QuarkBaellchen5/active-balancing/Dokumentation/Anleitung/Übersicht.jpeg

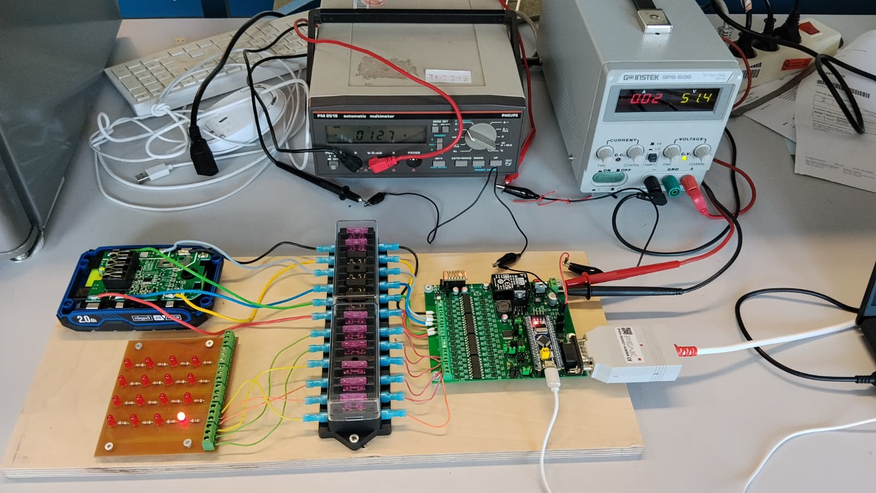
Dokumentation/Anleitung/Übersicht.jpeg
