QuarkBaellchen5/active-balancing/Dokumentation/Anleitung/Übersicht_Platine_2.png

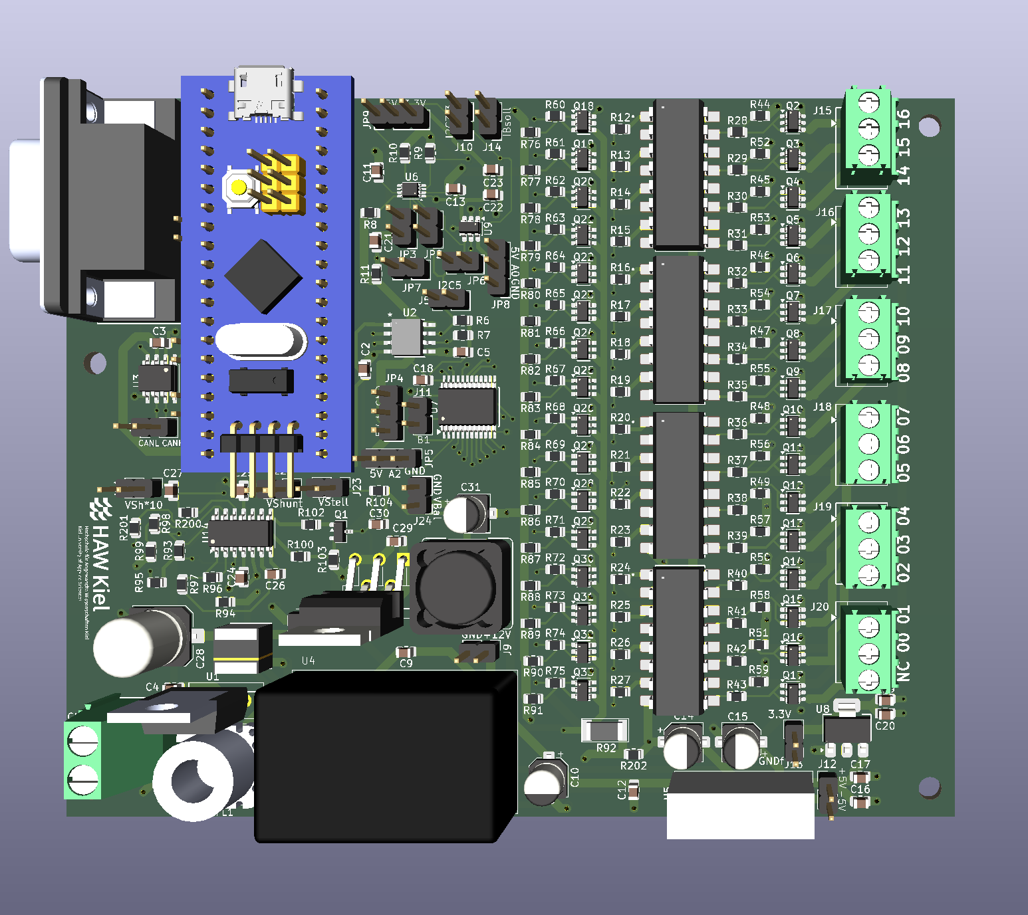
Dokumentation/Anleitung/Übersicht_Platine_2.png
