QuarkBaellchen5/active-balancing/Dokumentation/Ausgangspins.pptx

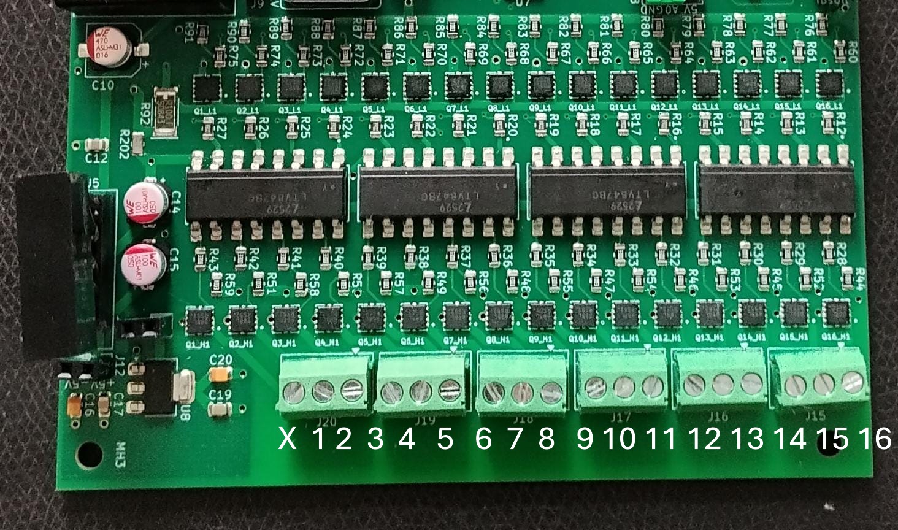
[picture p6: figure]

Lowside-MOSFET 1

Highside-MOSFET 1
