QuarkBaellchen5/active-balancing/Dokumentation/Thermische Analyse/Mosfet_thermische Simulation.pdf

TA4

30

RTH_JA1
52

PV4

PWL(0 0 10m 0.05 500 0.05 501 0.1125 1000 0.1125 1001 0.2 1500 0.2 1501 0.3125 2000 0.3125 2001 0.45 2500 0.45)

TA5

30

RTH_JA2
52

PV5

PWL(0 0 10m 0.067 500 0.067 501 0.151 1000 0.151 1001 0.268 1500 0.268 1501 0.41875 2000 0.41875 2001 0.603 2500 0.603)

Mosfet_high

Mosfet_low

Mosfet: (NTTFS6H888NL)

Junction-to-case: 6.4 W/°C

Junction-to-ambient: 52W/°C

Leistung:

Highside: Vgs = ca. 10V -> Rdson 41-50 mΩ Verlustleistung:

P1 = 0.050Ω * 1A^2 = 0.05W
P2 = 0.050Ω * 1.5A^2 = 0.1125W
P3 = 0.050Ω * 2A^2 = 0.2W
P4 = 0.050Ω * 2.5A^2 = 0.3125W
P5 = 0.050Ω * 3A^2 = 0.45W

Lowside: Vgs = 4.5-5V -> Rdson = 53-67 mΩ Verlustleistung:

P1 = 0.067Ω * 1A^2 = 0.067W
P2 = 0.067Ω * 1.5A^2 = 0.151W
P3 = 0.067Ω * 2A^2 = 0.268W P4 = 0.067Ω * 2.5A^2 = 0.41875W P5 = 0.067Ω * 3A^2 = 0.603W

Quelle: Datenblatt
