QuarkBaellchen5/active-balancing/Dokumentation/Thermische Analyse/Bilder Waerme/Wärmevergleich_Messung.pptx

Ohne Kühlkörper

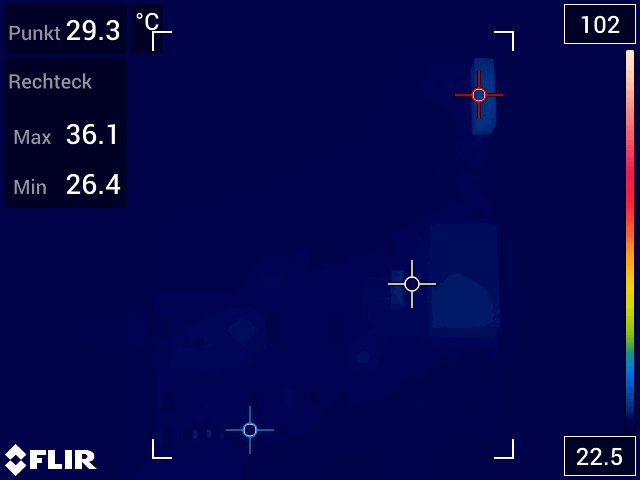
[picture p83: figure]

Regelstrom
0.0 A
0.1 A
0.5 A
1.0 A
1.5 A
2.0 A
2.5A

Mit Kühlkörper

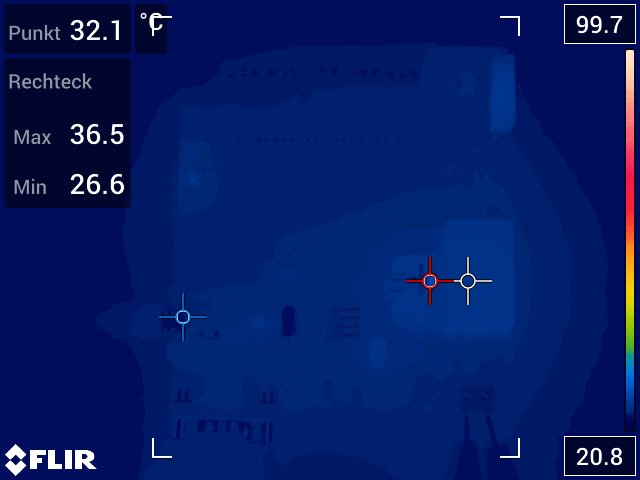
[picture p84: figure]
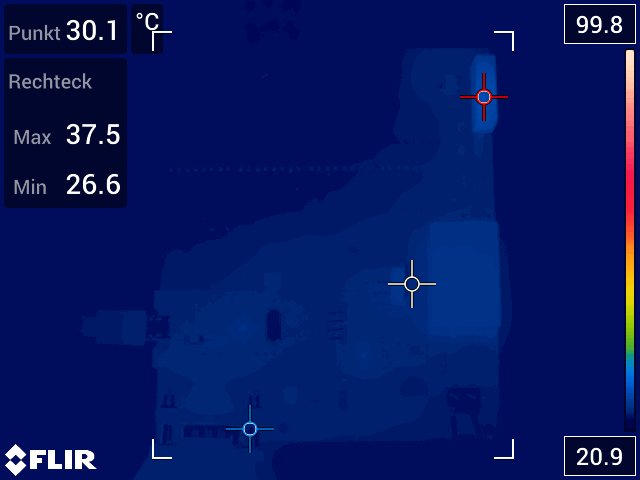
[picture p85: figure]
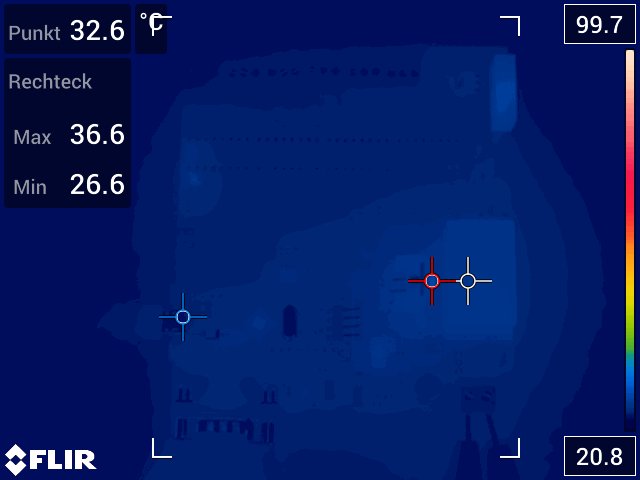
[picture p86: figure]
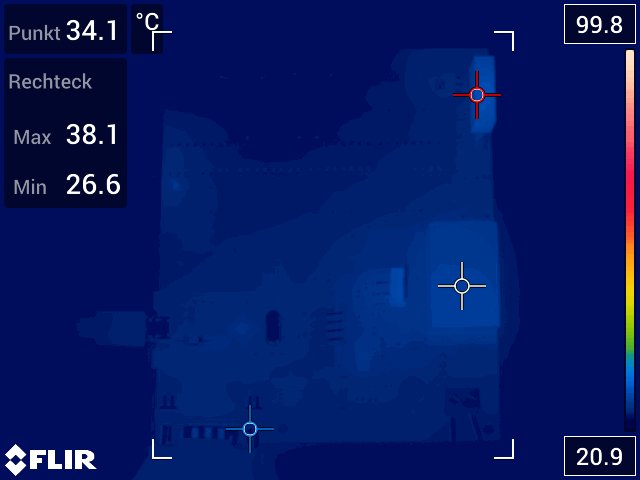
[picture p87: figure]
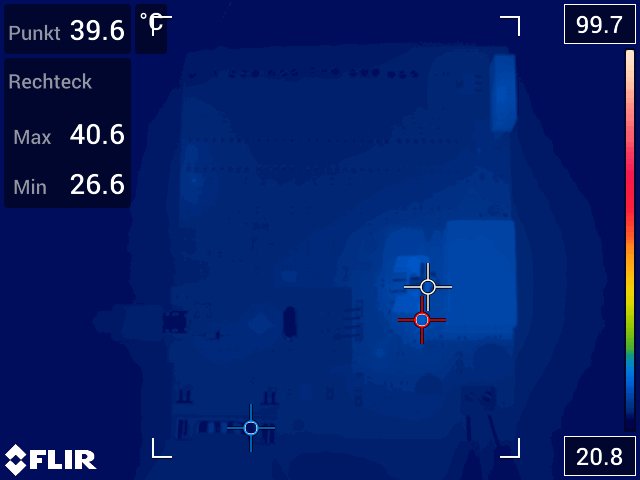
[picture p88: figure]
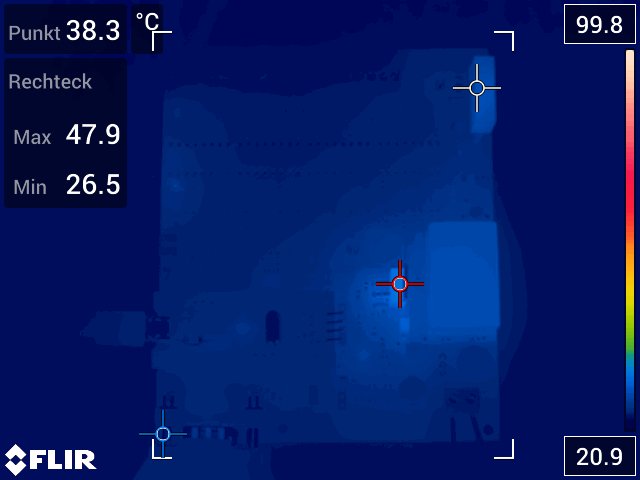
[picture p89: figure]
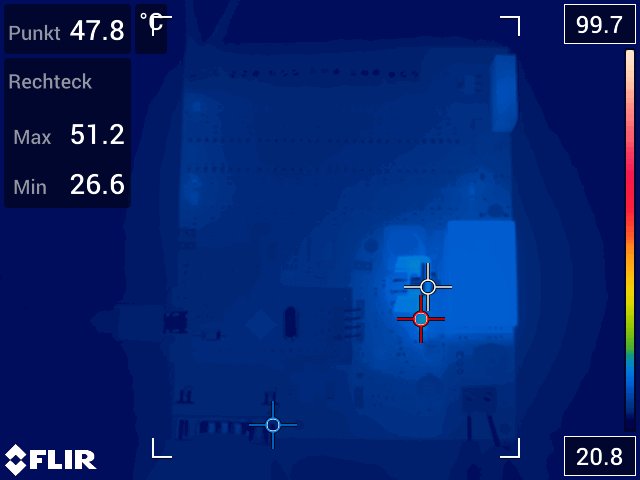
[picture p90: figure]
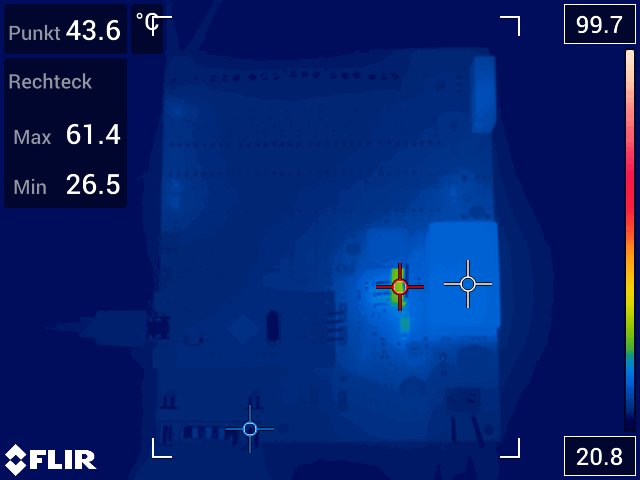
[picture p91: figure]
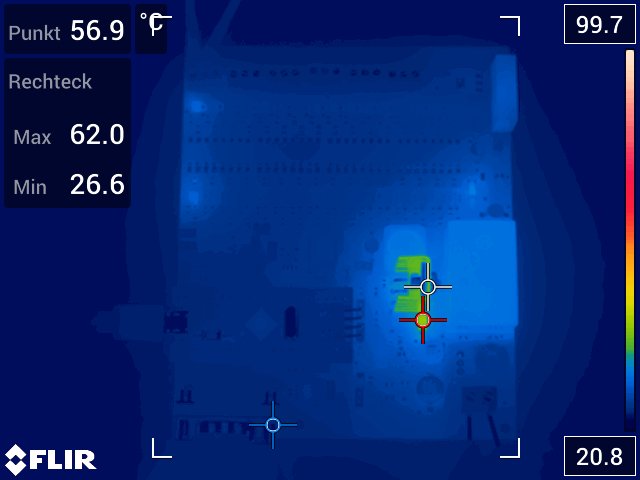
[picture p92: figure]
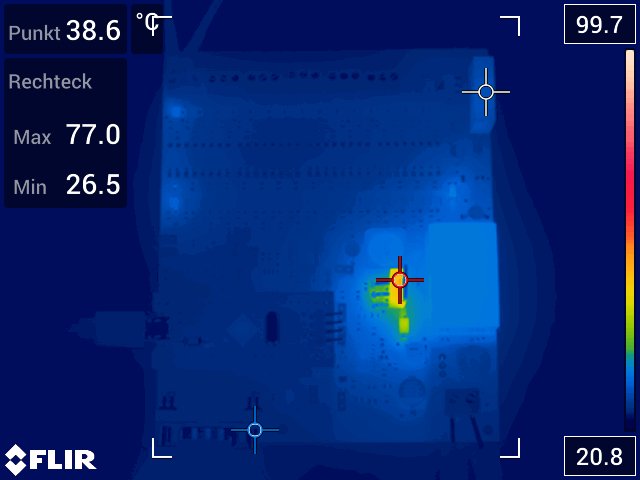
[picture p93: figure]
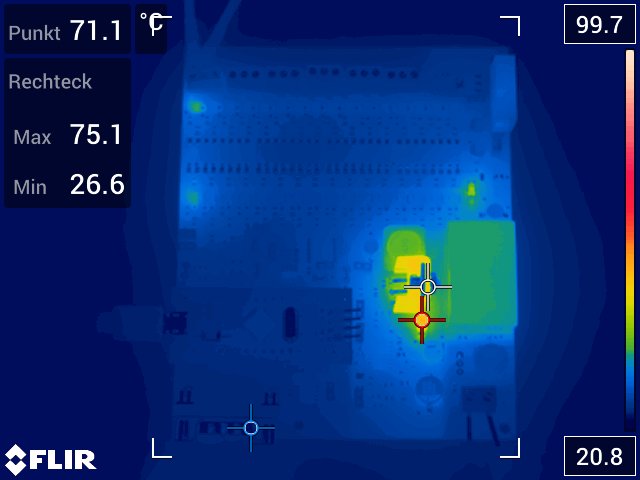
[picture p94: figure]
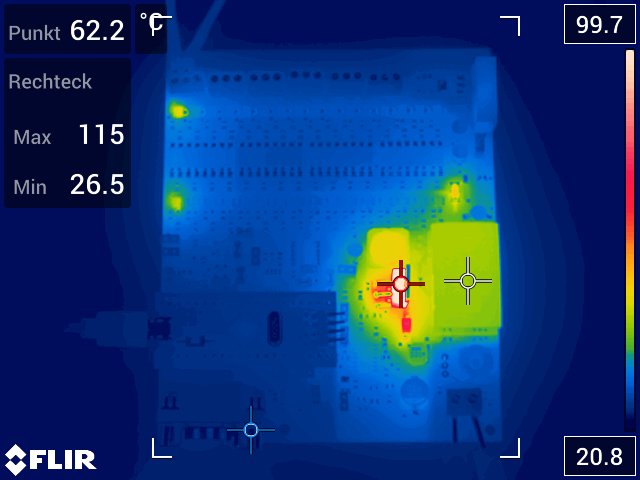
[picture p95: figure]
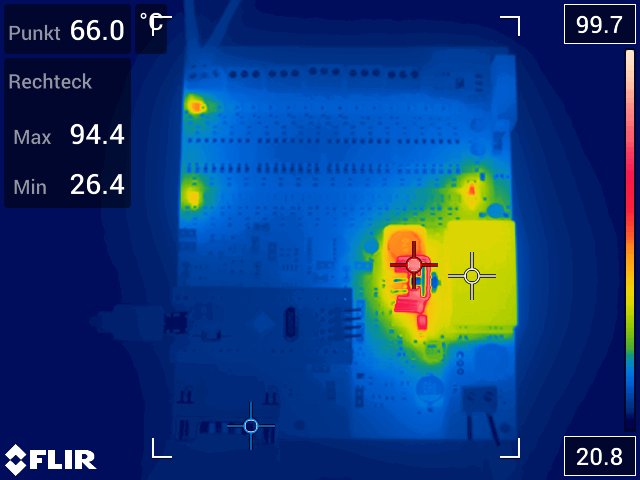
[picture p96: figure]
