QuarkBaellchen5/active-balancing/Aktive_Balancing/Photo_Voltaic_Isolators_prj/PVI5050N_schematic.jpg

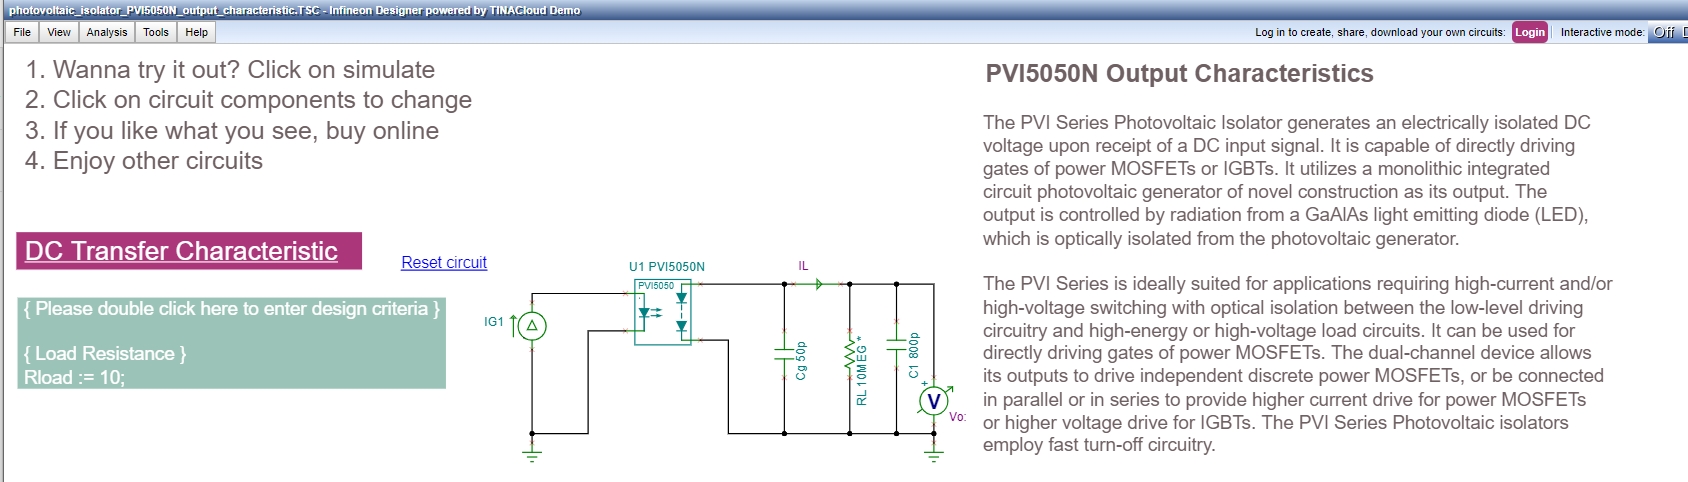
Aktive_Balancing/Photo_Voltaic_Isolators_prj/PVI5050N_schematic.jpg
