QuarkBaellchen5/active-balancing/Bilder Waerme/FLIR2031.jpg

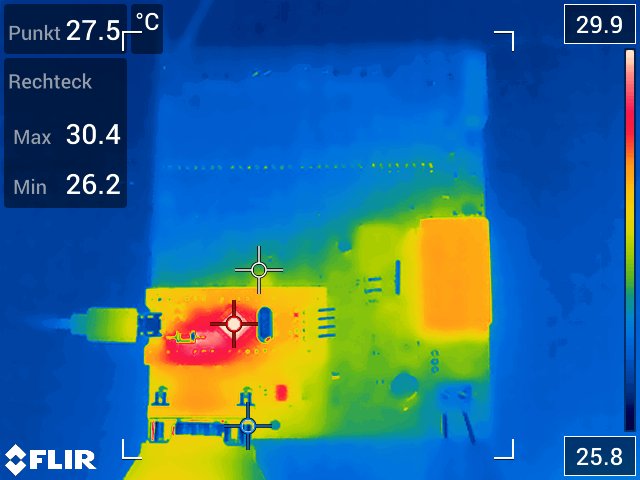
Bilder Waerme/FLIR2031.jpg
