QuarkBaellchen5/active-balancing/Bilder Waerme/FLIR2032.jpg

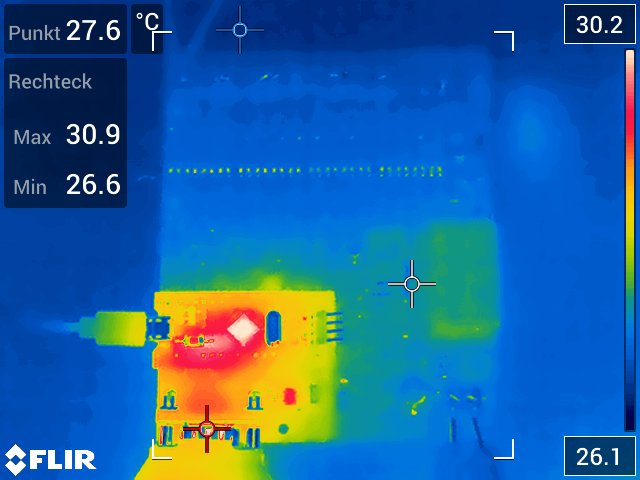
Bilder Waerme/FLIR2032.jpg
