QuarkBaellchen5/active-balancing/Dokumentation/Adapterplatine/adapter_oben.jpeg

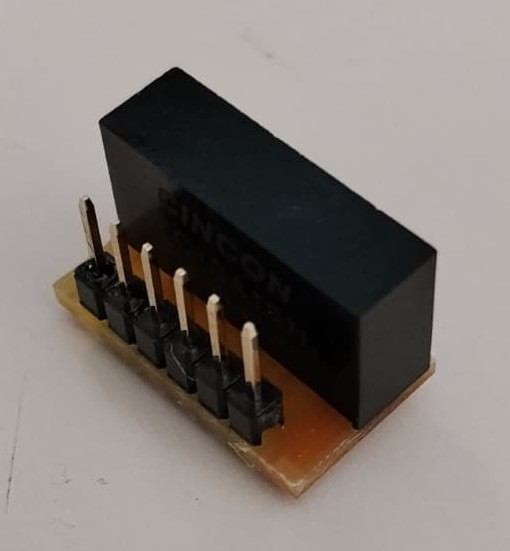
Dokumentation/Adapterplatine/adapter_oben.jpeg
