QuarkBaellchen5/active-balancing/Dokumentation/Adapterplatine/adapter_unten.jpeg

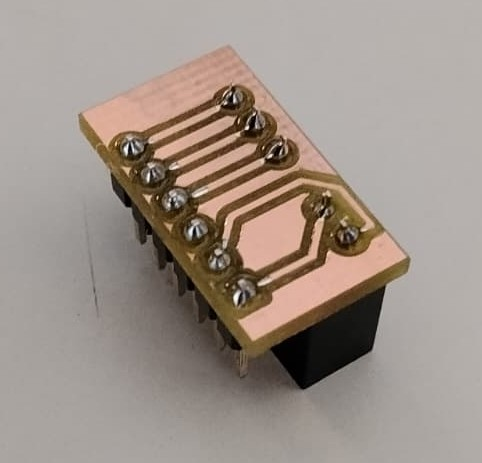
Dokumentation/Adapterplatine/adapter_unten.jpeg
