QuarkBaellchen5/active-balancing/Dokumentation/Adapterplatine/Adapterimplementierung2.jpeg

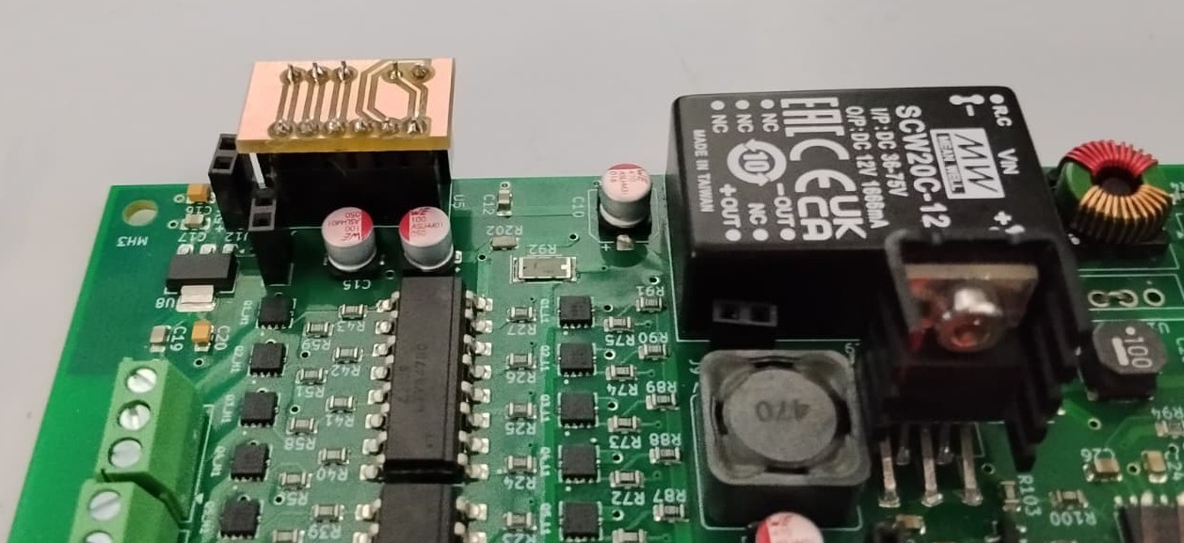
Dokumentation/Adapterplatine/Adapterimplementierung2.jpeg
