QuarkBaellchen5/active-balancing/Dokumentation/Adapterplatine/Adapterimplementierung.jpeg

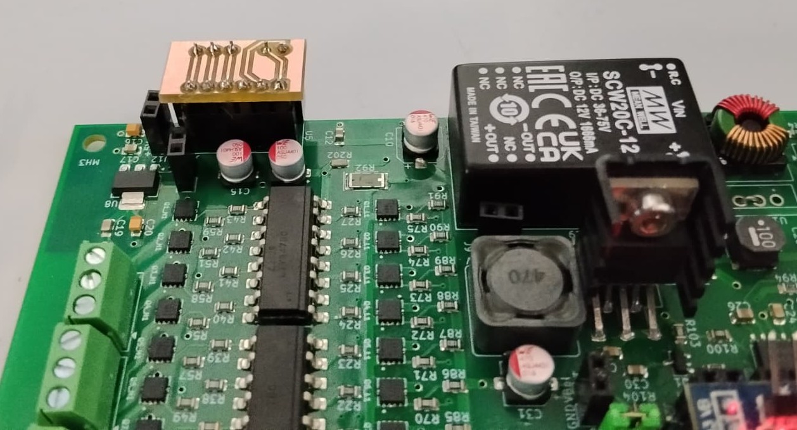
Dokumentation/Adapterplatine/Adapterimplementierung.jpeg
