QuarkBaellchen5/active-balancing/Dokumentation/Can_Kommunikation/Telegramm.png

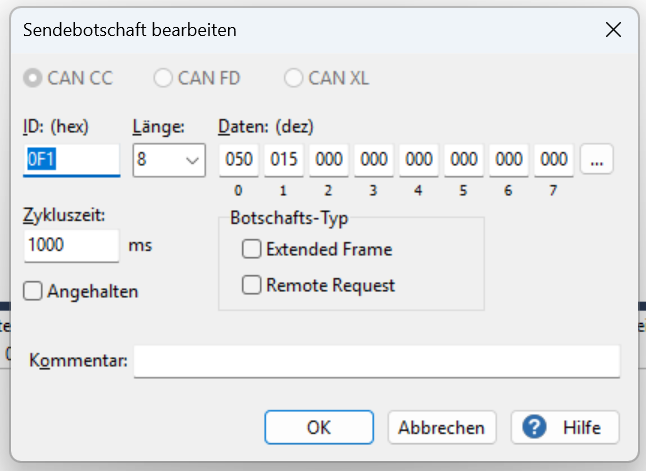
Dokumentation/Can_Kommunikation/Telegramm.png
