QuarkBaellchen5/active-balancing/Dokumentation/Can_Kommunikation/Telegramm_ausschalten.png

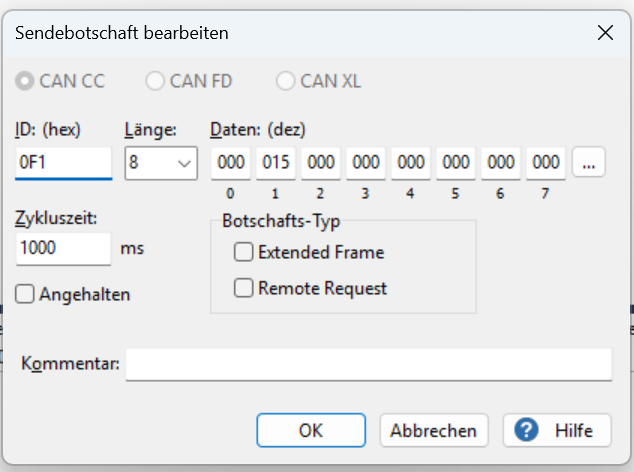
Dokumentation/Can_Kommunikation/Telegramm_ausschalten.png
