QuarkBaellchen5/active-balancing/Dokumentation/Can_Kommunikation/Übersicht.png

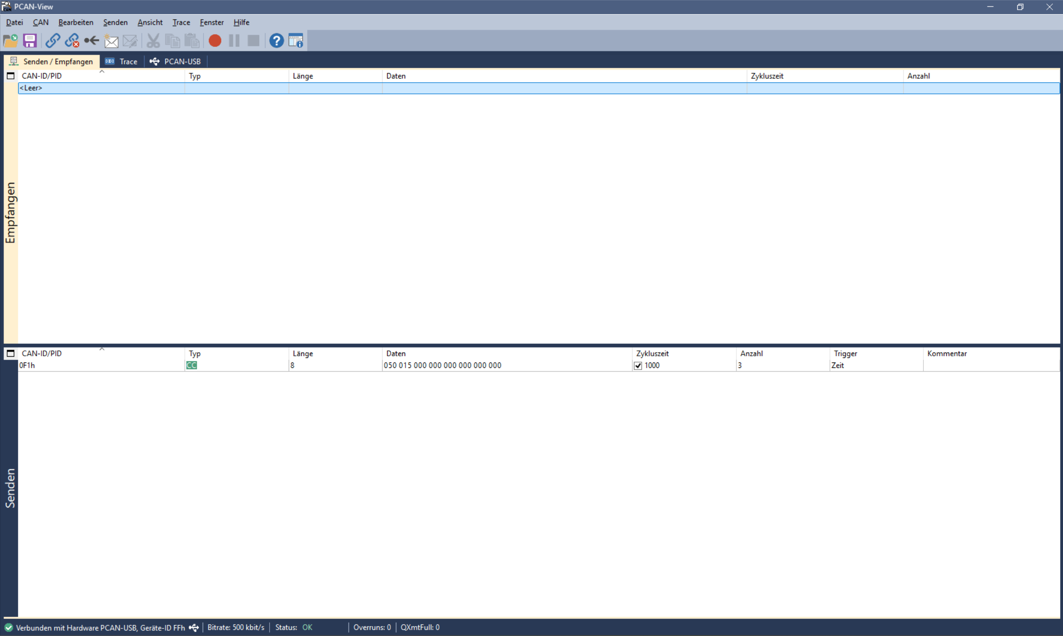
Dokumentation/Can_Kommunikation/Übersicht.png
