QuarkBaellchen5/active-balancing/Dokumentation/LED_oberseite.jpeg

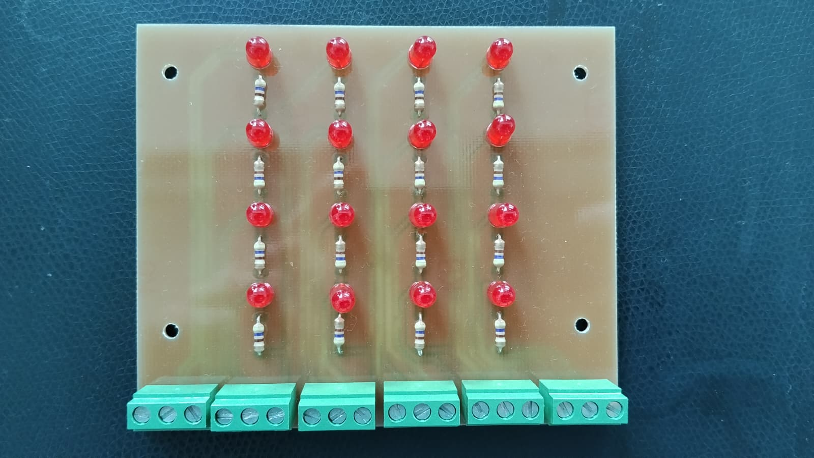
Dokumentation/LED_oberseite.jpeg
