QuarkBaellchen5/active-balancing/Dokumentation/LED_unterseite.jpeg

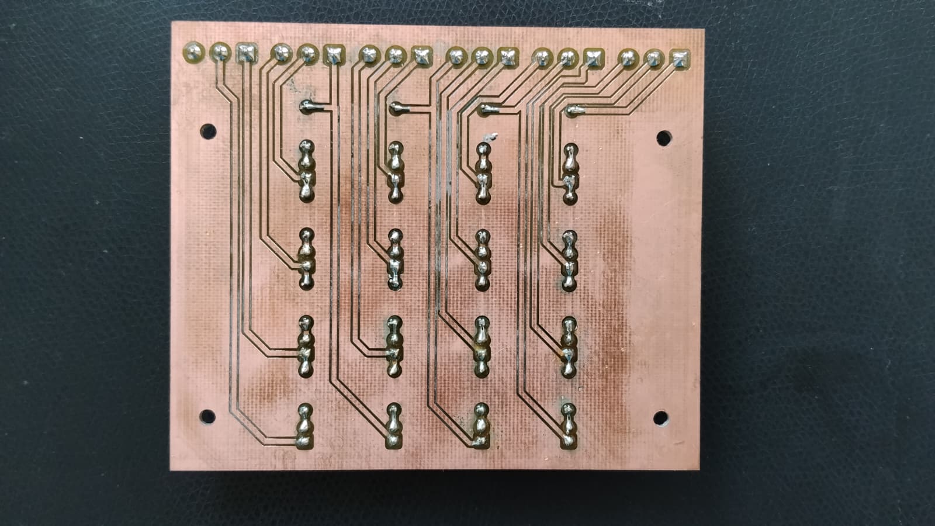
Dokumentation/LED_unterseite.jpeg
