QuarkBaellchen5/active-balancing/Dokumentation/Mosfet_Schaltbild.png

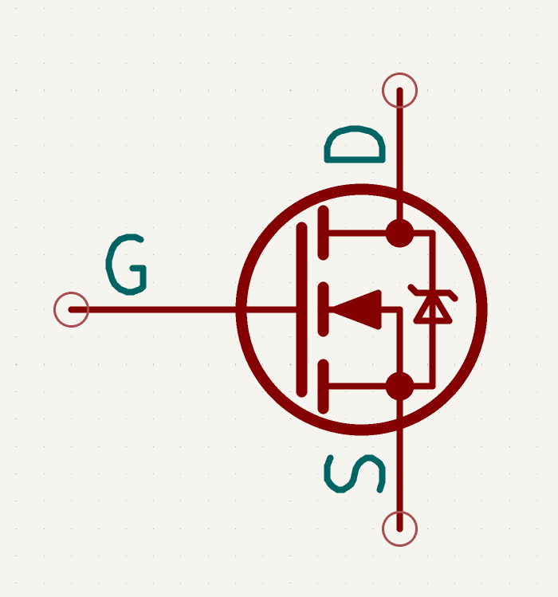
Dokumentation/Mosfet_Schaltbild.png
