QuarkBaellchen5/active-balancing/Dokumentation/Platine_fertig.jpeg

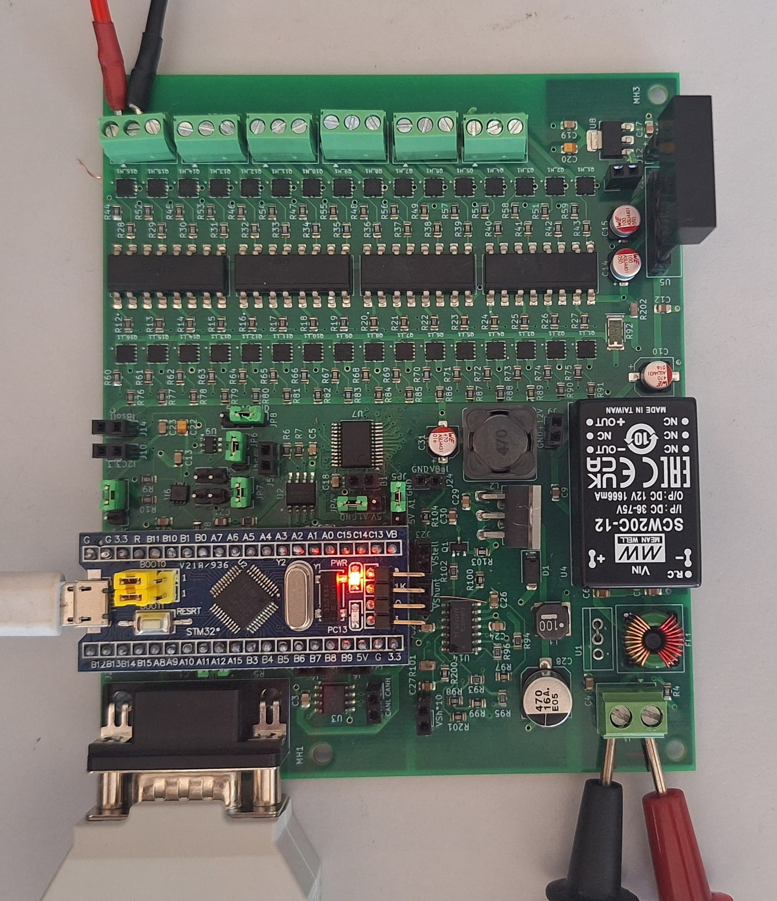
Dokumentation/Platine_fertig.jpeg
