QuarkBaellchen5/active-balancing/Dokumentation/Platine_nach_reflow.jpeg

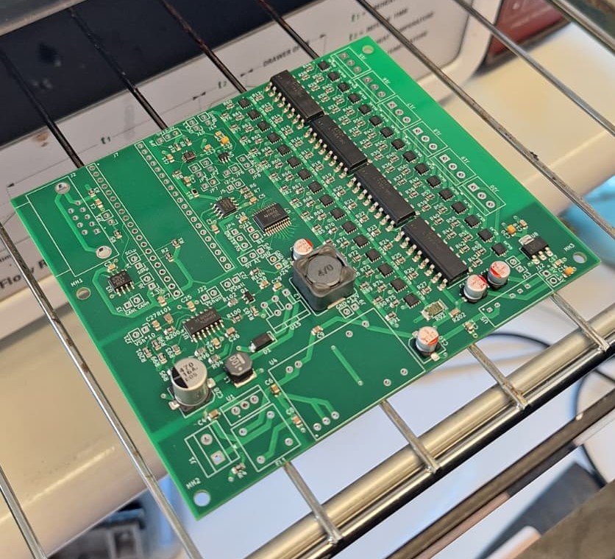
Dokumentation/Platine_nach_reflow.jpeg
