QuarkBaellchen5/active-balancing/Dokumentation/Platine_unbestückt.jpeg

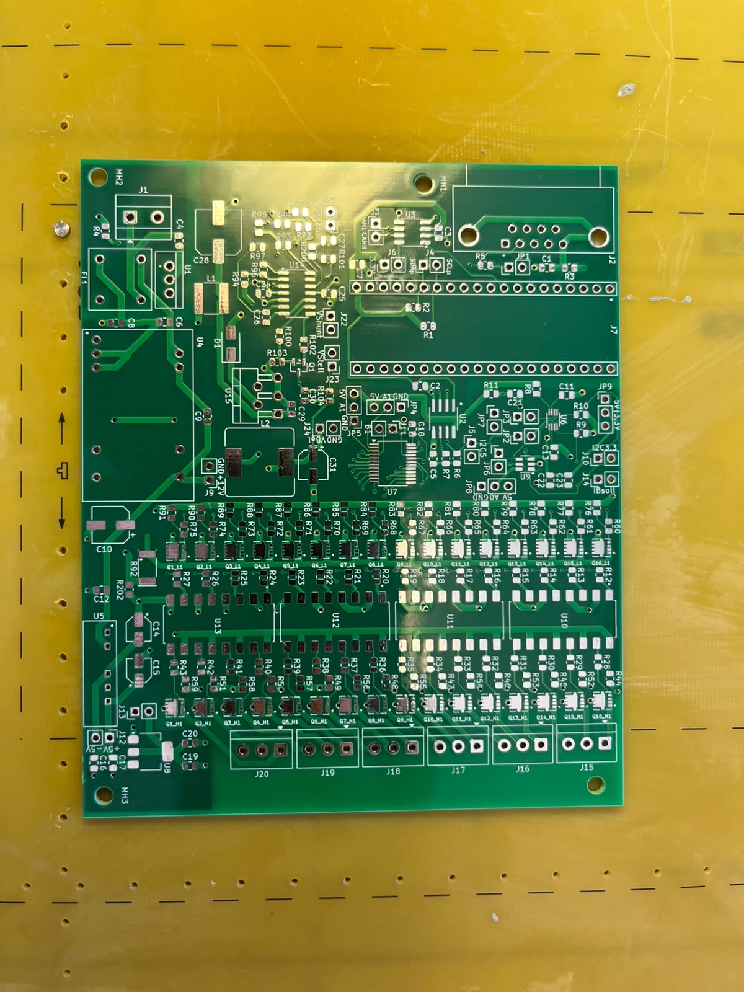
Dokumentation/Platine_unbestückt.jpeg
