QuarkBaellchen5/active-balancing/Dokumentation/Platine_unbestückt_Unterseite.jpeg

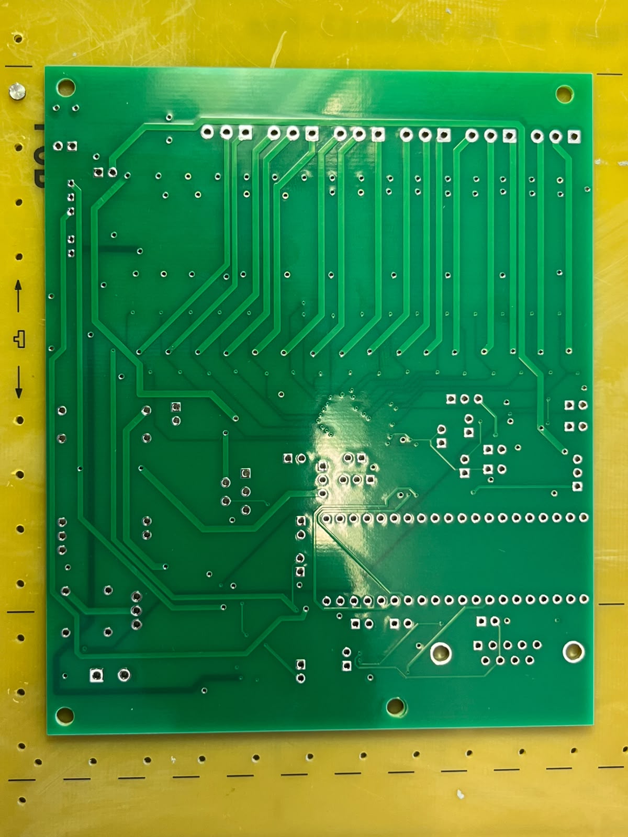
Dokumentation/Platine_unbestückt_Unterseite.jpeg
