QuarkBaellchen5/active-balancing/Dokumentation/Schaltplan und Layout/Layout_Doppelmosfet.png

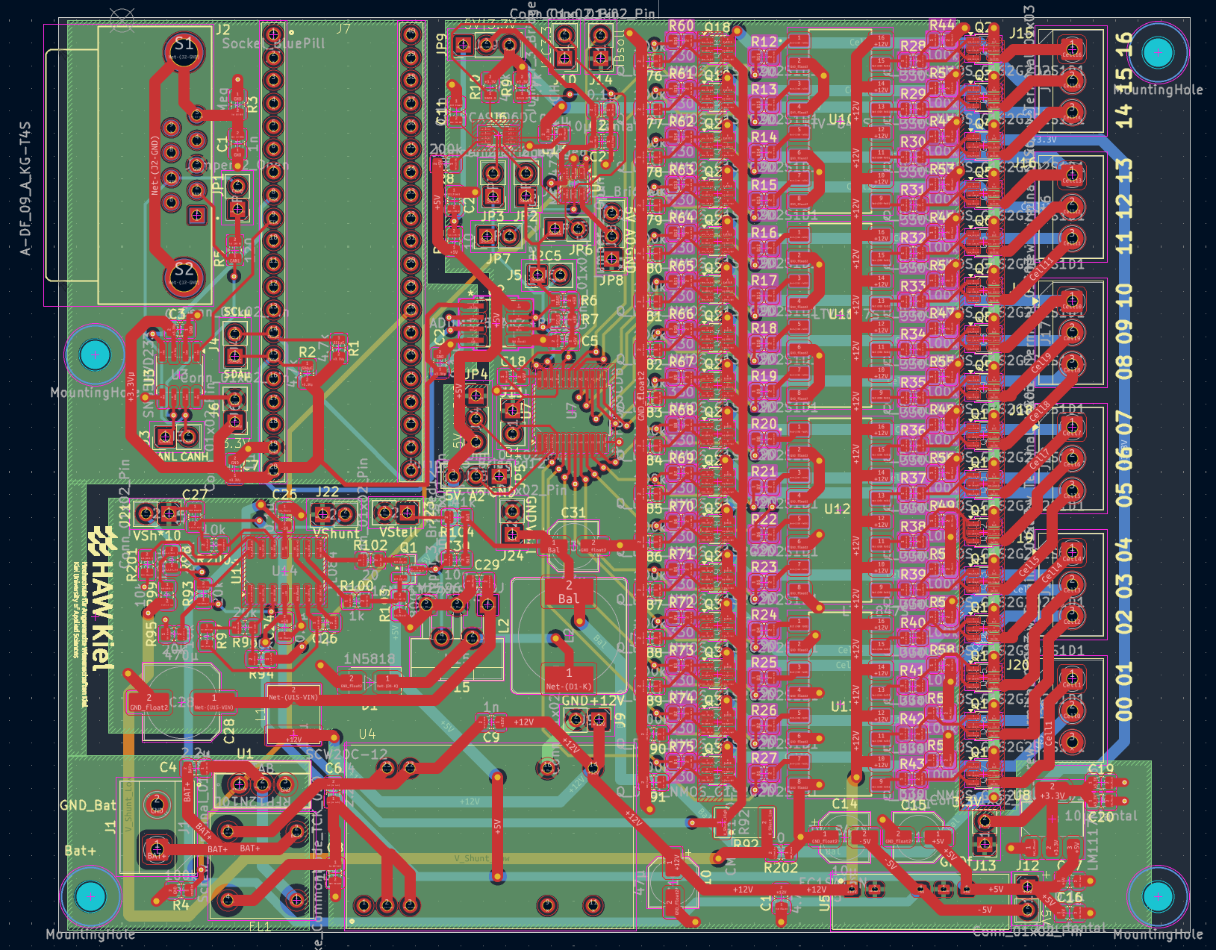
Dokumentation/Schaltplan und Layout/Layout_Doppelmosfet.png
