QuarkBaellchen5/active-balancing/Dokumentation/Thermische Analyse/Simulation_datenblatt.png

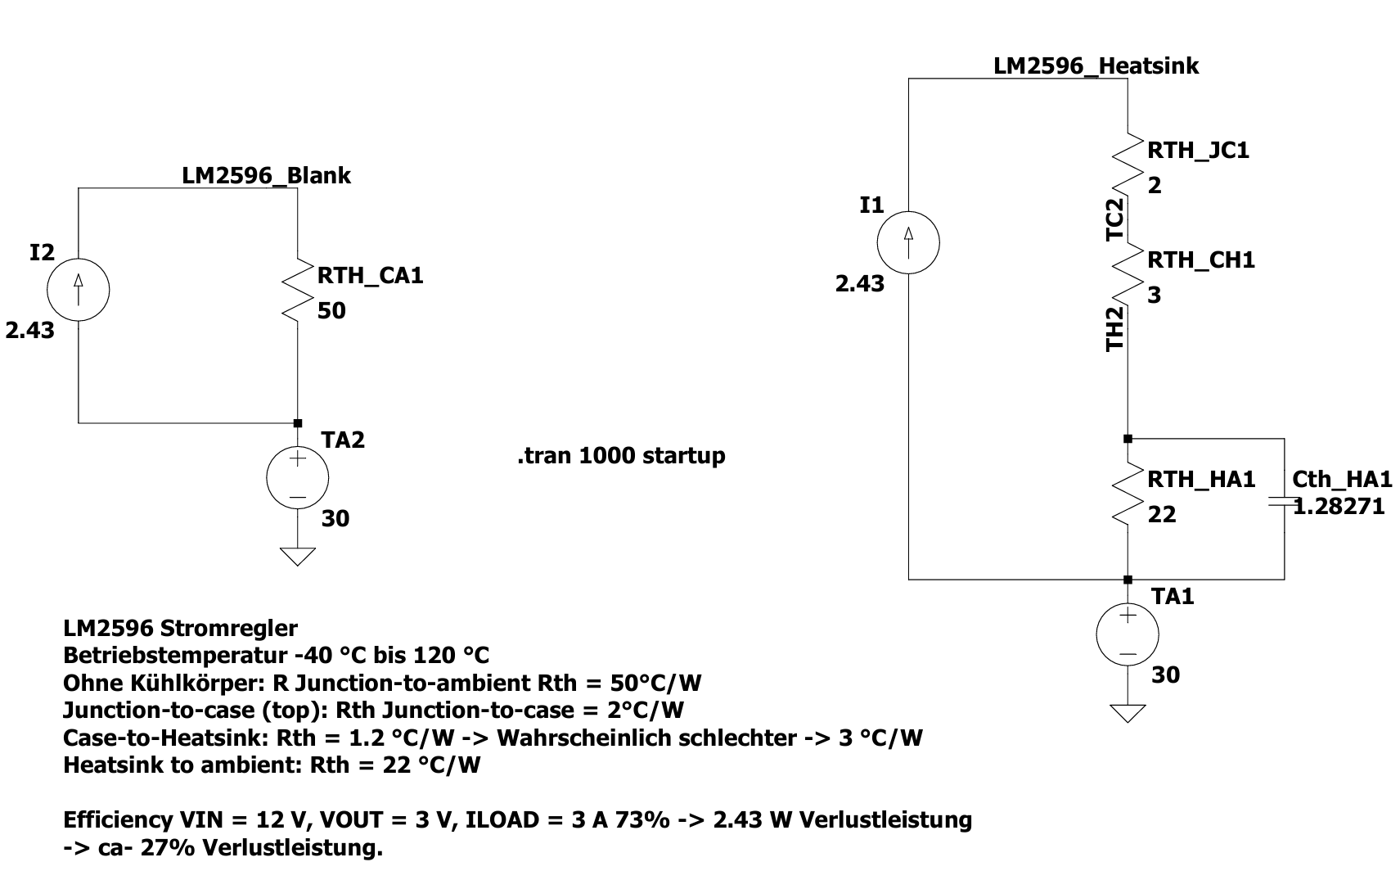
Dokumentation/Thermische Analyse/Simulation_datenblatt.png
