QuarkBaellchen5/active-balancing/Dokumentation/Vorwiderstand am Oktokoppler.png

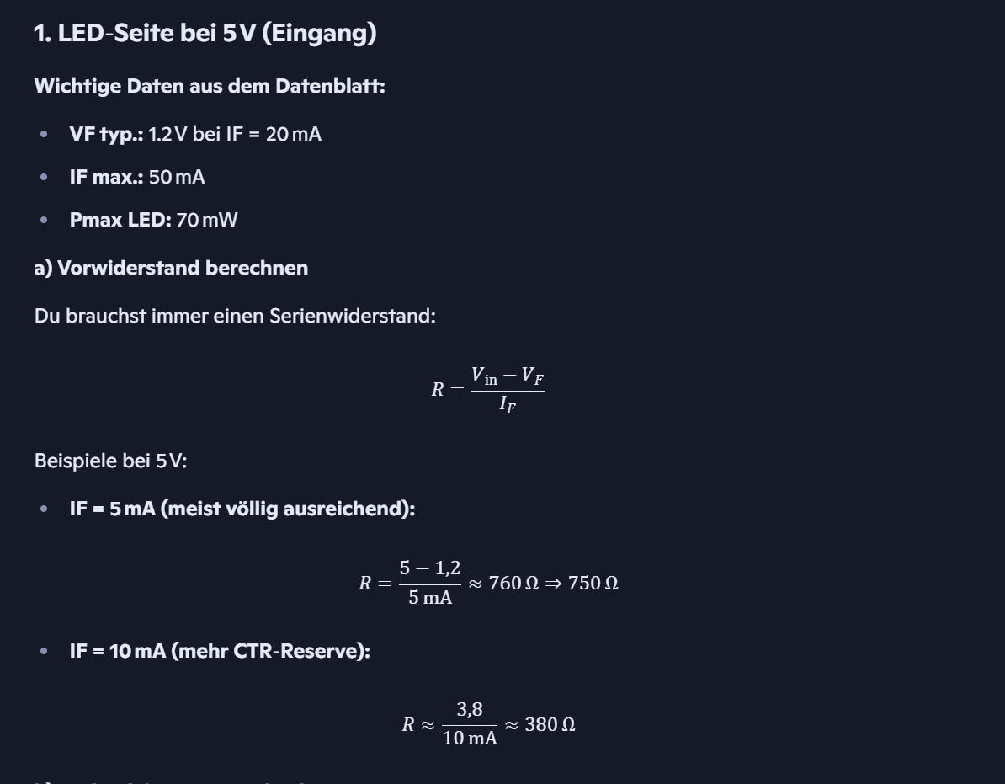
Dokumentation/Vorwiderstand am Oktokoppler.png
