QuarkBaellchen5/active-balancing/BM107/Labor_6_Schaltplan_Abgabe/BOM.xlsx

Reference | Qty | Value | DNP | Exclude from BOM | Exclude from Board | Footprint | Stückzahl für 10 Platinen | Kosten Stückzahl 10 (Preis pro 10 Stk*Stückzahl pro Platine) | Stückzahl für 100 Platinen | Kosten Stückzahl 100 (Preis pro 100 Stk*Stückzahl pro Platine) | Quelle
C1 | 1 | 22u Elko |  |  |  | Capacitor_SMD:CP_Elec_5x5.3 | 10 | 5.65 € | 100 | 38.62 € | https://www.digikey.de/de/products/detail/chemi-con/HHXD350ARA220ME61G/10486637
C2,C4,C6,C9,C10,C13,C16 | 7 | 0.1u |  |  |  | Capacitor_SMD:C_0805_2012Metric | 70 | 5.32 € | 700 | 32.55 € | https://www.digikey.de/de/products/detail/taiyo-yuden/GMK212BJ104KGHT/4157462
C3,C23,C24,C32,C33 | 5 | 10p |  |  |  | Capacitor_SMD:C_0805_2012Metric | 50 | 10.95 € | 500 | 72.50 € | https://www.digikey.de/de/products/detail/johanson-technology-inc/QSCT251Q100J1GV001E/1833671
C5,C7,C12,C15,C17,C18,C20,C21 | 8 | 10u Elko |  |  |  | Capacitor_SMD:CP_Elec_5x5.3 | 80 | 71.84 € | 800 | 5.03 € | https://www.digikey.de/de/products/detail/panasonic-industry/EEH-ZA1H100R/3088124
C8,C11 | 2 | 1u Elko |  |  |  | Capacitor_SMD:CP_Elec_5x5.3 | 20 | 36.00 € | 200 | 360.00 € | https://www.reichelt.de/de/de/shop/produkt/smd-elko_1_f_50v_85_c_2000h_20_-228472?PROVID=2788
C14,C19 | 2 | 1u tantal |  |  |  | Capacitor_SMD:C_0805_2012Metric | 20 | 27.70 € | 200 | 209.92 € | https://www.digikey.de/de/products/detail/kyocera-avx/TLCR105M035RTA/1950876
C22,C31 | 2 | 47u |  |  |  | Capacitor_SMD:C_0805_2012Metric | 20 | 9.32 € | 200 | 62.94 € | https://www.digikey.de/de/products/detail/panasonic-industry/EEH-ZC1V470P/3088062
C25,C34 | 2 | 4.7u |  |  |  | Capacitor_SMD:C_0805_2012Metric | 20 | 1.70 € | 200 | 10.48 € | https://www.digikey.de/de/products/detail/samsung-electro-mechanics/CL21A475KLCLQNC/5961206
C26,C27,C29,C30 | 4 | 5n |  |  |  | Capacitor_SMD:C_0805_2012Metric | 40 | 3.48 € | 400 | 21.40 € | https://www.digikey.de/de/products/detail/taiyo-yuden/GMK212B7224KGHT/4157461
C28,C35 | 2 | 220n |  |  |  | Capacitor_SMD:C_0805_2012Metric | 20 | 1.74 € | 200 | 10.70 € | https://www.digikey.de/de/products/detail/taiyo-yuden/GMK212B7224KGHT/4157461
D1,D2 | 2 | 1N4001 |  |  |  | Diode_THT:D_DO-41_SOD81_P10.16mm_Horizontal | 20 | 1.50 € | 200 | 9.20 € | https://www.digikey.de/de/products/detail/diotec-semiconductor/1N4001/13164614
D3,D6 | 2 | CD1408 |  |  |  | Aktive_Bal_Footprints:CD1408_Footprint | 20 | 3.88 € | 200 | 24.22 € | https://www.digikey.de/de/products/detail/bourns-inc/CD1408-R1200/3741985
D4,D5,D7,D8 | 4 | SS24 |  |  |  | Diode_SMD:D_SMA | 40 | 2.72 € | 400 | 59.56 € | https://www.digikey.de/de/products/detail/shenzhen-slkormicro-semicon-co-ltd/SS24/21853057
J1,J2,J5,J6 | 4 | PC5930T |  |  |  | Aktive_Bal_Footprints:PC5930T_Footprint | 40 | 220.92 € | 400 | 1877.76 € | https://www.digikey.de/de/products/detail/anderson-power-products-inc/PC5930T-BK/10650579
J3 | 1 | WAGO_1_5 |  |  |  | Connector_Wago:Wago_734-135_1x05_P3.50mm_Vertical | 10 | 22.12 € | 100 | 161.22 € | https://www.digikey.de/de/products/detail/wago-corporation/2086-3105/15517180
J4 | 1 | DE9_Pins_MountingHoles |  |  |  | Aktive_Bal_Footprints:D_SUB9_Stecker | 10 | 5.50 € | 100 | 80.68 € | https://www.digikey.de/de/products/detail/assmann-wsw-components/A-DF-09-A-KG-T4S/1241802
J7 | 1 | Sockel_BluePill |  |  |  | Aktive_Bal_Footprints:SockelBluepill Dupont leisten | 10 | 47.98 € | 100 | 479.80 € | https://www.az-delivery.de/en/products/stm32f103c8t6?variant=8196210917472
J8 | 1 | Conn_01x02_Pin |  |  |  | Connector_PinHeader_2.54mm:PinHeader_1x02_P2.54mm_Vertical | 10 | 0.68 € | 100 | 5.73 € | https://www.digikey.de/de/products/detail/harwin-inc/M20-9990246/3728226
JP1 | 1 | Jumper_2_Open |  |  |  | Jumper:SolderJumper-2_P1.3mm_Open_TrianglePad1.0x1.5mm | 10 | 0 € | 100 | 0 € | Lötverbinder direkt Kupfer auf Platine
Q1,Q2,Q3,Q4 | 4 | BSC016N06NS |  |  |  | Package_TO_SOT_SMD:TDSON-8-1 | 40 | 83.12 € | 400 | 574.32 € | https://www.digikey.de/de/products/detail/infineon-technologies/BSC016N06NSATMA1/3719792
R1 | 1 | 120 |  |  |  | Resistor_SMD:R_0805_2012Metric | 10 | 0.38 € | 100 | 1.93 € | https://www.digikey.de/de/products/detail/vishay-dale/CRCW08052K10FKEA/1175671
R2 | 1 | 2.1k |  |  |  | Resistor_SMD:R_0805_2012Metric | 10 | 0.38 € | 100 | 1.93 € | selber Preis
R3 | 1 | 240 |  |  |  | Resistor_SMD:R_0805_2012Metric | 10 | 0.38 € | 100 | 1.93 € | selber Preis
R4,R5 | 2 | R |  |  |  | Resistor_SMD:R_0805_2012Metric | 20 | 0.76 € | 200 | 3.86 € | selber Preis
R6,R7,R13,R14 | 4 | 100k |  |  |  | Resistor_SMD:R_0805_2012Metric | 40 | 1.52 € | 400 | 7.72 € | selber Preis
R8,R9,R20,R21 | 4 | 49 |  |  |  | Resistor_SMD:R_0805_2012Metric | 40 | 1.52 € | 400 | 7.72 € | selber Preis
R10,R22 | 2 | 2.2 |  |  |  | Resistor_SMD:R_0805_2012Metric | 20 | 0.76 € | 200 | 3.86 € | selber Preis
R11,R12,R15,R16 | 4 | 1.5 |  |  |  | Resistor_SMD:R_0805_2012Metric | 40 | 1.52 € | 400 | 7.72 € | selber Preis
R17,R18,R23,R24 | 4 | 100 |  |  |  | Resistor_SMD:R_0805_2012Metric | 40 | 1.52 € | 400 | 7.72 € | selber Preis
R26 | 1 | Shunt_BVT-M-R0005 |  |  |  | Aktive_Bal_Footprints:Shunt_BVT-M-R0005 | 10 | 14.16 € | 100 | 99.94 € | https://www.digikey.de/de/products/detail/isabellenhuette-usa/bvt-m-r0005-1-0/16733158
U1 | 1 | SN65HVD233 |  |  |  | Package_SO:SOIC-8_3.9x4.9mm_P1.27mm | 10 | 20.60 € | 100 | 169.83 € | https://www.digikey.de/de/products/detail/texas-instruments/SN65HVD233DR/1574509
U2 | 1 | LT1999-50 |  |  |  | Package_SO:MSOP-8_3x3mm_P0.65mm | 10 | 43.20 € | 100 | 359.00 € | https://www.mouser.de/ProductDetail/Analog-Devices/LT1999IS8-50PBF?qs=ytflclh7QUWcSqdZKCLSlg%3D%3D
U3 | 1 | R-78K15-0.5 |  |  |  | Converter_DCDC:Converter_DCDC_RECOM_R-78E-0.5_THT | 10 | 23 € | 100 | 200 € | https://www.mouser.de/ProductDetail/RECOM-Power/R-78K15-0.5?qs=Jm2GQyTW%2FbiCCXcaixC3IA%3D%3D
U4 | 1 | ADR3036 |  |  |  | Package_SO:MSOP-8_3x3mm_P0.65mm | 10 | 74.60 € | 100 | 636.00 € | https://www.mouser.de/ProductDetail/Analog-Devices/ADR3630BRMZ?qs=ulEaXIWI0c%2FOpFhuolg9VQ%3D%3D
U5 | 1 | LM317_SOT-223 |  |  |  | Package_TO_SOT_SMD:SOT-223-3_TabPin2 | 10 | 5.56 € | 100 | 43.60 € | https://www.mouser.de/ProductDetail/Texas-Instruments/LM317DCYRG3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
U6 | 1 | R-78K5.0-0.5 |  |  |  | Converter_DCDC:Converter_DCDC_RECOM_R-78E-0.5_THT | 10 | 23.12 € | 100 | 219 € | https://www.digikey.de/de/products/detail/recom-power/R-78K5-0-0-5/18093025
U7 | 1 | AD8031 |  |  |  | Package_TO_SOT_SMD:SOT-23-5 | 10 | 27.20 € | 100 | 226.00 € | https://www.mouser.de/ProductDetail/Analog-Devices/AD8031ARTZ-REEL7?qs=%2FtpEQrCGXCyXzqmvWf2VdQ%3D%3D
U8 | 1 | LD1117S33TR_SOT223 |  |  |  | Package_TO_SOT_SMD:SOT-223-3_TabPin2 | 10 | 2.40 € | 100 | 18.50 € | https://www.mouser.de/ProductDetail/STMicroelectronics/LD1117S33TR?qs=edoyzKMbmhntQZx4BFmoqw%3D%3D
U9,U10 | 2 | UCC27734 |  |  |  | Aktive_Bal_Footprints:SOIC-8_3.9x4.9mm_P1.27mm_UCC27734 | 20 | 20.60 € | 200 | 166 € | https://www.mouser.de/ProductDetail/Texas-Instruments/UCC27734QDRQ1?qs=PBDs2xEllI%2FilXPydpyARg%3D%3D
 |  |  |  |  |  |  |  | Stückpreis für eine Platine: |  | Stückpreis für eine Platine:
 |  |  |  |  |  |  |  | 80.34 € |  | 61.35 €
