QuarkBaellchen5/active-balancing/Bauteillisten/Bestellliste_DigiKey_V7.xlsx

DigiKey - Warenkorb
Index | Menge | Teilenummer | Hersteller-Teilenummer | Beschreibung | Kundenreferenz | Verfügbar | Lieferrückstände | Stückpreis | Gesamtpreis EUR
1 | 2 | 2034-1011-ND | EC1SA16N | DC DC CONVERTER +/-5V 1W |  | 2 | 0 | 3.25 | 6.50
2 | 2 | MCP4725A0T-E/CHCT-ND | MCP4725A0T-E/CH | IC DAC 12BIT SOT-23-6 |  | 2 | 0 | 1.08 | 2.16
3 | 2 | 296-SN65HVD233QDRQ1CT-ND | SN65HVD233QDRQ1 | IC TRANSCEIVER HALF 1/1 8SOIC |  | 2 | 0 | 3.16 | 6.32
4 | 2 | PCE3892CT-ND | EEE-1CA471UP | CAP ALUM 470UF 20% 16V SMD |  | 2 | 0 | 0.62 | 1.24
5 | 10 | 732-8416-1-ND | 865080342006 | CAP ALUM 47UF 20% 16V SMD |  | 10 | 0 | 0.17 | 1.70
6 | 2 | SRR1280-470MCT-ND | SRR1280-470M | FIXED IND 47UH 2.9A 80 MOHM SMD |  | 2 | 0 | 0.99 | 1.98
7 | 2 | B340A-FDICT-ND | B340A-13-F | DIODE SCHOTTKY 40V 3A SMA |  | 2 | 0 | 0.41 | 0.82
8 | 2 | 296-TL084HIDRCT-ND | TL084HIDR | IC OPAMP JFET 4 CIRCUIT 14SOIC |  | 2 | 0 | 0.3 | 0.60
9 | 100 | 488-NTTFS6H888NLTAGCT-ND | NTTFS6H888NLTAG | T8 80V LL U8FL |  | 100 | 0 | 0.3379 | 33.79
10 | 2 | BSS316NH6327XTSA1CT-ND | BSS316NH6327XTSA1 | MOSFET N-CH 30V 1.4A SOT23-3 |  | 2 | 0 | 0.26 | 0.52
11 | 2 | 1866-SCW20C-12-ND | SCW20C-12 | DC/DC CONVERTER |  | 2 | 0 | 16.36 | 32.72
12 | 10 | 13-RC0805FR-132K4LCT-ND | RC0805FR-132K4L | RES 2.4K OHM 1% 1/8W 0805 |  | 10 | 0 | 0.027 | 0.27
13 | 10 | 399-C0805C103K5RACTUCT-ND | C0805C103K5RACTU | CAP CER 10000PF 50V X7R 0805 |  | 10 | 0 | 0.051 | 0.51
14 | 2 | 4423-CMP-R100-1.0CT-ND | CMP-R100-1.0 | RESISTOR - ISA-PLAN SHUNT, 0.1, |  | 2 | 0 | 1.14 | 2.28
15 | 2 | 311-806CRCT-ND | RC0805FR-07806RL | RES 806 OHM 1% 1/8W 0805 |  | 2 | 0 | 0.08 | 0.16
16 | 10 | P20KDACT-ND | ERA-6AEB203V | RES SMD 20K OHM 0.1% 1/8W 0805 |  | 10 | 0 | 0.059 | 0.59
17 | 50 | 311-10.0KCRCT-ND | RC0805FR-0710KL | RES 10K OHM 1% 1/8W 0805 |  | 50 | 0 | 0.0162 | 0.81
18 | 10 | 311-1.00KCRCT-ND | RC0805FR-071KL | RES 1K OHM 1% 1/8W 0805 |  | 10 | 0 | 0.027 | 0.27
19 | 10 | 311-20.0CRCT-ND | RC0805FR-0720RL | RES 20 OHM 1% 1/8W 0805 |  | 10 | 0 | 0.027 | 0.27
20 | 10 | 1276-1029-1-ND | CL21B105KBFNNNE | CAP CER 1UF 50V X7R 0805 |  | 10 | 0 | 0.054 | 0.54
21 | 10 | 13-RC0805FR-104K7LCT-ND | RC0805FR-104K7L | RES 4.7K OHM 1% 1/8W 0805 |  | 10 | 0 | 0.027 | 0.27
22 | 2 | 505-ADUM1250ARZ-RL7CT-ND | ADUM1250ARZ-RL7 | DGTL ISOLTR 2.5KV 2CH I2C 8-SOIC |  | 2 | 0 | 6.4 | 12.80
23 | 2 | 296-18509-1-ND | PCA9306DCTR | IC XLTR VL BIDIR SM8 |  | 2 | 0 | 0.59 | 1.18
24 | 2 | LM1117IMPX-3.3/NOPBCT-ND | LM1117IMPX-3.3/NOPB | IC REG LIN 3.3V 800MA SOT-223-4 |  | 2 | 0 | 0.91 | 1.82
25 | 2 | 296-17856-1-ND | PCF8575DBR | IC XPNDR 400KHZ I2C SMBUS 24SSOP |  | 2 | 0 | 3.14 | 6.28
26 | 50 | 1276-1003-1-ND | CL21B104KBCNNNC | CAP CER 0.1UF 50V X7R 0805 |  | 50 | 0 | 0.0216 | 1.08
27 | 10 | 1276-2872-1-ND | CL21B106KOQNNNE | CAP CER 10UF 16V X7R 0805 |  | 10 | 0 | 0.11 | 1.10
28 | 10 | 478-3281-1-ND | TAJP106M010RNJ | CAP TANT 10UF 20% 10V 0805 |  | 10 | 0 | 0.304 | 3.04
29 | 10 | 1276-1014-1-ND | CL21C101JBANNNC | CAP CER 100PF 50V C0G/NP0 0805 |  | 10 | 0 | 0.034 | 0.34
30 | 20 | 399-C0805C102K5RACTUCT-ND | C0805C102K5RACTU | CAP CER 1000PF 50V X7R 0805 |  | 20 | 0 | 0.054 | 1.08
31 | 2 | 1276-1244-1-ND | CL21A475KAQNNNE | CAP CER 4.7UF 25V X5R 0805 |  | 2 | 0 | 0.09 | 0.18
32 | 2 | 1951-1073-ND | TCK-050 | CMC 325UH 3.3A 2LN TH |  | 2 | 0 | 5.27 | 10.54
33 | 2 | RFP12N10L-ND | RFP12N10L | MOSFET N-CH 100V 12A TO220-3 |  | 2 | 0 | 1.52 | 3.04
34 | 10 | A106060CT-ND | CRG0805F2K2 | RES SMD 2.2K OHM 1% 1/8W 0805 |  | 10 | 0 | 0.032 | 0.32
35 | 2 | 541-10.0CCT-ND | CRCW080510R0FKEA | RES SMD 10 OHM 1% 1/4W 0805 |  | 2 | 0 | 0.08 | 0.16
36 | 2 | YAG3706CT-ND | AC0805FR-07200KL | RES SMD 200K OHM 1% 1/8W 0805 |  | 2 | 0 | 0.08 | 0.16
37 | 2 | 311-47.0KCRCT-ND | RC0805FR-0747KL | RES 47K OHM 1% 1/8W 0805 |  | 2 | 0 | 0.08 | 0.16
38 | 2 | 311-120KCRCT-ND | RC0805FR-07120KL | RES 120K OHM 1% 1/8W 0805 |  | 2 | 0 | 0.08 | 0.16
39 | 2 | YAG3695CT-ND | AC0805FR-0715KL | RES SMD 15K OHM 1% 1/8W 0805 |  | 2 | 0 | 0.08 | 0.16
40 | 50 | A126365CT-ND | CRG0805F390R | RES SMD 390 OHM 1% 1/8W 0805 |  | 50 | 0 | 0.0198 | 0.99
41 | 2 | 13-RC0805FR-13120RLCT-ND | RC0805FR-13120RL | RES 120 OHM 1% 1/8W 0805 |  | 2 | 0 | 0.08 | 0.16
42 | 2 | LM2596T-ADJ-ND | LM2596T-ADJ | IC REG BUCK ADJ 3A TO220-5 |  | 2 | 0 | 6.26 | 12.52
43 | 2 | AE10924-ND | A-DF 09 A/KG-T4S | CONN D-SUB RCPT 9POS R/A SOLDER |  | 2 | 0 | 0.65 | 1.30
44 | 10 | 160-LTV-847S-BC-ND | LTV-847S-BC | OPTOISOLTR 5KV 4CH TRANS 16-SMD |  | 10 | 0 | 0.847 | 8.47
45 | 10 | 399-C0805C225K3RACTUCT-ND | C0805C225K3RACTU | CAP CER 2.2UF 25V X7R 0805 |  | 10 | 0 | 0.11 | 1.10
46 | 100 | 311-100KCRCT-ND | RC0805FR-07100KL | RES 100K OHM 1% 1/8W 0805 |  | 100 | 0 | 0.0145 | 1.45
47 | 100 | 311-330CRCT-ND | RC0805FR-07330RL | RES 330 OHM 1% 1/8W 0805 |  | 100 | 0 | 0.0145 | 1.45
48 | 10 | 311-1.0MARCT-ND | RC0805JR-071ML | RES 1M OHM 5% 1/8W 0805 |  | 10 | 0 | 0.027 | 0.27
49 | 2 | 732-10955-ND | 691137710002 | TERM BLK 2POS SIDE ENTRY 5MM PCB |  | 2 | 0 | 0.35 | 0.70
50 | 12 | 732-10956-ND | 691137710003 | TERM BLK 3POS SIDE ENTRY 5MM PCB |  | 12 | 0 | 0.498 | 5.98
51 | 20 | S7000-ND | PPTC021LFBN-RC | CONN HDR 2POS 0.1 TIN PCB |  | 20 | 0 | 0.195 | 3.90
52 | 2 | 587-2946-1-ND | NRS6045T100MMGK | FIXED IND 10UH 2.4A 59.8 MOHM |  | 2 | 0 | 0.24 | 0.48
