QuarkBaellchen5/active-balancing/Bauteillisten/Bauteile.xlsx

LM2596 Buck converter |  |  |  |  | Reichelt
Bezeichnung | Wert | Teilenummer | Preis 1Stk |  | Wert | Teilenummer | Preis
Eingangselko | 470uF | UWT1C471MNL1GS | 0.50 € |  | 470uF | ECC HXC160ARA471 | 0.68 €
Ausgangselko | 47uF | 865080342006 | 0.17 € |  | 47uF | PXA 47/20 | 0.71 €
Induktivität | 47uH | DR125-470-R | 0.71 € |  | 47uH | L-PISA4728 47µ | 1.70 €
Schottky-Diode | 3A | B340A-FDICT-ND | 0.33 € |  | 3A | SS 34 | 0.27 €
FB-Widerstand | 100mW | RMCF0603FT2K40 | 0.09 € |  | 100mW | SPR-0603 2,40K | 0.35 €
C3 | 10nF | C0603C103K5RACTU | 0.09 € |  | 10nF | KEM X7R0603 10N | 0.06 €
Widerstand am Mosfet | 806 Ohm | RMCF0402FT806R | 0.09 €
M1 an der OPV Regelung mit Variablem Rd - alternative zu BSB012N03MX3 besonders gute lineare eigenschaften und kleine Kapazitäten
M1 angesteuert von OPV |  | AO3400A | 0.45 €
alternativ |  | BSS316NH6327XTSA1 | 0.25 €
Shunt Widerstand | 200mOhm | CMP-R200-1.0 | 1.15 €
Mosfet | Rdson = 50mOhm | NTTFS6H888NLTAG | 0.49 € | 10Stk
OPV Schaltung
4-Fach OPV | 4 Schaltkreise | TL084HIDR | 0.29 €
Widerstände OPV 1 | 20kOhm | RC0402FR-0720KL | 0.09 € | 4x benötigt
Widerstand zw. OPS | 10kOhm | RC0402FR-0710KL | 0.09 €
Rückkopplung OPV3 | 1kOhm | RC0402FR-071KL | 0.09 €
Rgs | 20Ohm | RC0402FR-1320RL | 0.09 €
C4 an OPV2 | 1uF | CL05A105KO5NNNC | 0.09 €
Isolated DC.DC 36…72V -> 12V |  | SCW20C-12 | 16.57 €
I2C Expander | 16Bit | MCP23017-E/SO | 1.39 €
Isolated I2C Digital analog wandler DAC |  | MCP4725A0T-E/CH | 1.09 €
2x Pull-Up Widerstände nach VDD | 4.7kOhm | RC0402FR-074K7L | 0.09 € | 2x benötigt
Capacitor zwischen VDD und GND | 100nF | CL05B104KP5NNNC | 0.09 €
Isolated I2C Modul zum Koppeln
ADuM1250 |  | ADUM1250ARZ-RL7
2x Pull-Up Widerstände nach VDD | 4.7kOhm | RC0402FR-074K7L | 0.09 € | 4x -> auf jeder Seite 2
Capacitor zwischen VDD und GND | 100nF | CL05B104KP5NNNC | 0.09 € | 2x jeweils auf jeder seite 1
