QuarkBaellchen5/active-balancing/Aktive_Balancing/KiCAD/ten5_dual_3d_drawing.stp

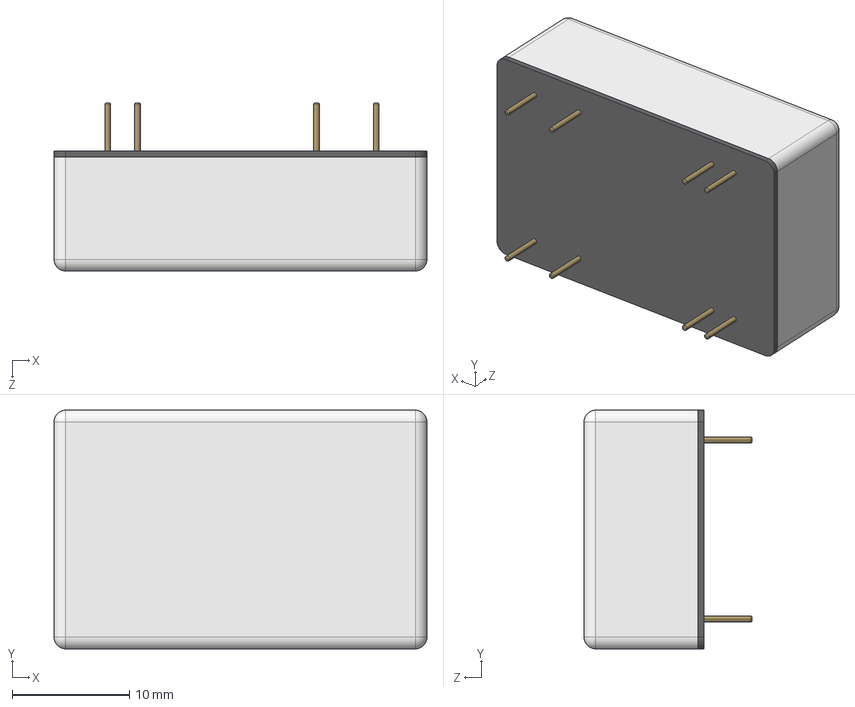
[picture p133: CAD file, 2026-04-06]
Aktive_Balancing/KiCAD/ten5_dual_3d_drawing.stp
31.8 x 20.3 x 14.3 mm
Case
Base
Pin2
Pin3
Pin16
Pin9
Pin11
Pin14
Pin22
Pin23
