QuarkBaellchen5/active-balancing/BM107/Anderson_Printmontage_KiCAD/PC5930T/PC5930T.step

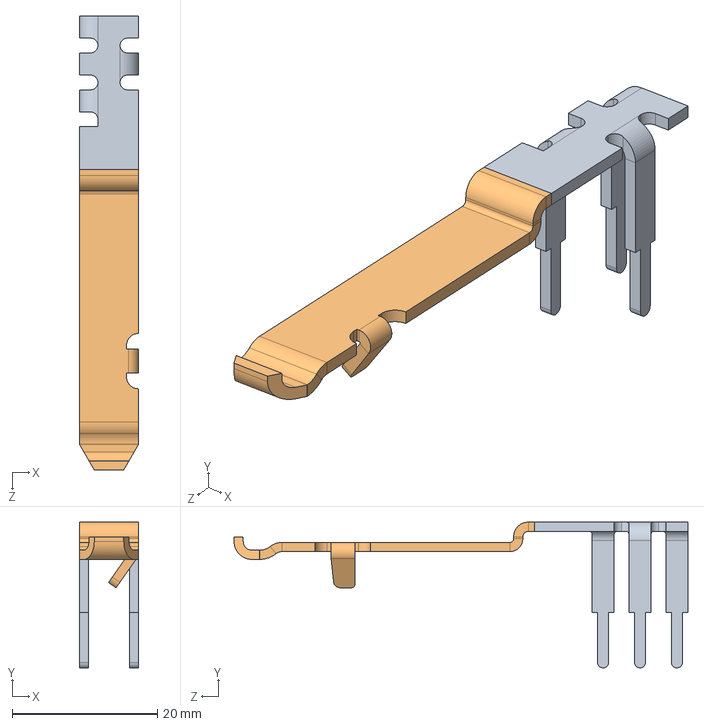
[picture p134: CAD file, 2026-06-11]
BM107/Anderson_Printmontage_KiCAD/PC5930T/PC5930T.step
8.13 x 20.1 x 62.5 mm
