QuarkBaellchen5/active-balancing/KiCad/Aktive_Bal_Bericht - V8 - Doppelmosfet/3d models/EC1SAN DIP.STEP

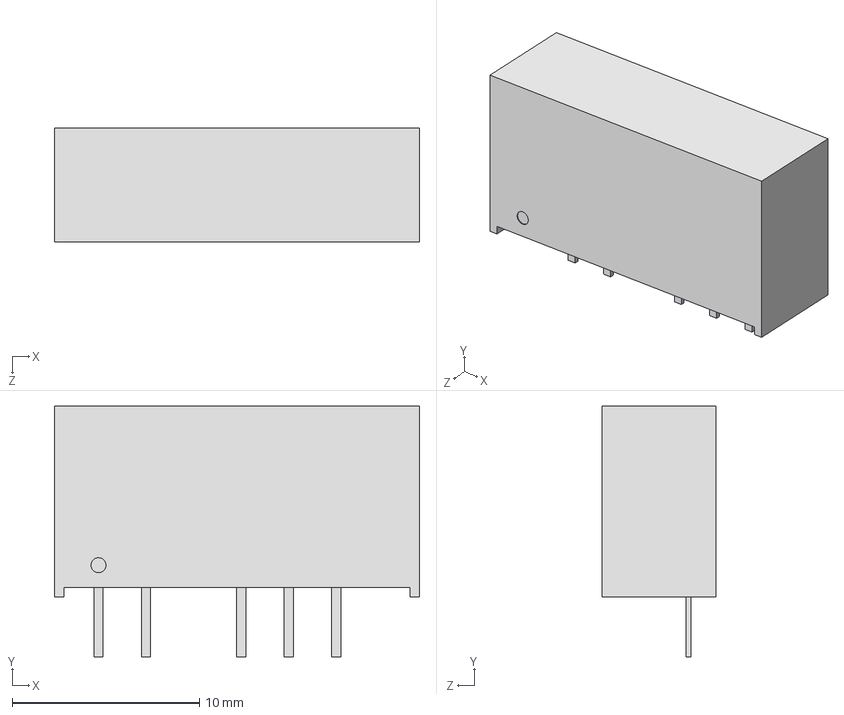
[picture p135: CAD file, 2026-07-29]
KiCad/Aktive_Bal_Bericht - V8 - Doppelmosfet/3d models/EC1SAN DIP.STEP
19.5 x 13.4 x 6.10 mm
