QuarkBaellchen5/active-balancing/KiCad/Aktive_Bal_Bericht - V8 - Doppelmosfet/Rohdaten_Bauteile/A_DF_09_A_KG_T4S/A-DF_09_A_KG-T4S.step

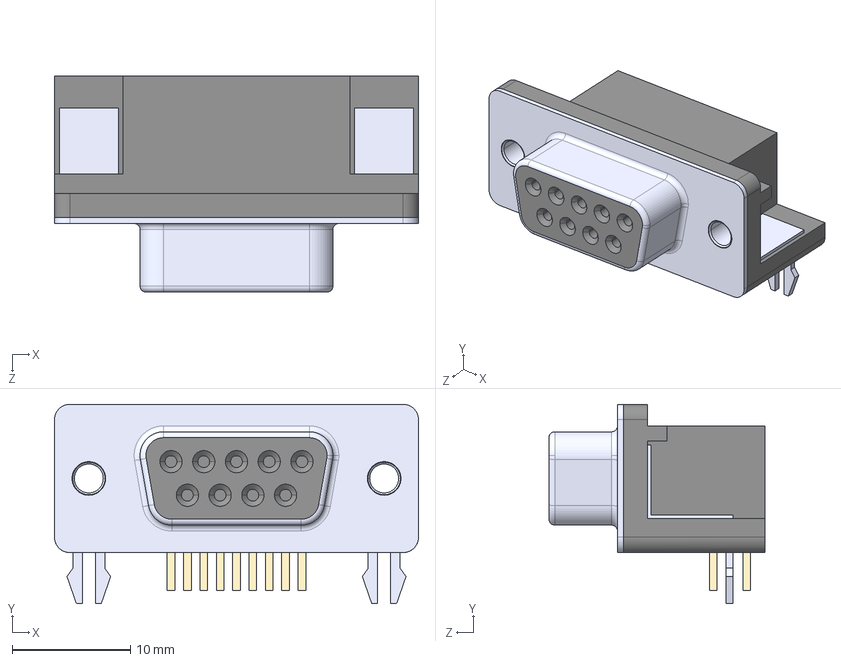
[picture p136: CAD file, 2026-05-13]
KiCad/Aktive_Bal_Bericht - V8 - Doppelmosfet/Rohdaten_Bauteile/A_DF_09_A_KG_T4S/A-DF_09_A_KG-T4S.step
30.8 x 16.9 x 18.3 mm
