QuarkBaellchen5/active-balancing/KiCad/Aktive_Bal_Bericht - V8 - Doppelmosfet/Rohdaten_Bauteile/PCF8575CDB/DB0024A.stp

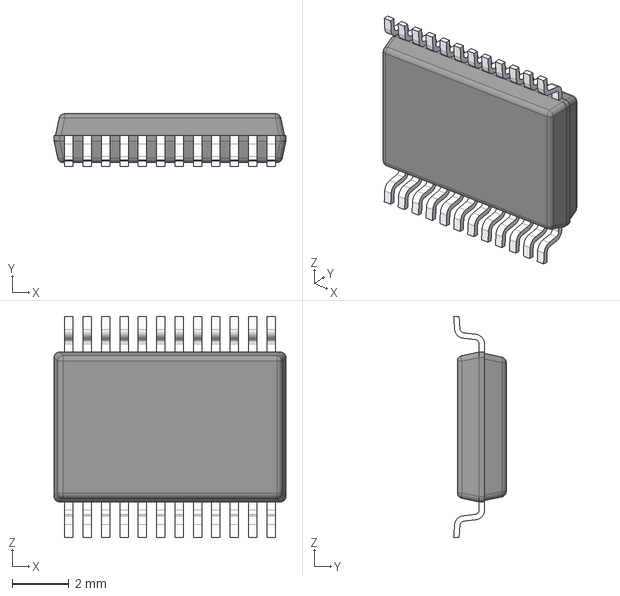
[picture p137: CAD file, 2026-05-13]
KiCad/Aktive_Bal_Bericht - V8 - Doppelmosfet/Rohdaten_Bauteile/PCF8575CDB/DB0024A.stp
8.20 x 1.86 x 7.83 mm
BODY_MSA24
LEAD_MSA24 x 24
