QuarkBaellchen5/active-balancing/KiCad/Aktive_Bal_Bericht - V8 - Doppelmosfet/Rohdaten_Bauteile/RFP12N10L/TO-220AB_ONS.step

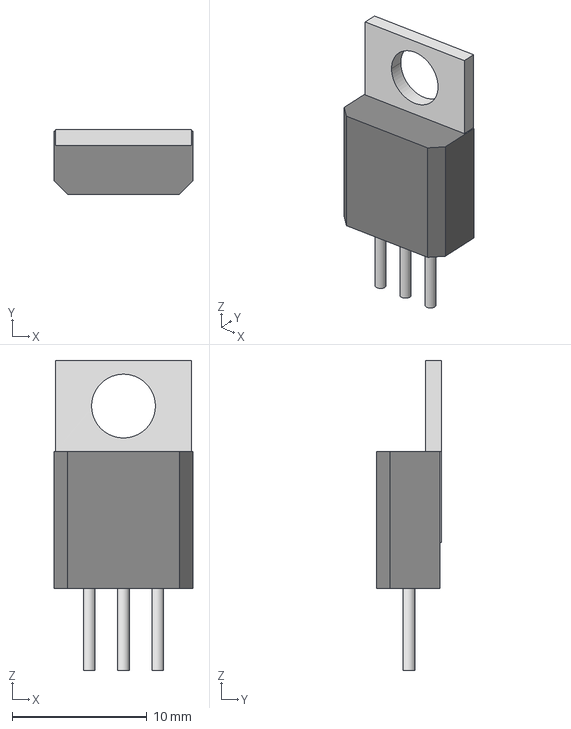
[picture p138: CAD file, 2026-05-13]
KiCad/Aktive_Bal_Bericht - V8 - Doppelmosfet/Rohdaten_Bauteile/RFP12N10L/TO-220AB_ONS.step
10.3 x 4.83 x 23.0 mm
