QuarkBaellchen5/active-balancing/KiCad/Aktive_Bal_Bericht - V8 - Doppelmosfet/3d models/SCW20.step

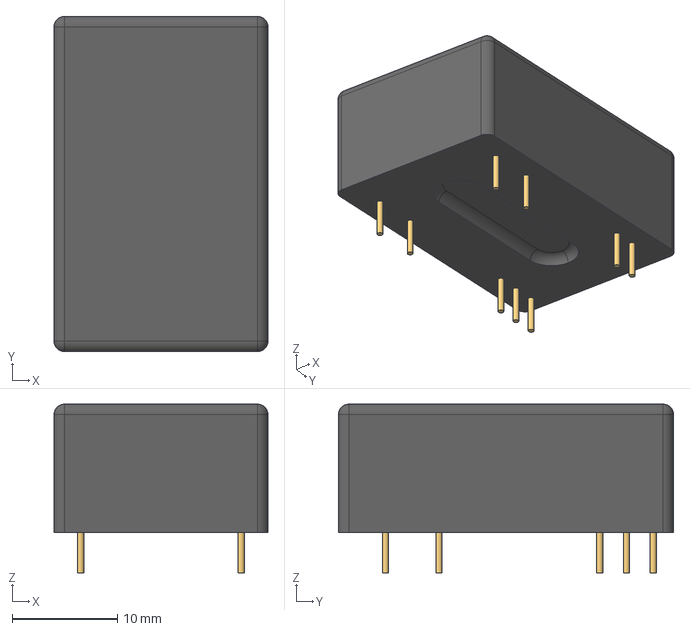
[picture p140: CAD file, 2026-07-29]
KiCad/Aktive_Bal_Bericht - V8 - Doppelmosfet/3d models/SCW20.step
20.3 x 31.8 x 16.0 mm
