QuarkBaellchen5/active-balancing/KiCad/Aktive_Bal_Bericht - V8 - Doppelmosfet/3d models/IND_TAIYO_NRS6045_TAY.step

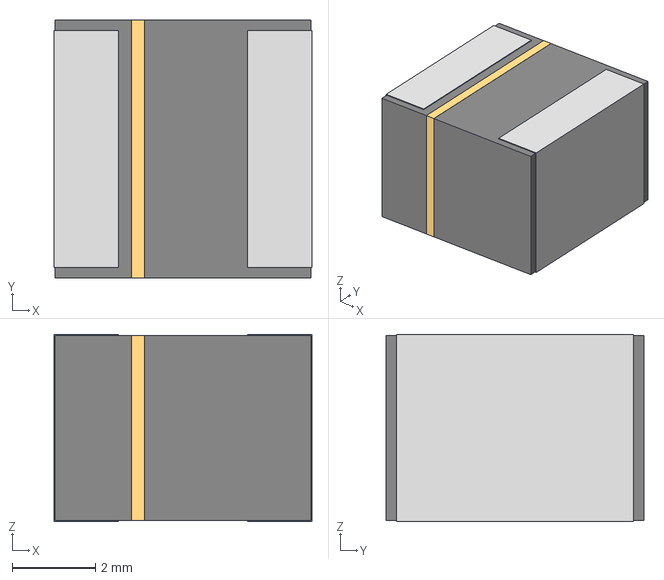
[picture p141: CAD file, 2026-07-29]
KiCad/Aktive_Bal_Bericht - V8 - Doppelmosfet/3d models/IND_TAIYO_NRS6045_TAY.step
6.20 x 6.20 x 4.50 mm
