QuarkBaellchen5/active-balancing/KiCad/Aktive_Bal_Bericht - V8 - Doppelmosfet/3d models/IRF9640.STEP

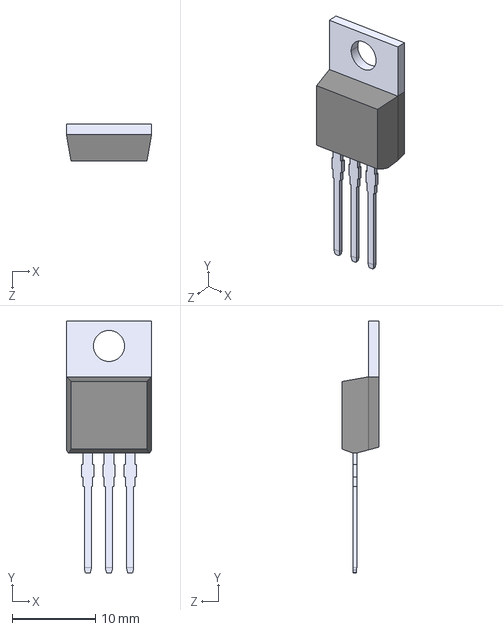
[picture p142: CAD file, 2026-07-29]
KiCad/Aktive_Bal_Bericht - V8 - Doppelmosfet/3d models/IRF9640.STEP
10.2 x 30.3 x 4.44 mm
