QuarkBaellchen5/active-balancing/KiCad/Aktive_Bal_Bericht - V8 - Doppelmosfet/3d models/CR2010-JW-101ELF-CMP-R100-1.0.STEP

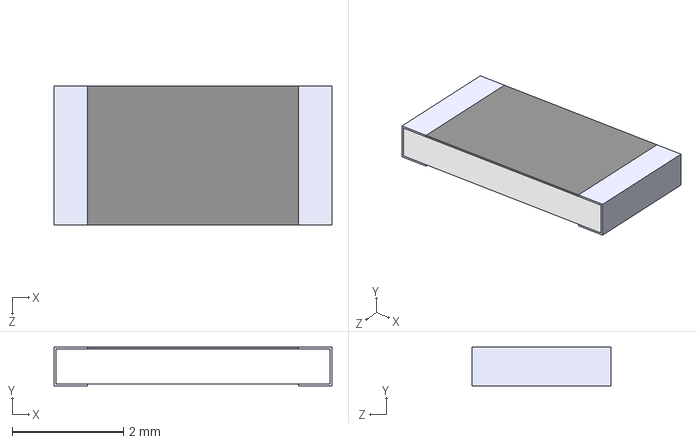
[picture p143: CAD file, 2026-07-29]
KiCad/Aktive_Bal_Bericht - V8 - Doppelmosfet/3d models/CR2010-JW-101ELF-CMP-R100-1.0.STEP
5.00 x 0.7 x 2.50 mm
