QuarkBaellchen5/active-balancing/KiCad/Aktive_Bal_Bericht - V8 - Doppelmosfet/3d models/NTTFS5C673NLTAG.step

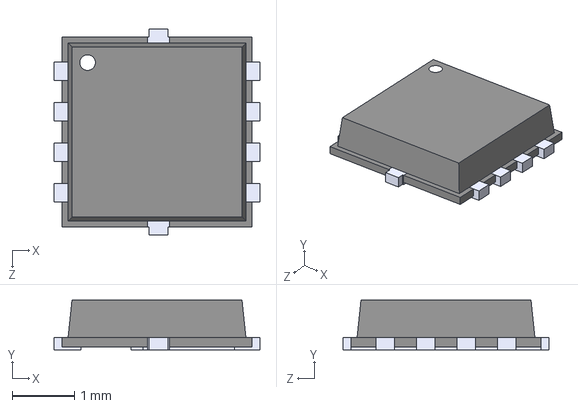
[picture p144: CAD file, 2026-06-11]
KiCad/Aktive_Bal_Bericht - V8 - Doppelmosfet/3d models/NTTFS5C673NLTAG.step
3.30 x 0.8 x 3.30 mm
