QuarkBaellchen5/active-balancing/KiCad/Aktive_Bal_Bericht - V8 - Doppelmosfet/3d models/LTV-847S_DIP_V-847S_LTO.step

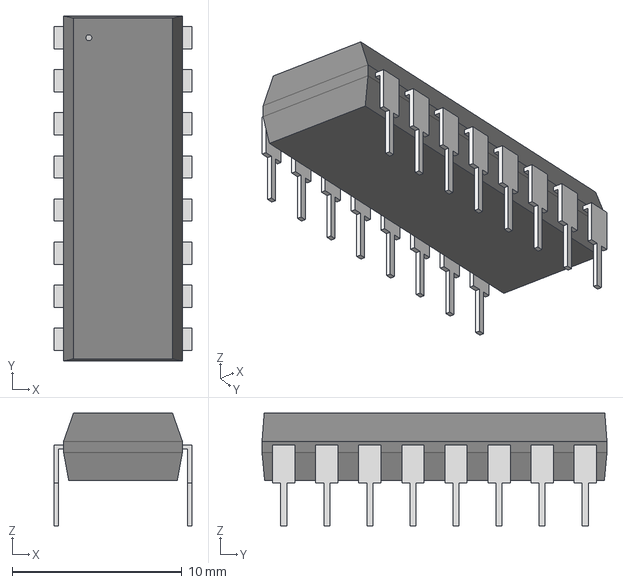
[picture p145: CAD file, 2026-05-19]
KiCad/Aktive_Bal_Bericht - V8 - Doppelmosfet/3d models/LTV-847S_DIP_V-847S_LTO.step
8.13 x 20.3 x 6.66 mm
