QuarkBaellchen5/active-balancing/KiCad/Aktive_Bal_Bericht - V8 - Doppelmosfet/3d models/common mode choke.STEP

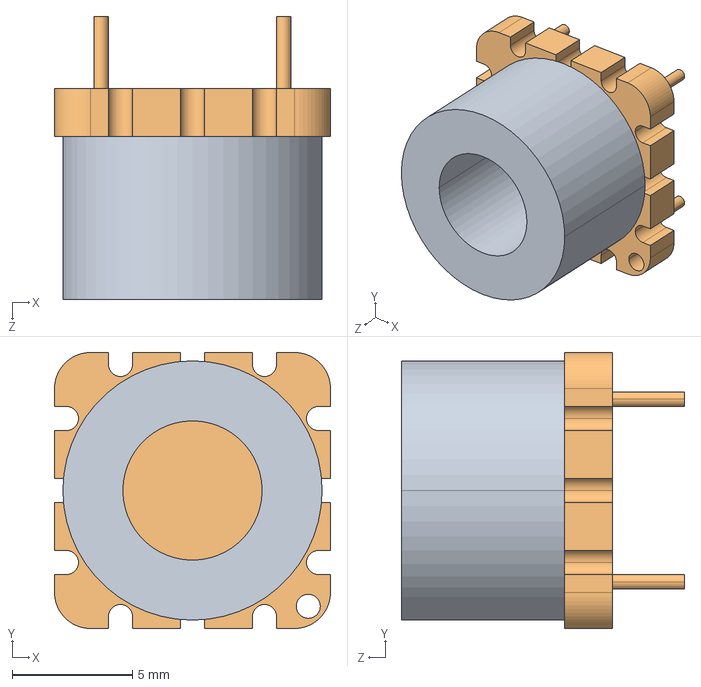
[picture p146: CAD file, 2026-05-16]
KiCad/Aktive_Bal_Bericht - V8 - Doppelmosfet/3d models/common mode choke.STEP
11.5 x 11.5 x 11.8 mm
