QuarkBaellchen5/active-balancing/KiCad/Aktive_Bal_Bericht - V8 - Doppelmosfet/3d models/ADUM1250ARZ-RL7_R_8_ADI.step

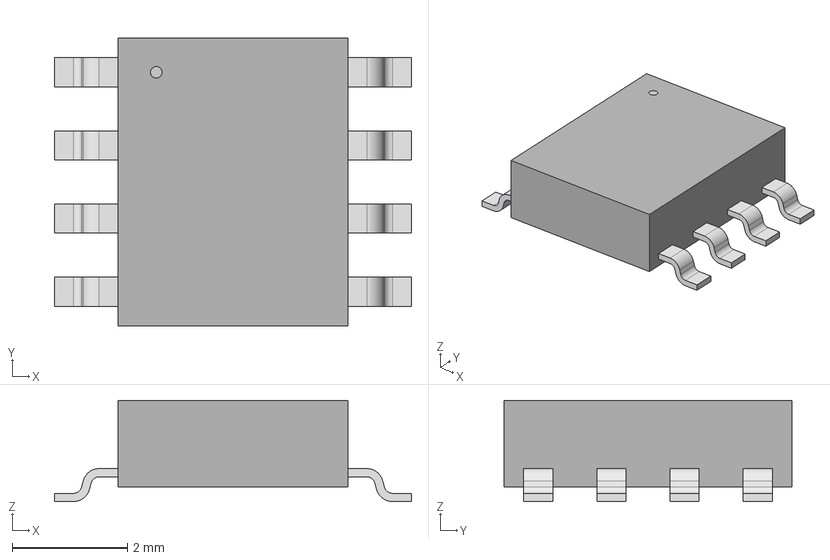
[picture p147: CAD file, 2026-04-25]
KiCad/Aktive_Bal_Bericht - V8 - Doppelmosfet/3d models/ADUM1250ARZ-RL7_R_8_ADI.step
6.20 x 5.00 x 1.75 mm
