QuarkBaellchen5/active-balancing/KiCad/Aktive_Bal_Bericht - V8 - Doppelmosfet/3d models/LM1117IMPX-3.3NOPB_DCY0004A.stp

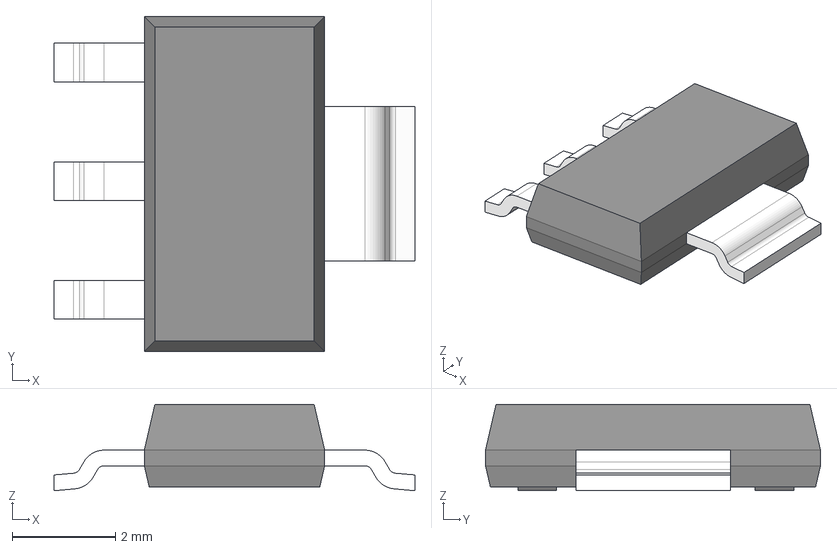
[picture p148: CAD file, 2026-04-25]
KiCad/Aktive_Bal_Bericht - V8 - Doppelmosfet/3d models/LM1117IMPX-3.3NOPB_DCY0004A.stp
7.00 x 6.50 x 1.68 mm
BODY-SOT
LEAD-SOT x 3
LEAD-SOT-WIDE
PIN1-ID
