QuarkBaellchen5/active-balancing/Dokumentation/Anleitung/Layout_beschfriftet.pptx

STM32-Bluepill

Lowside Schalter

Highside-
Schalter

Sub-D 9 Polig

Optokoppler

5V

±5V

Ausgänge

I2C Pegelwandler

DAC

I2C Entkopplung

Portexpander

DC/DC-Wandler

CAN-Transceiver

Strommessung
1V ≙ 1A

OPV
4-Fach

Ein-/Aus Schalter

3.3V

+

36-75V

12V

Shunt

12V
