QuarkBaellchen5/active-balancing/Dokumentation/Anleitung/Übersicht.pptx

5

3

Balance-Strommessung
1V ≙ 1A

1 (Bat-)

3A Sicherung

+

Spannungsversorgung
Platine (36-75V)

6 (Bat+)

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
PCAN-Adapter
Sub-D 9 Polig

LED-Testplatine

Spannungsversorgung
Mikrocontroller
(Micro-USB)
