QuarkBaellchen5/active-balancing/Dokumentation/Anleitung/Übersicht_Platine.png

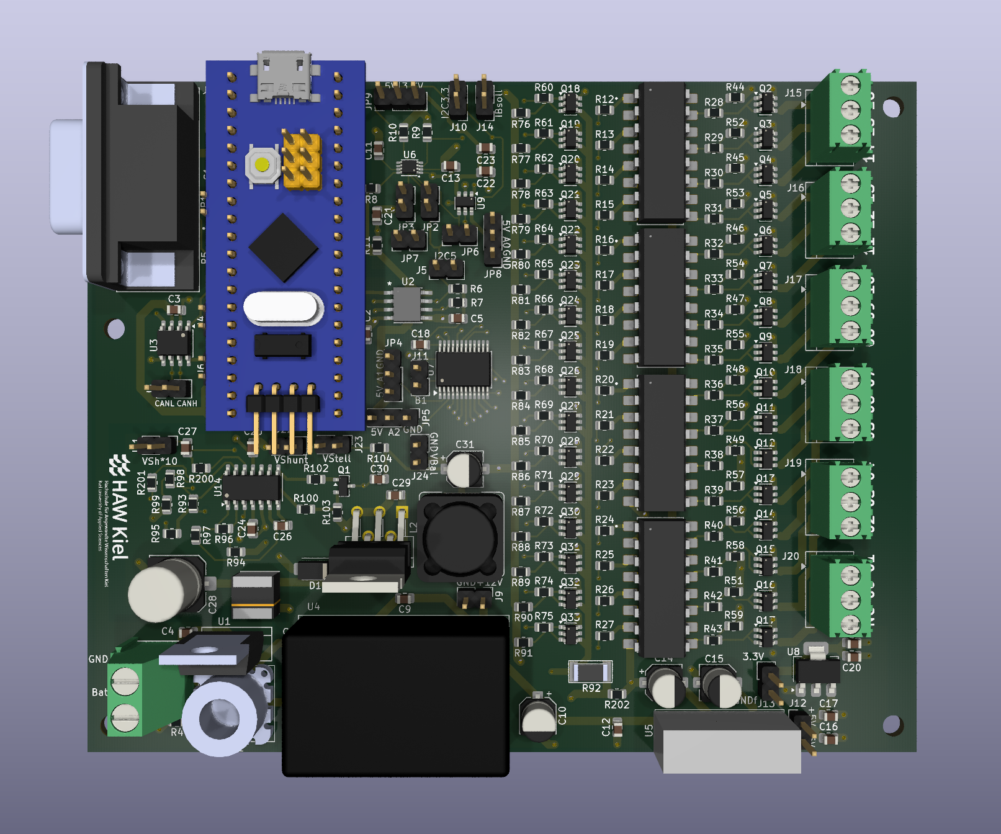
Dokumentation/Anleitung/Übersicht_Platine.png
