QuarkBaellchen5/active-balancing/Schaltpläne/Schaltung_V3.pdf

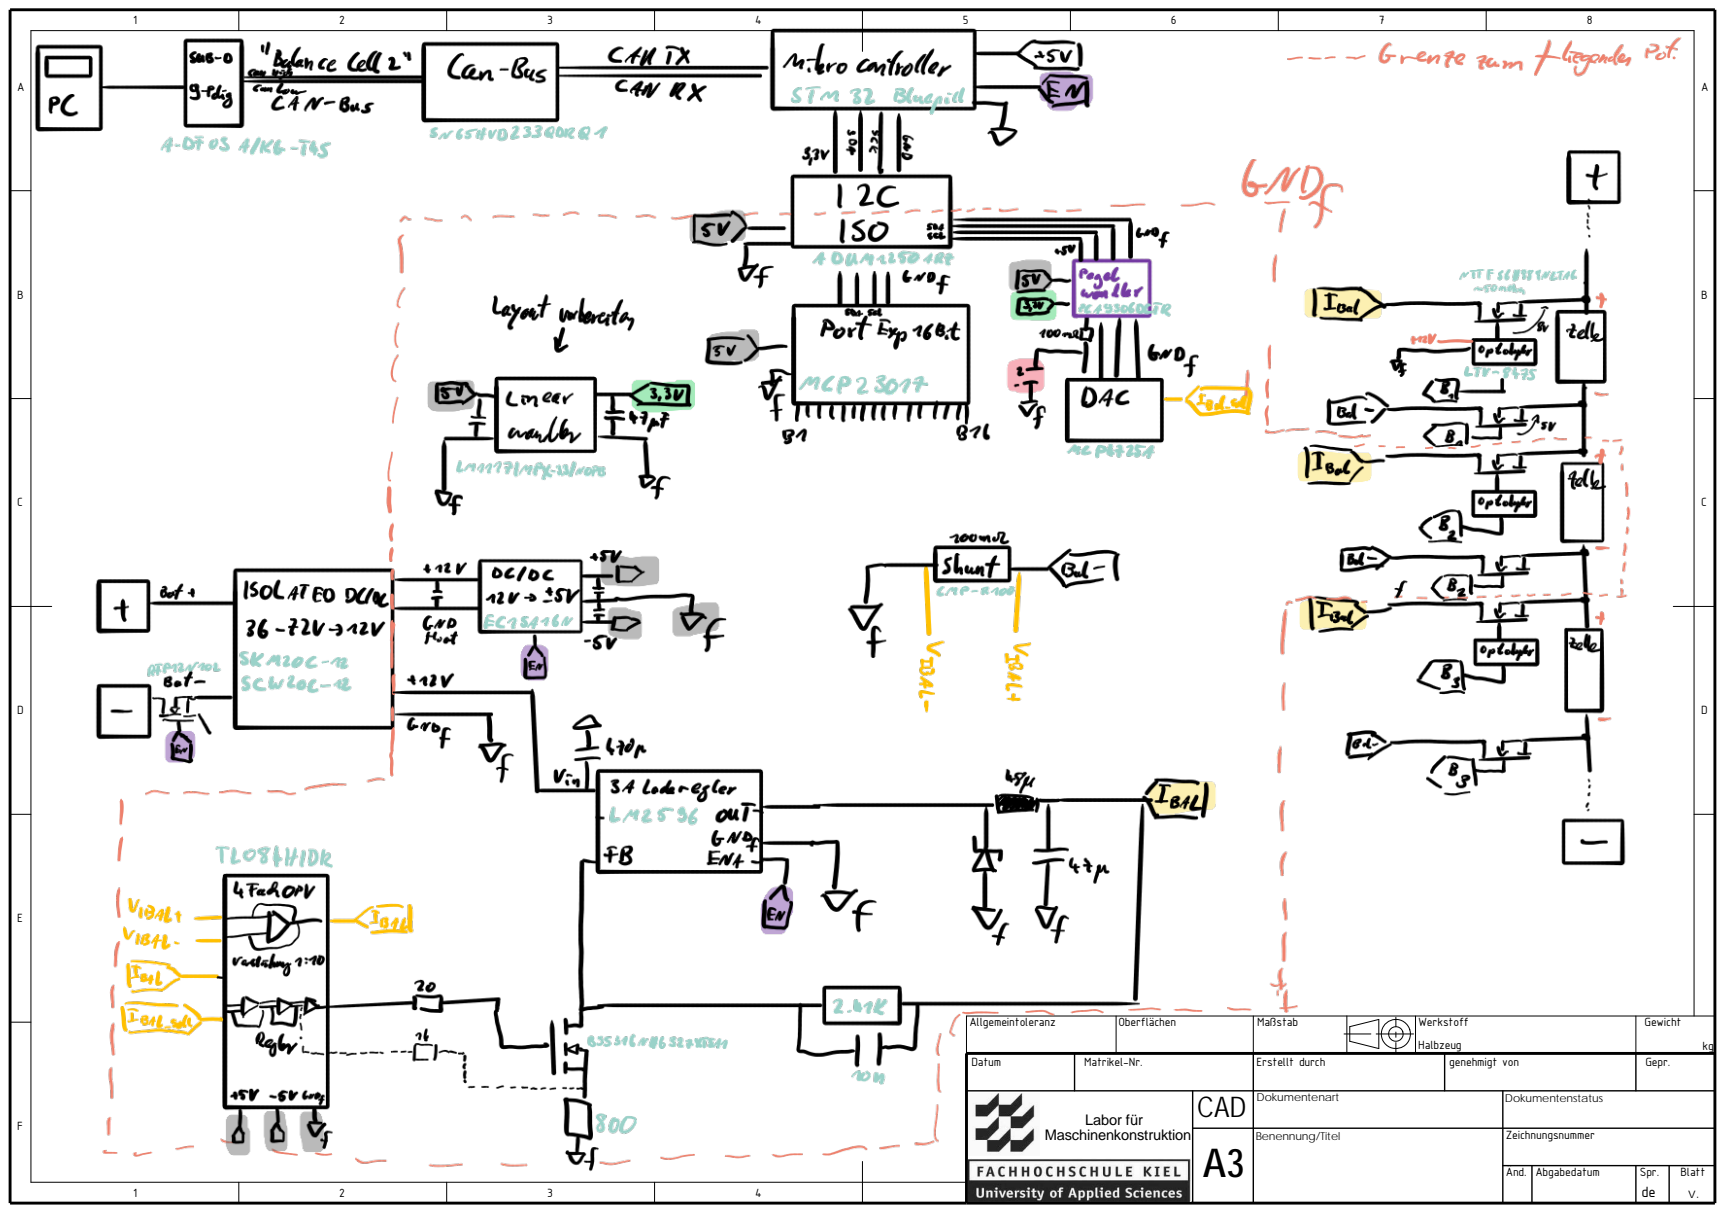
[picture p161: page 1]

Allgemeintoleranz | | Maßstab Oberflächen | | | Werkstoff Halbzeug | Gewicht kg

Datum | Matrikel-Nr. | Erstellt durch | genehmigt von | Gepr.

Labor für Maschinenkonstruktion | | Dokumentenart | Dokumentenstatus CAD

A3 | Benennung/Titel | Zeichnungsnummer

Änd. | Abgabedatum | Spr. de | Blatt v.
