QuarkBaellchen5/active-balancing/BM107/Datenblätter/STM32_blue_pill_Schematic.pdf

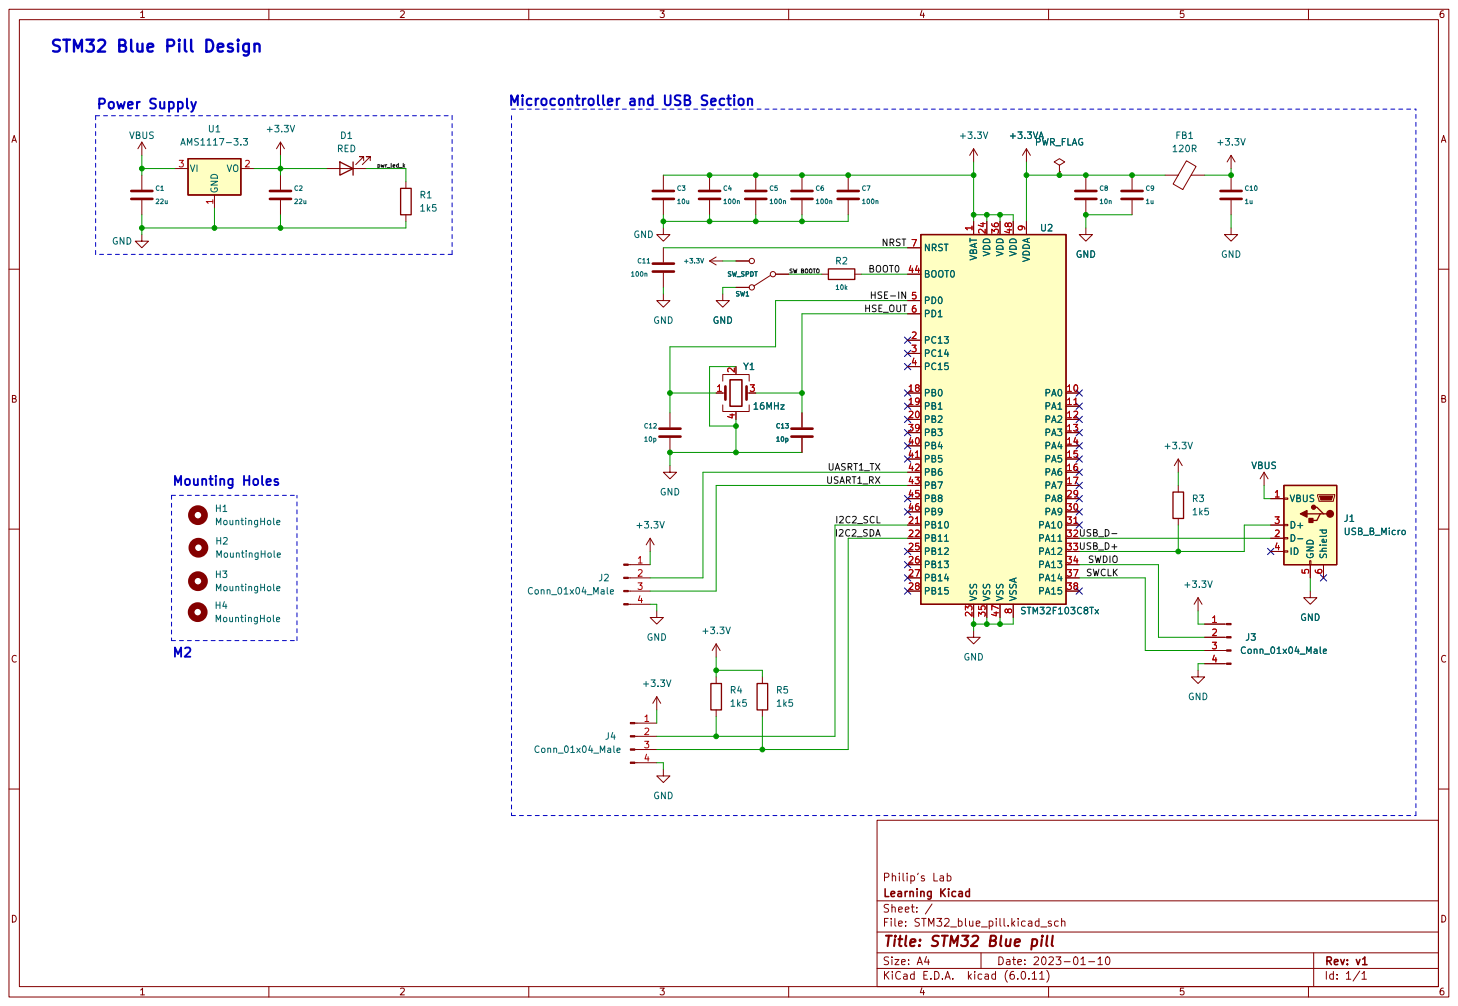
[picture p162: page 1]
