QuarkBaellchen5/active-balancing/Dokumentation/Schaltplan und Layout/Schaltplan_1.pdf

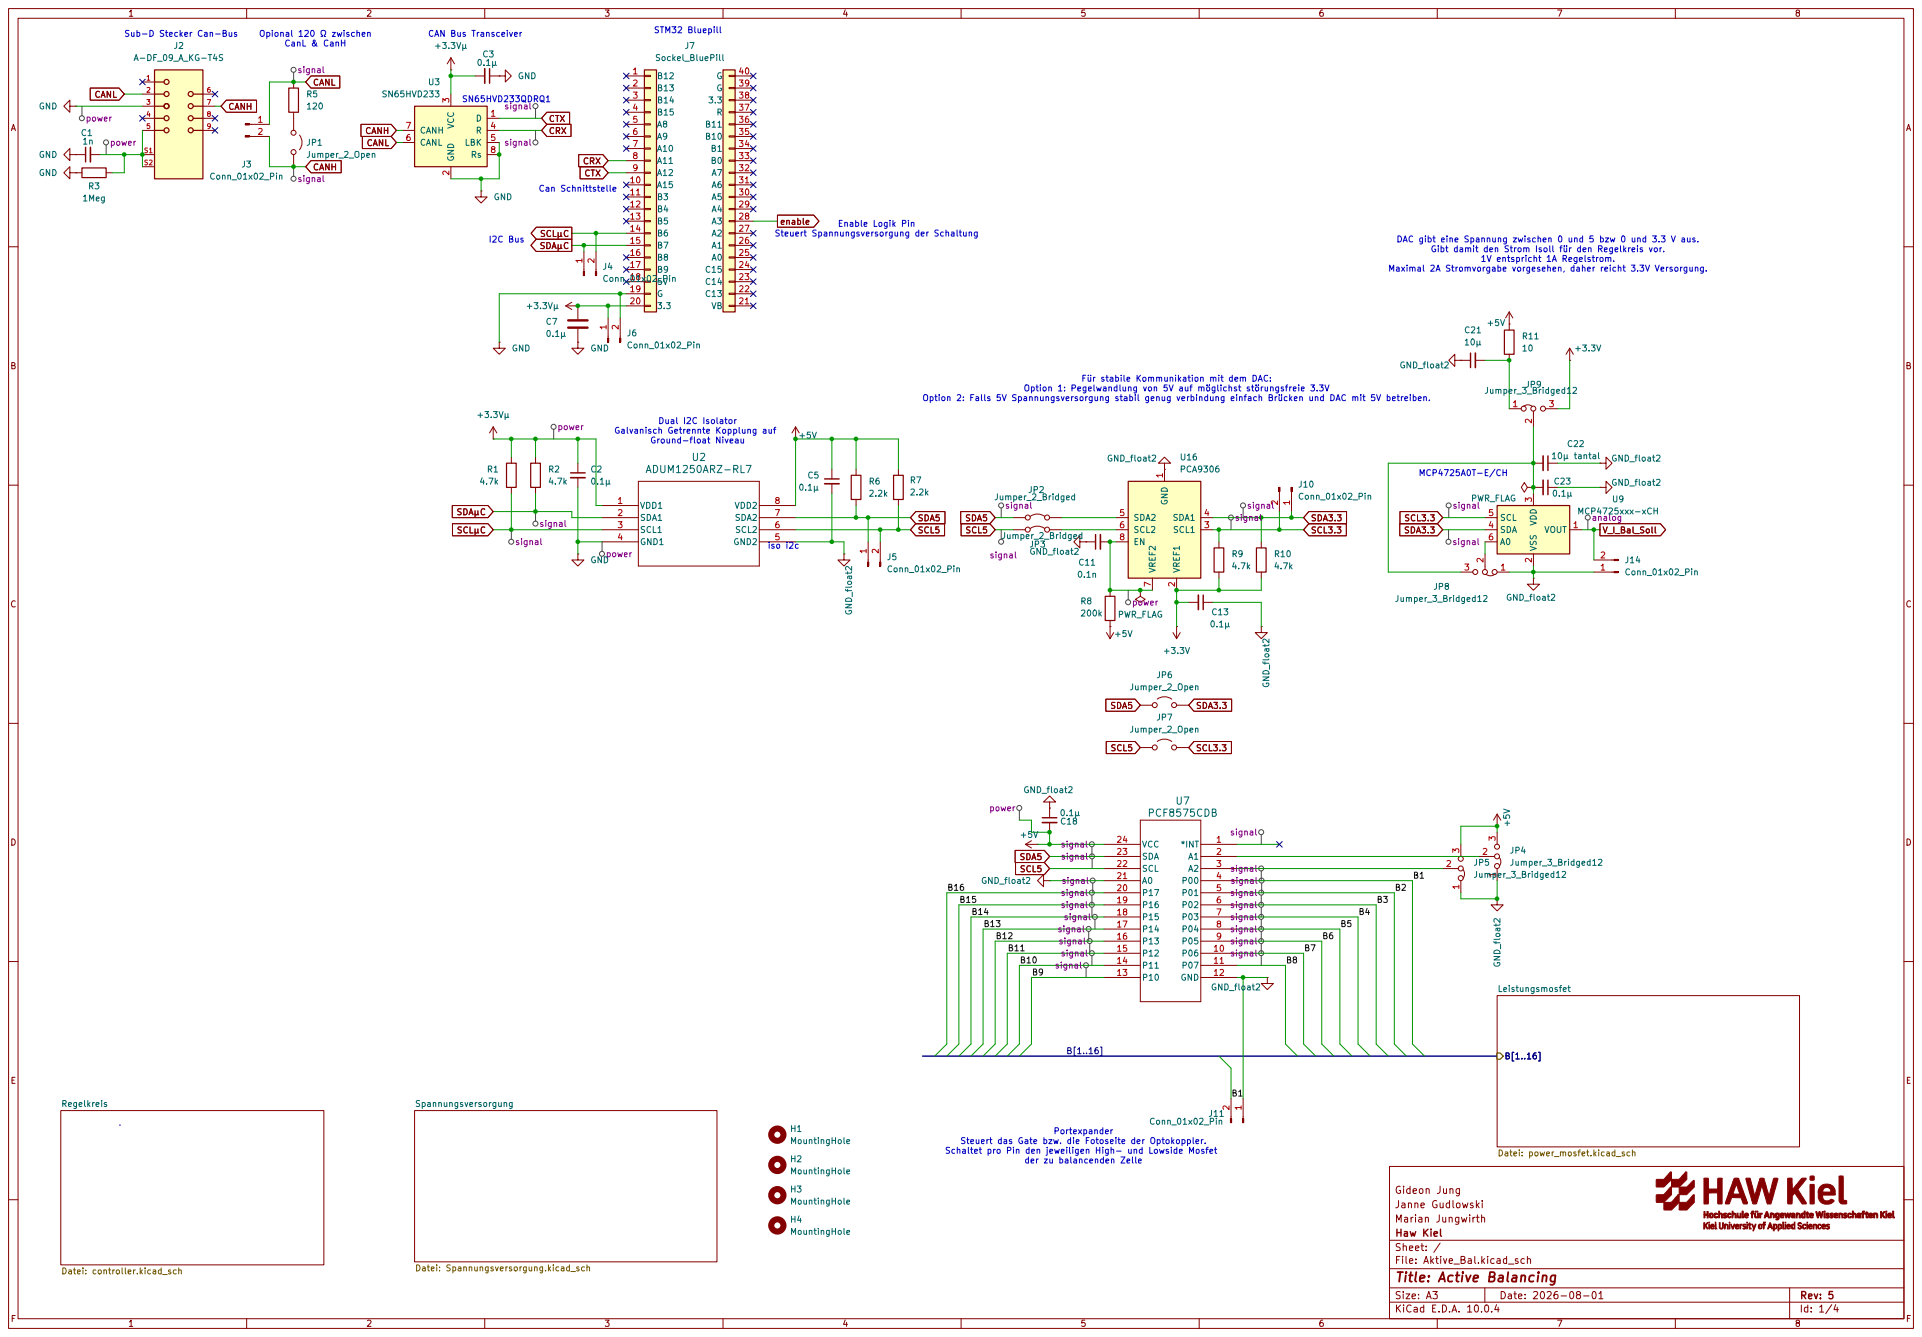
[picture p163: page 1]

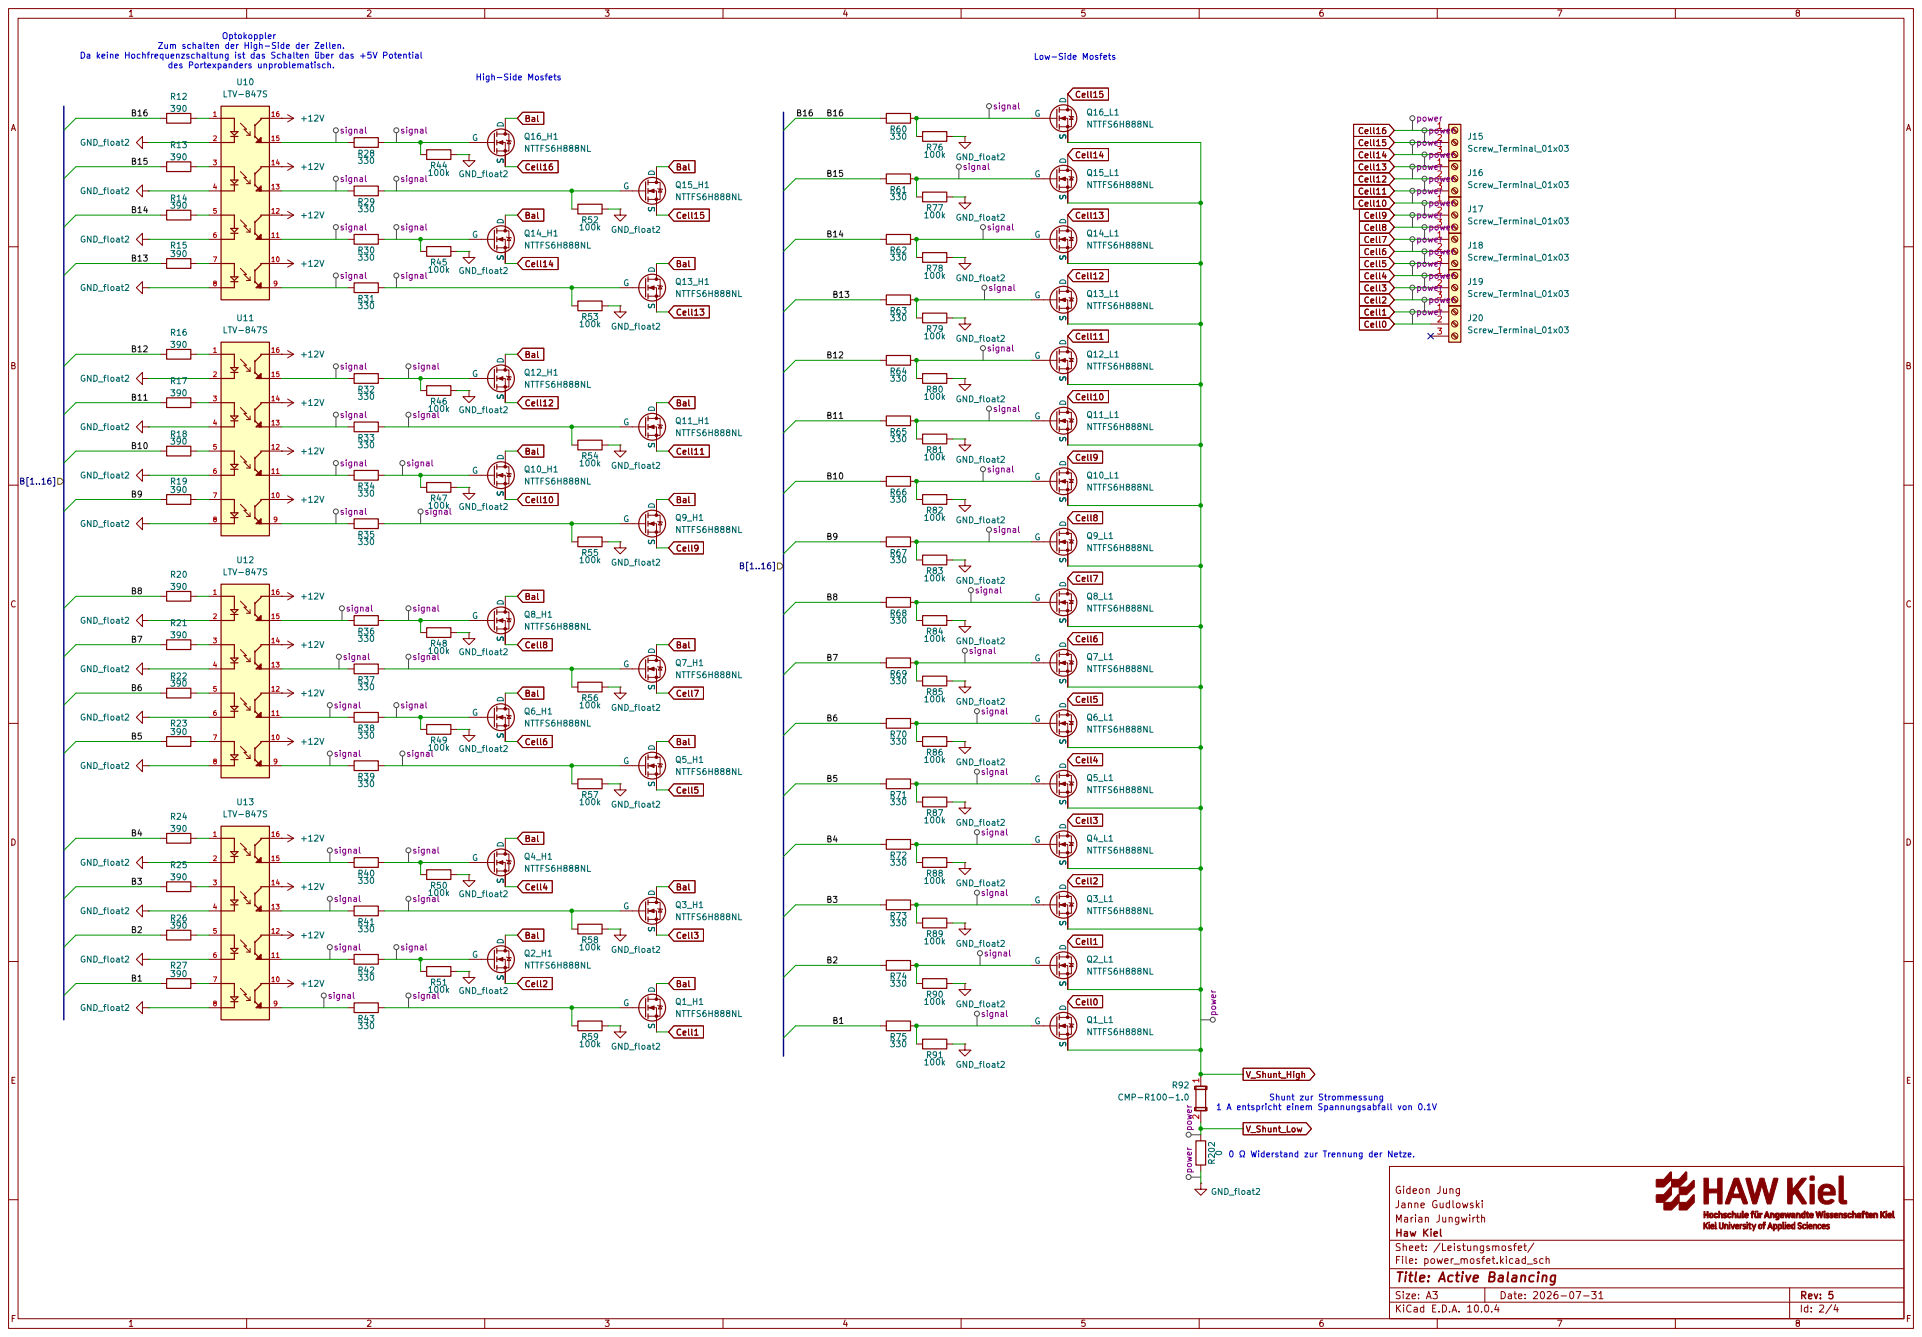
[picture p164: page 2]

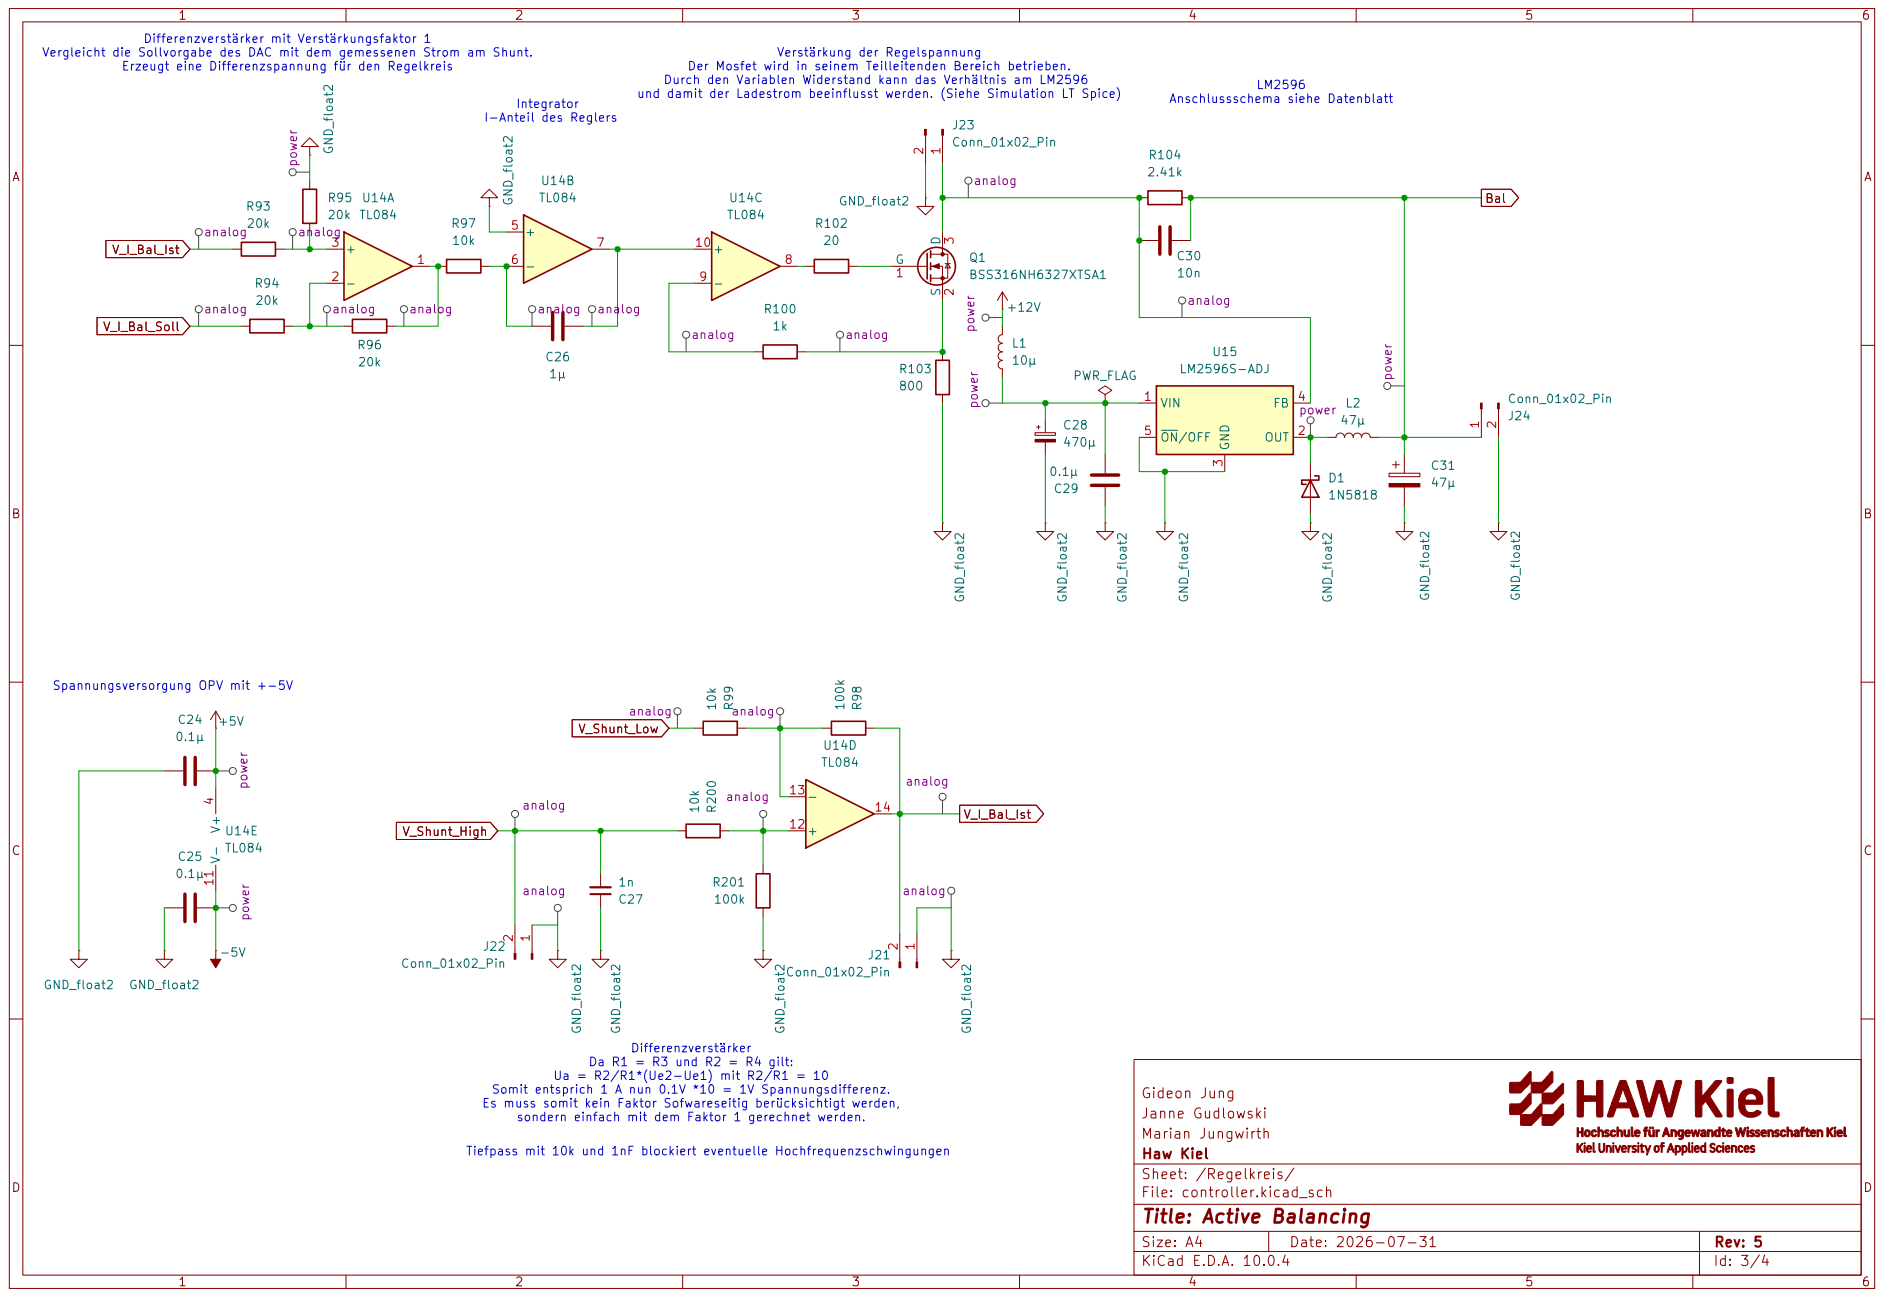
[picture p165: page 3]

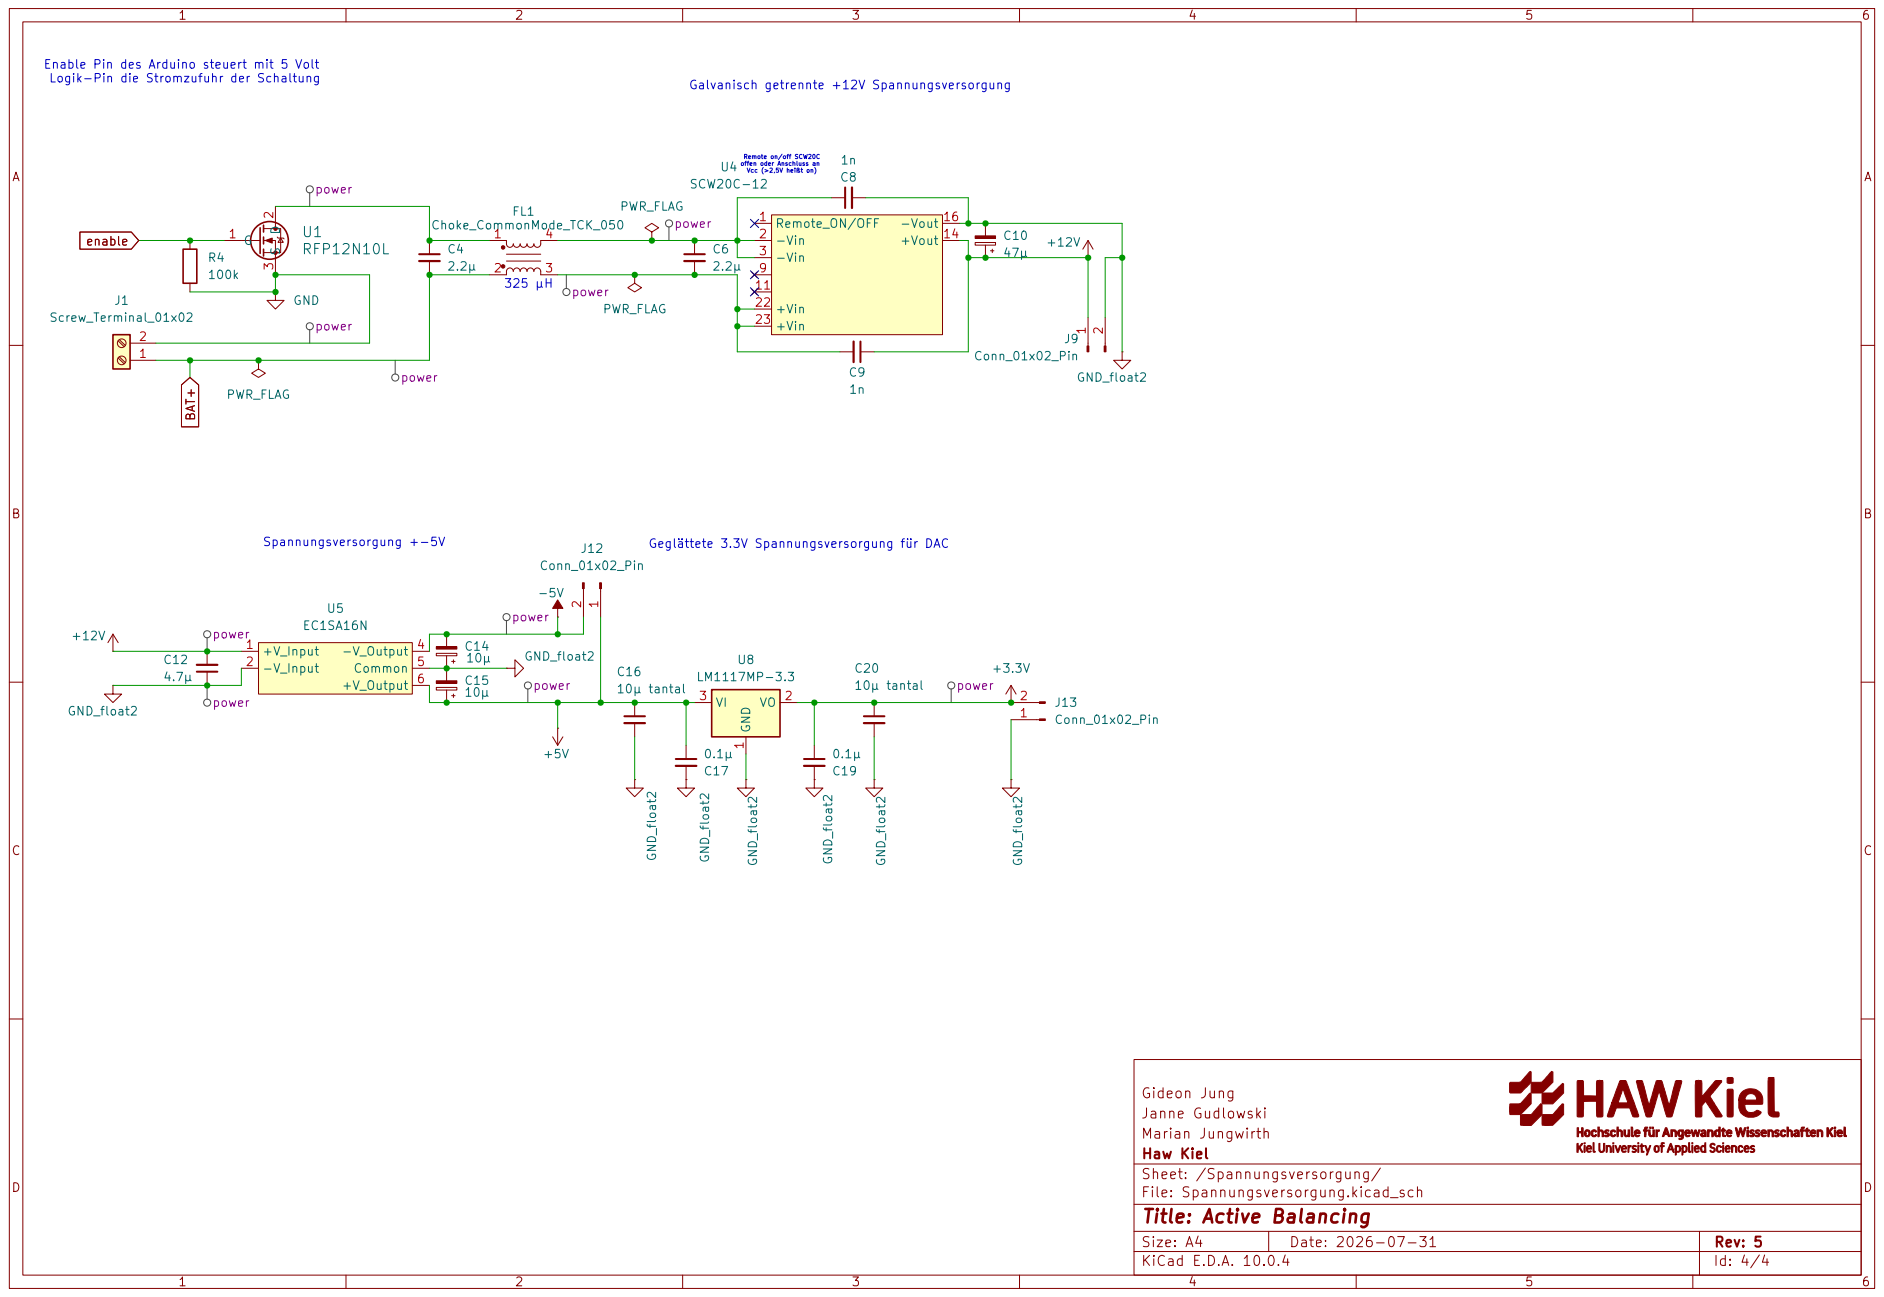
[picture p166: page 4]
