QuarkBaellchen5/active-balancing/BM107/Versuch_7_Layouterestellung/Datenblatt_Kühlkörper.pdf

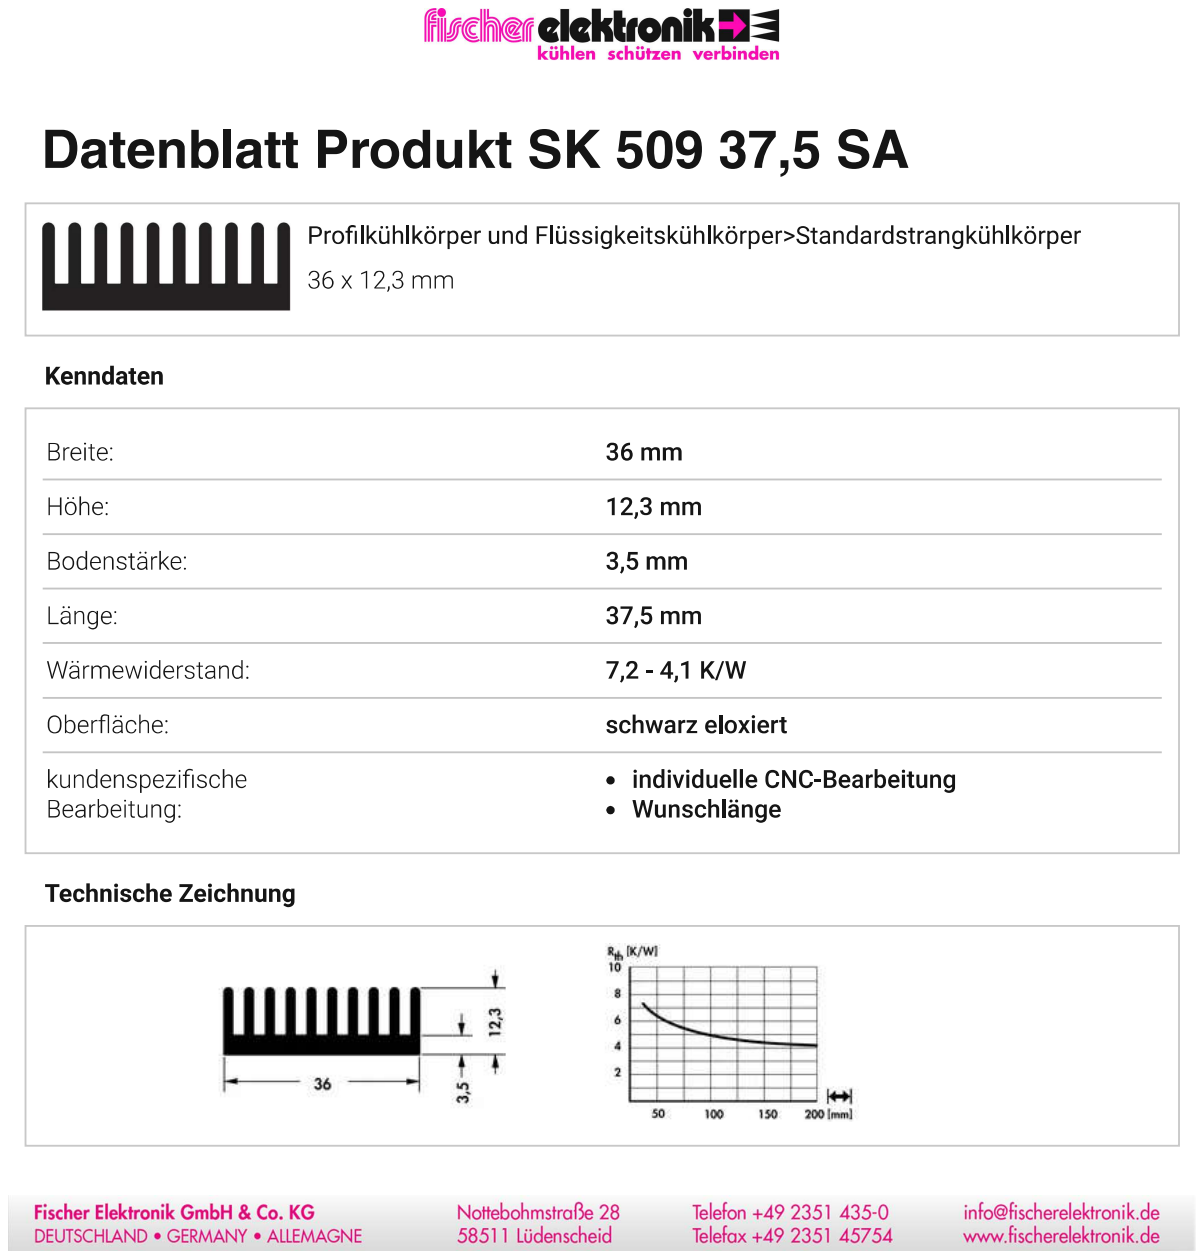
[picture p167: page 1]
