QuarkBaellchen5/active-balancing/Aktive_Balancing/LT-Spice-Simulation_DC_DC_Converter/neuer mosfet test.asc

R1: res; 5m
R2: res; 10m
R3: res; 10k
S1: sw
U1: 4N25
V1: voltage; 3.925
V2: voltage; 12
V3: voltage; 4.2
V4: voltage; PULSE(0 3.3 2 10n 10n 1 3 10)
Named nets: 0
.tran 30 uic
.model SW SW(Ron=0.1 Roff 100Meg Vt=0.5)
