QuarkBaellchen5/active-balancing/Aktive_Balancing/High_Side_Test/High_Side_Test.asc

C1: EuropeanCap; 0.1
M2: nmos; IRFH5104
R2: EuropeanResistor; 4
R3: EuropeanResistor; 400
U2: VOM1271
V2: voltage; 9
V3: voltage; PULSE(0 5 0.5 1m 1m 0.75 1.5)
Named nets: 0, 9V, DigitalPin
.tran 3
