QuarkBaellchen5/active-balancing/Aktive_Balancing/LT-Spice-Simulation_DC_DC_Converter/OP LMx24b test.asc

R1: res; 1k
R2: res; 10k
R3: res; 190k
U1: LMX24B
V1: voltage; 5
V2: voltage; 5
V3: voltage; SINE(0 40m 10 0 0 0 10)
Named nets: 0, VEE, VCC
.tran 2
