QuarkBaellchen5/active-balancing/Doppelmosfets/Einzelmosfets/Simulation_Einzelmosfets.asc

M1: nmos; BSC047N08NS3
M2: nmos; BSC047N08NS3
M3: nmos; BSC047N08NS3
M4: nmos; BSC047N08NS3
M5: nmos; BSC047N08NS3
M6: nmos; BSC047N08NS3
M7: nmos; BSC047N08NS3
M8: nmos; BSC047N08NS3
M9: nmos; BSC047N08NS3
M10: nmos; BSC047N08NS3
M11: nmos; BSC047N08NS3
M12: nmos; BSC047N08NS3
M13: nmos; BSC047N08NS3
M14: nmos; BSC047N08NS3
M15: nmos; BSC047N08NS3
M16: nmos; BSC047N08NS3
R1: res; 10
R2: res; 1k
R3: res; 10
R4: res; 1k
V1: voltage; 3.6V; Rser=0.01
V2: voltage; 3.6; Rser=0.01
V3: voltage; 3.6; Rser=0.01
V4: voltage; 3.6; Rser=0.01
V5: voltage; PULSE(0 3.7 0.6 1u 1u 4 6); Rser=0.1
V6: voltage; PULSE(0 8 1 100u 100u 3.2 6)
V7: voltage; PULSE(0 5 1 100u 100u 3.2 6)
Named nets: 0, V_I_Bal, gnd_float, G1_H, G1_L
.tran 9
