QuarkBaellchen5/active-balancing/Aktive_Balancing/LTSpice Differenzverstärker/Differenzverstärker.asc

R1: EuropeanResistor; 100k
R2: EuropeanResistor; 10k
R3: EuropeanResistor; 10k
R4: EuropeanResistor; 100k
R7: EuropeanResistor; 0.1
U2: UniversalOpAmp
V1: voltage; 0.2
V3: voltage; 5
V4: voltage; 5
Named nets: 0, +5V, -5V, 5V, U1, U2, Out
.tran 1
Out = (U1-U2)*10
Wir müssen auf die richtige Polung der beiden Eingänge achten!
Low Eingang
High Eingang
