QuarkBaellchen5/active-balancing/Aktive_Balancing/LT Spice Opto/Pullup Optokoppler real.asc

M1: nmos; BSZ440N10NS3neu
R1: EuropeanResistor; 1
R2: res; 330
R3: res; 100k
U1: PC817A
V1: voltage; 12
V2: voltage; PULSE(0 5 1 1n 1n 1)
V3: voltage; 3.925
V4: voltage; 4.2
Named nets: 0, VCC, sw
.tran 4
.model BSZ440N10NS3neu VDMOS(RG=0.8 VTO=3.63 KP=20.3 LAMBDA=0.03 RD=0.02971 RS=0.0010600000000000002 CGDMAX=1.3000000000000002e-10 CGDMIN=2e-12 CGS=6e-10 CJO=4.900000000000001e-10 TT=6.000000000000001e-8 IS=2.2399999999999998e-11 N=1.19 RB=0.0064 RON=0.050 QG=8e-9 VDS=80 A=0.2 M=0.3 VJ=0.9)
