QuarkBaellchen5/active-balancing/Aktive_Balancing/LT Spice Opto/Pullup Optokoppler leistungs seite.asc

M1: nmos; Si4940DY
R1: res; {R_inv}
R2: res; 330
R3: res; 10Meg
S1: sw
V1: voltage; 12
V2: voltage; PULSE(0 5 1 1n 1n 1)
V3: voltage; 3.925
V4: voltage; 4.2
V5: voltage; 5
Named nets: 0, VCC, sw
.tran 4
.model SW SW(Ron=80 Roff=10Meg)
.step param R_inv list 10k 100k 1MEG
