QuarkBaellchen5/active-balancing/Dokumentation/Thermische Analyse/Simulation_Datasheet/Thermische_Simulation.asc

Cth_HA1: cap; 1.28271
I1: current; 2.43
I2: current; 2.43
RTH_CA1: res; 50
RTH_CH1: res; 3
RTH_HA1: res; 22
RTH_JC1: res; 2
TA1: voltage; 30
TA2: voltage; 30
Named nets: 0, LM2596_Heatsink, TC2, TH2, LM2596_Blank
LM2596 Stromregler
Betriebstemperatur -40 °C bis 120 °C
Ohne Kühlkörper: R Junction-to-ambient Rth = 50°C/W
Junction-to-case (top): Rth Junction-to-case = 2°C/W
Case-to-Heatsink: Rth = 1.2 °C/W -> Wahrscheinlich schlechter -> 3 °C/W
Heatsink to ambient: Rth = 22 °C/W
 
Efficiency VIN = 12 V, VOUT = 3 V, ILOAD = 3 A 73% -> 2.43 W Verlustleistung
-> ca- 27% Verlustleistung.
.tran 1000 startup
