QuarkBaellchen5/active-balancing/Aktive_Balancing/Photo_Voltaic_Isolators_prj/LTspice/ACPL-K30T_DC.asc

I1: current; 10µ; AC 1 0
R1: res; 10Meg
U1: ACPL-K30T
Named nets: 0, Out
.dc i1 0 20m .1m
