QuarkBaellchen5/active-balancing/Aktive_Balancing/Photo_Voltaic_Isolators_prj/LTspice/ACPL-K30T_TRAN.asc

I1: current; PULSE(0 10m 1m 100n 100n 1m 4m); AC 1 0
R1: res; 10Meg
U1: ACPL-K30T
Named nets: 0, Out
.tran 5m uic
