QuarkBaellchen5/active-balancing/Aktive_Balancing/Photo_Voltaic_Isolators_prj/LTspice/VOM1271_DC.asc

I1: current; PWL(0 0 1 1)
R1: res; {R}
U1: VOM1271
Named nets: a, 0, o
.tran 50m
.inc VOM1271.cir
.step param R list 1e6 5e5
.temp 25
Fig. 2 - Output Open Circuit Voltage vs. LED Current
