QuarkBaellchen5/active-balancing/Aktive_Balancing/Photo_Voltaic_Isolators_prj/LTspice/VOM1271_TRAN.asc

C1: cap; 200p
I1: current; PULSE(0 20mA 1m 100n 100n 1m 2m)
R1: res; 10Meg
X2: vom1271
Named nets: 0, in, Out
.tran 3m
.inc VOM1271.cir
