QuarkBaellchen5/active-balancing/Aktive_Balancing/LT-Spice-Simulation_DC_DC_Converter/spice-models/Remodel_SG3525A.asc

A1: dflop; Vhigh=5.1 Trise=20n Rout=30
A2: or; Vhigh=5.1 Trise=400n Rout=30
A3: or; Vhigh=5.1 Trise=400n Rout=30
A4: schmitt; Vhigh=5.1 Vlow=0.45 Trise=20n Vt=7.25 Vh=0.25
A5: schmitt; Vhigh=5.1 Trise=400n Vt=634m Vh=1m
A6: srflop; Vhigh=5.1 Trise=20n Rout=30
A7: or; Vhigh=5.1 Trise=20n Rout=30
A8: diffschmitt; Vhigh=5.1 Trise=20n Vt=0 Vh=10m
A9: srflop; Vhigh=5.1 Ref=0.9 Trise=150n Tfall=250n
A10: or; Vhigh=5.1 Trise=20n
A11: buf; Vhigh=5.1 Ref=3.2 Trise=20n
A12: buf; Vhigh=5.1 Ref=0.9 Trise=20n
A13: buf; Vhigh=5.1 Ref=2 Trise=20n
C1: cap; 100p
C2: cap; 40p
D1: diode; IDEAL
D2: diode; D1_75
D3: diode; IDEAL
D4: diode; IDEAL
D5: diode; IDEAL
D6: diode; D1_75
D7: diode; IDEAL
D8: diode; IDEAL
D9: diode; IDEAL
D10: diode; IDEAL
D11: zener; Z5_1
D12: zener; Z40
D13: diode; Z5_6
D14: diode; D1_2
D15: zener; Z5_1
D16: diode; IDEAL
D17: diode; IDEAL
D18: diode; D1_6
D19: zener; Z5_1
E1: e; 1
E2: e; 1
F1: f; V2; -1
G1: g; table=(-70m -100u,0 0,70m 100u)
I1: current; 21m
I2: current; 188m
I3: current; 21m
I4: current; 188m
I7: current; 80m
I8: current; TBL(0 0 3 3.8m 7 19m 8 20m 40 24.1m)
I9: current; 50µ
Q1: npn
R1: res; 8.93
R2: res; 22.6
R3: res; 2.28
R4: res; 8.93
R5: res; 22.6
R6: res; 2.28
R7: res; 4Meg
R8: res; 30
R9: res; 1Meg
R10: res; 1Meg
R11: res; 170
R12: res; 5k
R13: res; 5k
R14: res; 60k
R15: res; 500
R16: res; 1k
R17: res; 2k
R18: res; 250
R19: res; 3k
S1: sw; HOUT
S2: sw; LOUT
S3: sw; HOUT
S4: sw; LOUT
S5: sw; LSW
V1: voltage; 0.2
V2: voltage; 3.64
Named nets: SHD, SS, N002, 0, N001, N036, VIN, N035, N034, N033, CT, N025, RT, N006, N019, N026, N010, N009, N018, SYN, N007, N008, OSC, N016, DCH, N024, NI, INV, N027, CMP, N030, VRF, N020, N011, N005, N017, N022, N023, OUA, VC, N004, N012, N013, N015, N014, OUB, N021, N028, N029, N032, N031
.op
.model NPN NPN
.model PNP PNP
.model HOUT SW(Ron=2.7 Roff=175k Vt=2.8 Vh=-2.1 Vser=1.1 Ilimit=0.6)
.model LOUT SW(Ron=10m Roff=175k Vt=2.8 Vh=-2.1 Vser=0 Ilimit=0.6)
.model IDEAL D(Ron=0 Roff=1G Vfwd=0)
.model D1_75 D(Ron=1.57 Roff=1G Vfwd=1.75)
.model D1_6 D(Ron=0 Roff=1G Vfwd=1.6)
.model Z5_1 D(Ron=1 Roff=1G Vrev=5.075)
.model Z40 D(Ron=0 Roff=175k Vrev=40)
.model Z5_6 D(Ron=1 Roff=1G Vrev=5.6)
.model D1_2 D(Ron=0 Roff=1G Vfwd=1.2)
.model LSW SW(Vt=2.55 Vh=-0.5 Ron=50 Roff=1meg Vser=0.3 Ilimit=50ma)
