QuarkBaellchen5/active-balancing/KiCad/Aktive_Bal_Bericht - V8 - Doppelmosfet/Aktive_Bal.kicad_pcb

## KiCad design KiCad/Aktive_Bal_Bericht - V8 - Doppelmosfet/Aktive_Bal.kicad_pcb (2026-09-17)

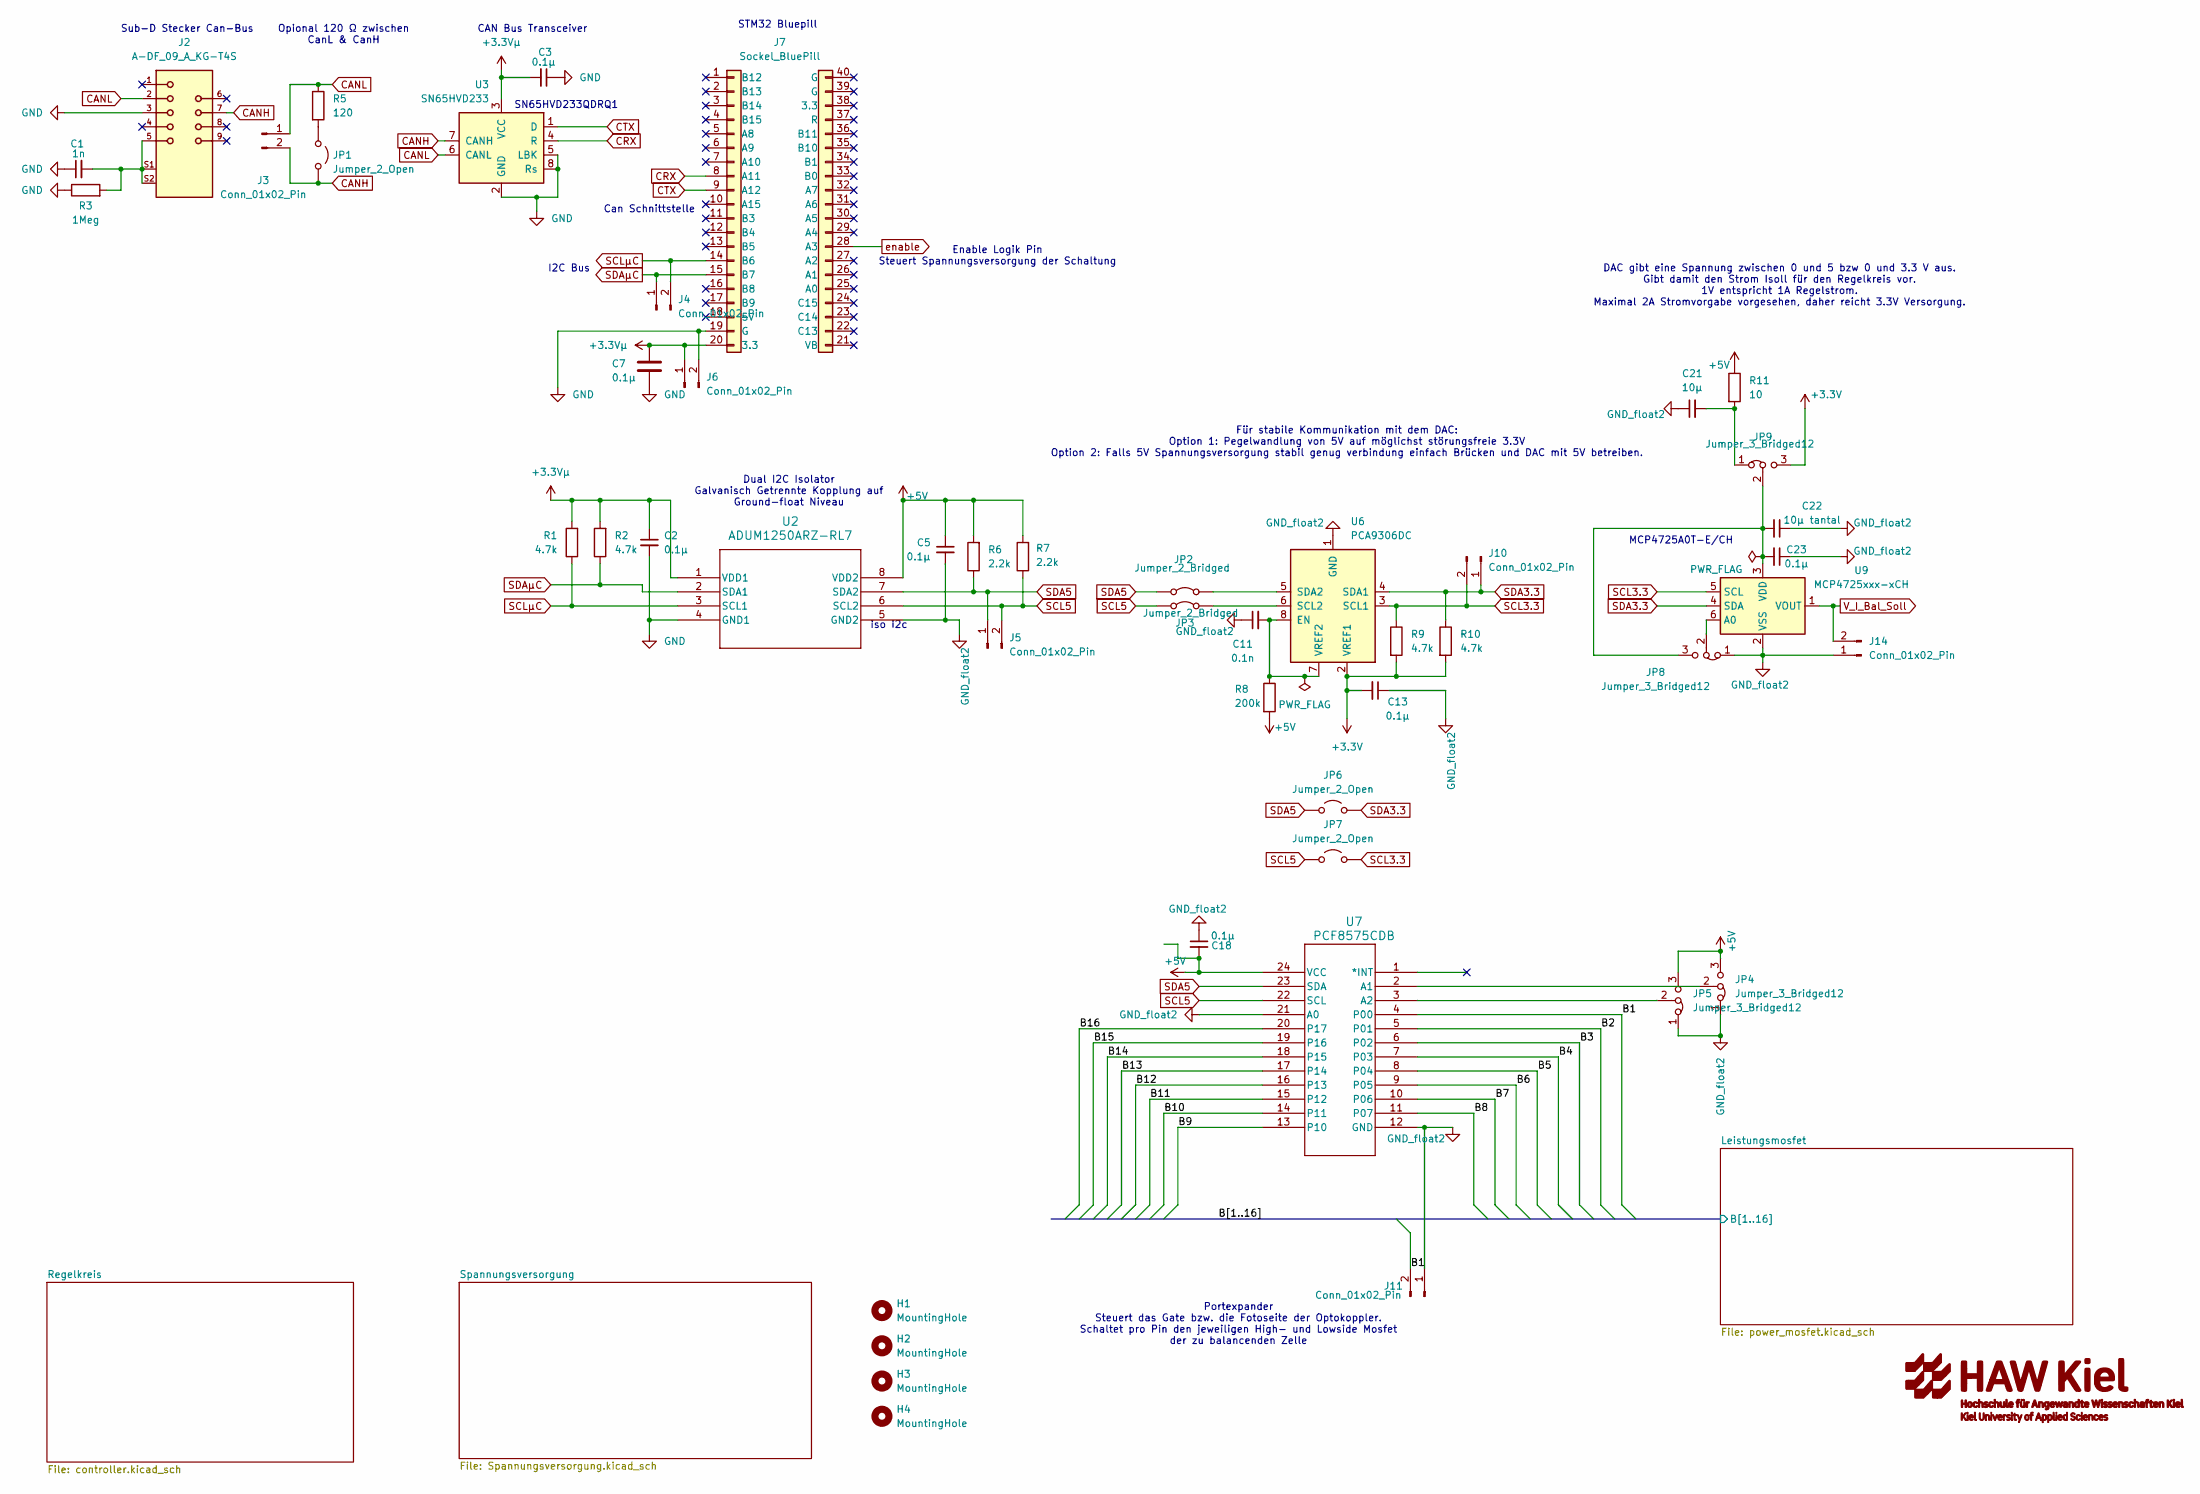
[picture p168: schematic Aktive_Bal.kicad_sch, Active Balancing]

Parts:
C1: 1n; C_0805_2012Metric
C2, C3, C5, C7, C13, C18, C23: 0.1µ; C_0805_2012Metric
C11: 0.1n; C_0805_2012Metric
C21: 10µ; C_0805_2012Metric
C22: 10µ tantal; C_0805_2012Metric
H1, H2, H3, H4: MountingHole; MountingHole_3.2mm_M3
J2: A-DF_09_A_KG-T4S; ASSMANN_A-DF_09_A_KG-T4S; PARTREV 05
J3, J4, J5, J6, J10, J11, J14: Conn_01x02_Pin; PinHeader_1x02_P2.54mm_Vertical
J7: Sockel_BluePill; SockelBluepill Dupont leisten
JP1, JP6, JP7: Jumper_2_Open; PinHeader_1x02_P2.54mm_Vertical
JP2, JP3: Jumper_2_Bridged; PinHeader_1x02_P2.54mm_Vertical
JP4, JP5, JP8, JP9: Jumper_3_Bridged12; PinHeader_1x03_P2.54mm_Vertical
R1, R2, R9, R10: 4.7k; R_0805_2012Metric
R3: 1Meg; R_0805_2012Metric
R5: 120; R_0805_2012Metric
R6, R7: 2.2k; R_0805_2012Metric
R8: 200k; R_0805_2012Metric
R11: 10; R_0805_2012Metric
U2: ADUM1250ARZ-RL7; ADUM1250ARZ-RL7_R_8_ADI-M
U3: SN65HVD233; SOIC-8_3.9x4.9mm_P1.27mm
U6: PCA9306DC; VSSOP-8_2.3x2mm_P0.5mm
U7: PCF8575CDB; PCF8575CDB_SSOP-24_5.3x8.2mm_P0.65mm
U9: MCP4725xxx-xCH; SOT-23-6

Connections:
+3.3V: C13.2, JP9.3 (B), R9.2, R10.2, U6.2 (VREF1); also elsewhere on the board
+3.3Vµ: C2.1, C3.2, C7.1, J6.1, J7.20 (3.3), R1.2, R2.2, U2.1 (VDD1), U3.3 (VCC)
+5V: C5.1, C18.2, JP4.3 (B), JP5.3 (B), R6.2, R7.2, R8.2, R11.1, U2.8 (VDD2), U7.24 (VCC); also elsewhere on the board
/B1: J11.2, U7.4 (P00); also elsewhere on the board
/B2: U7.5 (P01); also elsewhere on the board
/B3: U7.6 (P02); also elsewhere on the board
/B4: U7.7 (P03); also elsewhere on the board
/B5: U7.8 (P04); also elsewhere on the board
/B6: U7.9 (P05); also elsewhere on the board
/B7: U7.10 (P06); also elsewhere on the board
/B8: U7.11 (P07); also elsewhere on the board
/B9: U7.13 (P10); also elsewhere on the board
/B10: U7.14 (P11); also elsewhere on the board
/B11: U7.15 (P12); also elsewhere on the board
/B12: U7.16 (P13); also elsewhere on the board
/B13: U7.17 (P14); also elsewhere on the board
/B14: U7.18 (P15); also elsewhere on the board
/B15: U7.19 (P16); also elsewhere on the board
/B16: U7.20 (P17); also elsewhere on the board
CANH: J2.7, J3.2, JP1.2 (B), U3.7 (CANH)
CANL: J2.2 (TXD), J3.1, R5.1, U3.6 (CANL)
CRX: J7.8 (A11), U3.4 (R)
CTX: J7.9 (A12), U3.1 (D)
GND: C1.1, C2.2, C3.1, C7.2, J2.3 (RXD), J6.2, J7.19 (G), R3.1, U2.4 (GND1), U3.2 (GND), U3.5 (LBK), U3.8 (Rs); also elsewhere on the board
GND_float2: C5.2, C11.1, C13.1, C18.1, C21.1, C22.1, C23.1, J11.1, J14.1, JP4.1 (A), JP5.1 (A), JP8.1 (A), U2.5 (GND2), U6.1 (GND), U7.12 (GND), U7.21 (A0), U9.2 (VSS); also elsewhere on the board
unnamed: C1.2, J2.5 (GND), J2.S1 (SHIELD), J2.S2 (SHIELD__1), R3.2
unnamed: JP1.1 (A), R5.2
unnamed: JP2.2 (B), U6.5 (SDA2)
unnamed: JP3.2 (B), U6.6 (SCL2)
unnamed: JP4.2 (C), U7.2 (A1)
unnamed: JP5.2 (C), U7.3 (A2)
unnamed: C22.2, C23.2, JP8.3 (B), JP9.2 (C), U9.3 (VDD)
unnamed: JP8.2 (C), U9.6 (A0)
unnamed: C21.2, JP9.1 (A), R11.2
unnamed: C11.2, R8.1, U6.7 (VREF2), U6.8 (EN)
SCL3.3: J10.2, JP7.2 (B), R9.1, U6.3 (SCL1), U9.5 (SCL)
SCL5: J5.2, JP3.1 (A), JP7.1 (A), R7.1, U2.6 (SCL2), U7.22 (SCL)
SCLµC: J4.2, J7.14 (B6), R1.1, U2.3 (SCL1)
SDA3.3: J10.1, JP6.2 (B), R10.1, U6.4 (SDA1), U9.4 (SDA)
SDA5: J5.1, JP2.1 (A), JP6.1 (A), R6.1, U2.7 (SDA2), U7.23 (SDA)
SDAµC: J4.1, J7.15 (B7), R2.1, U2.2 (SDA1)
V_I_Bal_Soll: J14.2, U9.1 (VOUT); also elsewhere on the board
enable: J7.28 (A3); also elsewhere on the board

Notes on the sheet:
SN65HVD233QDRQ1
MCP4725A0T-E/CH
Enable Logik Pin Steuert Spannungsversorgung der Schaltung
CAN Bus Transceiver
Sub-D Stecker Can-Bus
Opional 120 Ω zwischen CanL & CanH
DAC gibt eine Spannung zwischen 0 und 5 bzw 0 und 3.3 V aus. Gibt damit den Strom Isoll für den Regelkreis vor. 1V entspricht 1A Regelstrom. Maximal 2A Stromvorgabe vorgesehen, daher reicht 3.3V Versorgung.
Für stabile Kommunikation mit dem DAC: Option 1: Pegelwandlung von 5V auf möglichst störungsfreie 3.3V Option 2: Falls 5V Spannungsversorgung stabil genug verbindung einfach Brücken und DAC mit 5V betreiben.
Dual I2C Isolator Galvanisch Getrennte Kopplung auf Ground-float Niveau
Portexpander Steuert das Gate bzw. die Fotoseite der Optokoppler. Schaltet pro Pin den jeweiligen High- und Lowside Mosfet der zu balancenden Zelle
I2C Bus
STM32 Bluepill
iso i2c
Can Schnittstelle

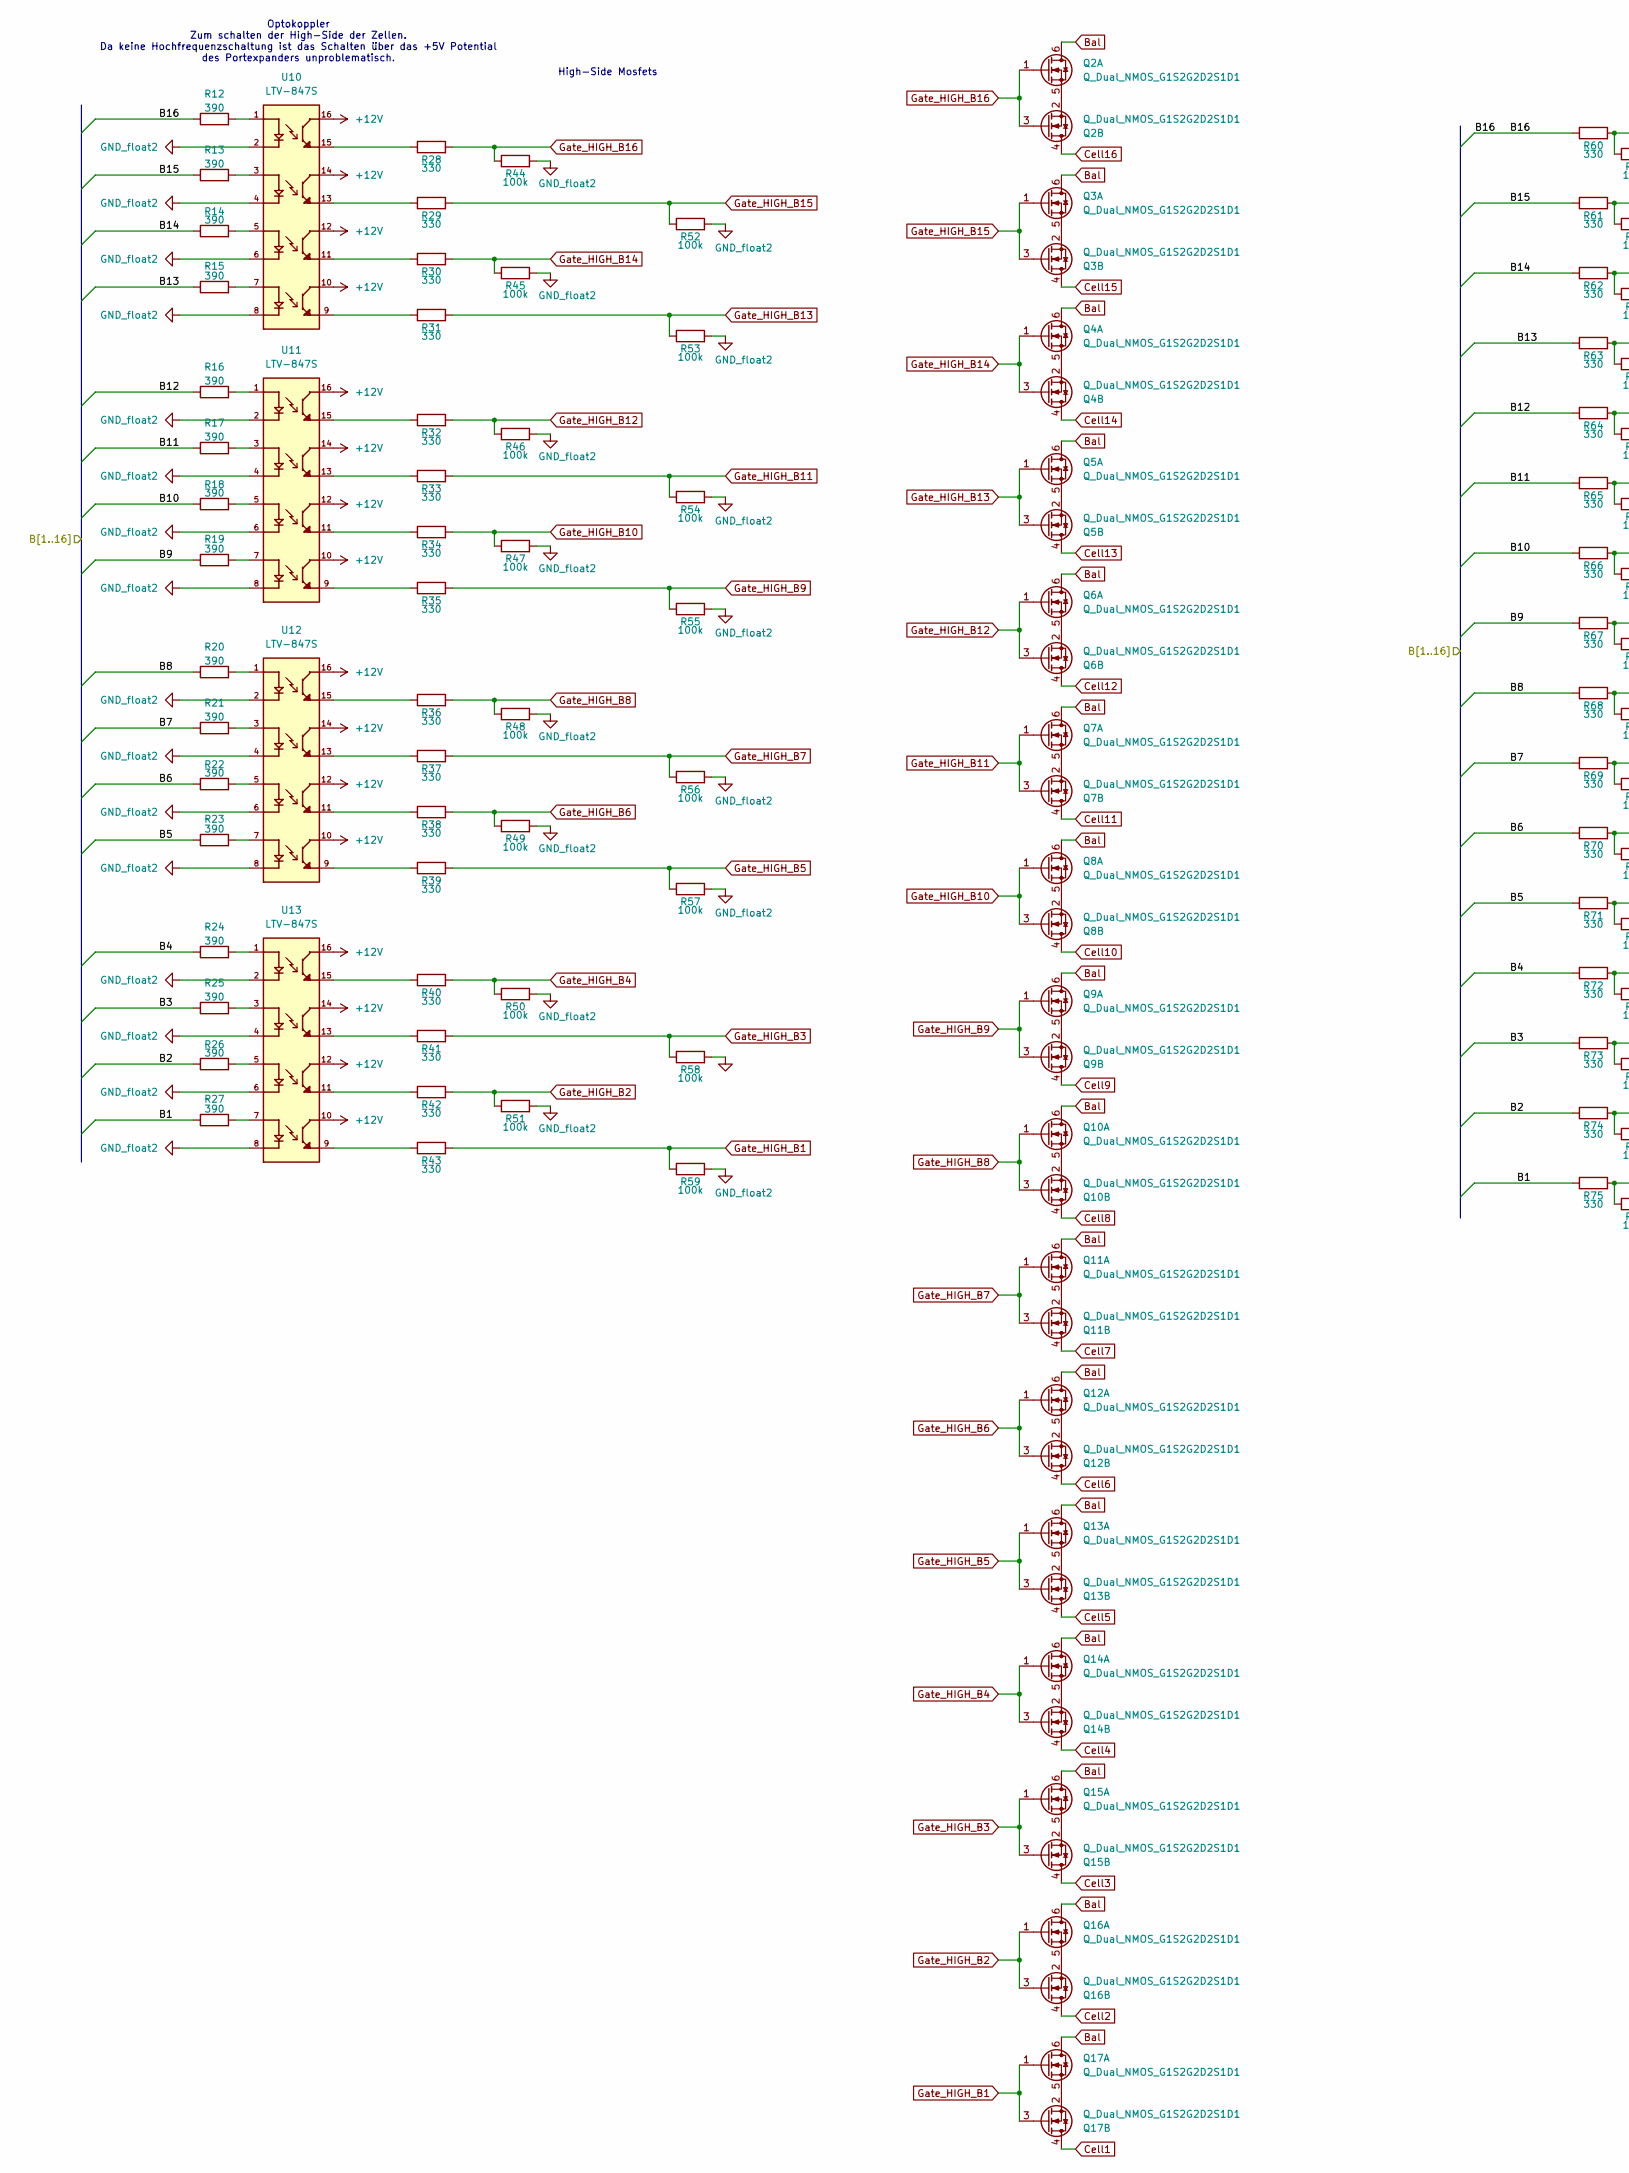
[picture p169: schematic power_mosfet.kicad_sch, Active Balancing, part in row 1, column 1]

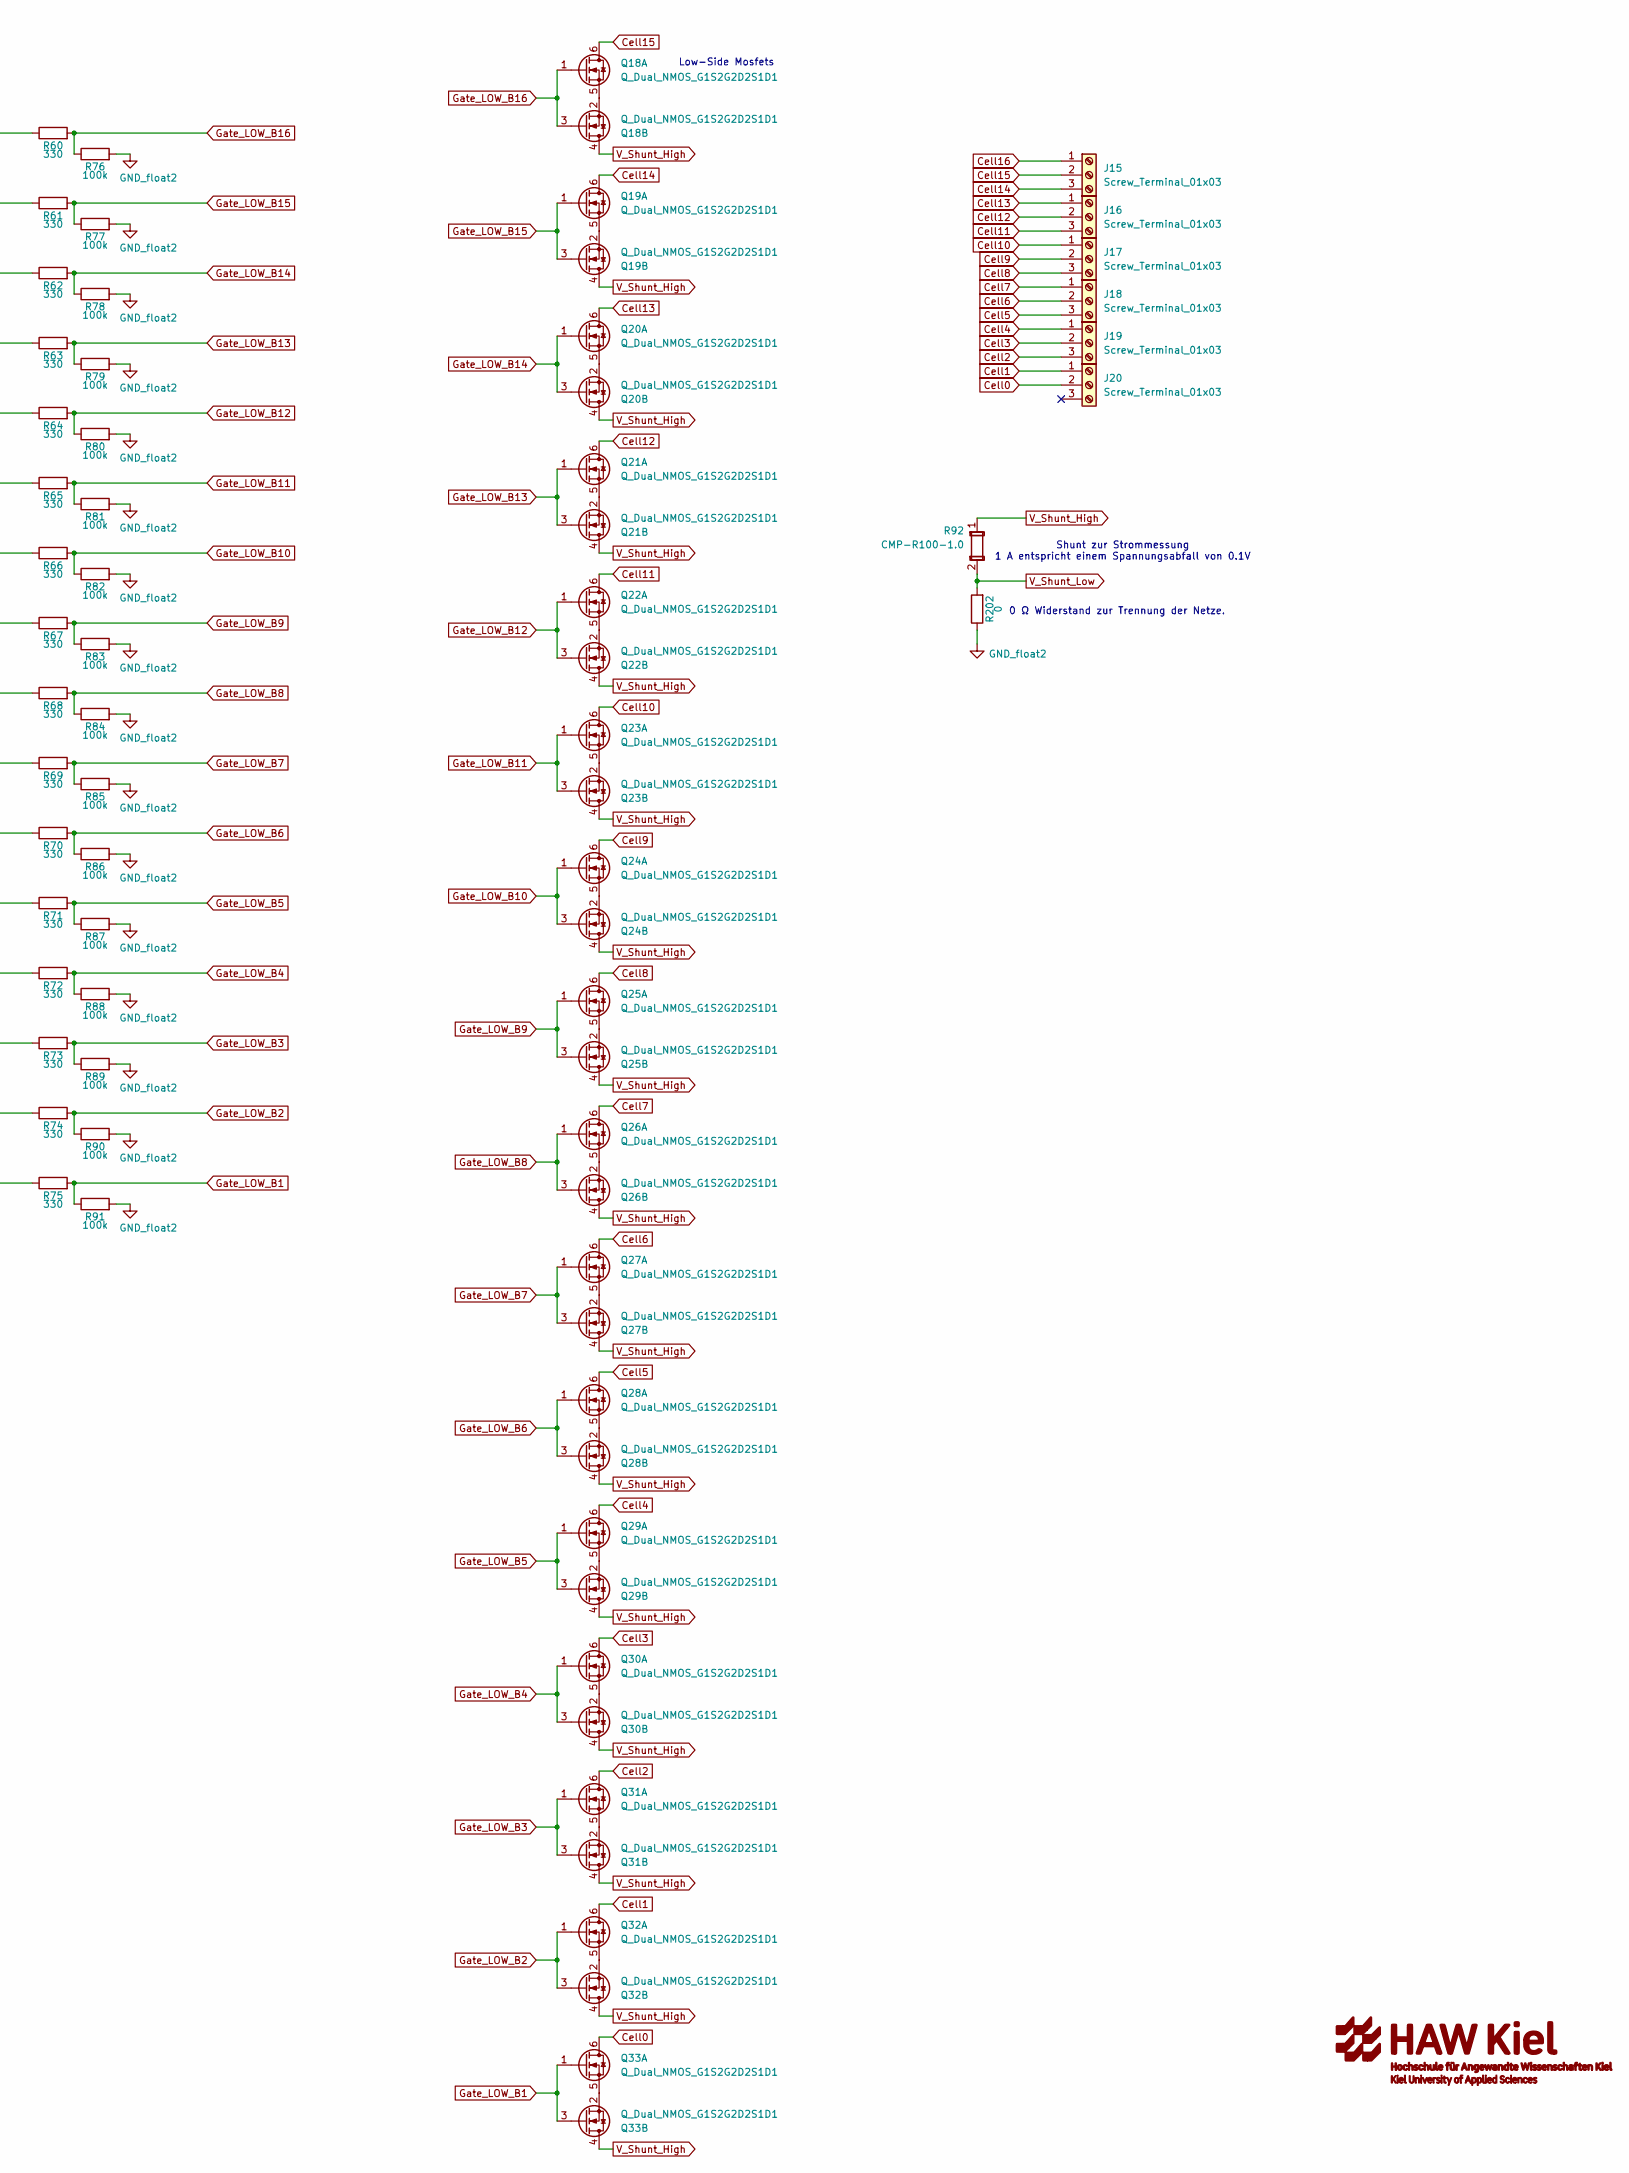
[picture p170: schematic power_mosfet.kicad_sch, Active Balancing, part in row 1, column 2]

Parts:
J15, J16, J17, J18, J19, J20: Screw_Terminal_01x03; TerminalBlock_4Ucon_1x03_P3.50mm_Horizontal_3d
Q2, Q3, Q4, Q5, Q6, Q7, Q8, Q9, Q10, Q11, Q12, Q13, Q14, Q15, Q16, Q17, Q18, Q19, Q20, Q21, Q22, Q23, Q24, Q25, Q26, Q27, Q28, Q29, Q30, Q31, Q32, Q33: Q_Dual_NMOS_G1S2G2D2S1D1; SOT-23-6
R12, R13, R14, R15, R16, R17, R18, R19, R20, R21, R22, R23, R24, R25, R26, R27: 390; R_0805_2012Metric
R28, R29, R30, R31, R32, R33, R34, R35, R36, R37, R38, R39, R40, R41, R42, R43, R60, R61, R62, R63, R64, R65, R66, R67, R68, R69, R70, R71, R72, R73, R74, R75: 330; R_0805_2012Metric
R44, R45, R46, R47, R48, R49, R50, R51, R52, R53, R54, R55, R56, R57, R58, R59, R76, R77, R78, R79, R80, R81, R82, R83, R84, R85, R86, R87, R88, R89, R90, R91: 100k; R_0805_2012Metric
R92: CMP-R100-1.0
R202: 0; R_0805_2012Metric
U10, U11, U12, U13: LTV-847S; SOIC254P1016X460-16N; PARTREV January 2010

Connections:
+12V: U10.10, U10.12, U10.14, U10.16, U11.10, U11.12, U11.14, U11.16, U12.10, U12.12, U12.14, U12.16, U13.10, U13.12, U13.14, U13.16; also elsewhere on the board
/B1: R27.1, R75.1; also elsewhere on the board
/B2: R26.1, R74.1; also elsewhere on the board
/B3: R25.1, R73.1; also elsewhere on the board
/B4: R24.1, R72.1; also elsewhere on the board
/B5: R23.1, R71.1; also elsewhere on the board
/B6: R22.1, R70.1; also elsewhere on the board
/B7: R21.1, R69.1; also elsewhere on the board
/B8: R20.1, R68.1; also elsewhere on the board
/B9: R19.1, R67.1; also elsewhere on the board
/B10: R18.1, R66.1; also elsewhere on the board
/B11: R17.1, R65.1; also elsewhere on the board
/B12: R16.1, R64.1; also elsewhere on the board
/B13: R15.1, R63.1; also elsewhere on the board
/B14: R14.1, R62.1; also elsewhere on the board
/B15: R13.1, R61.1; also elsewhere on the board
/B16: R12.1, R60.1; also elsewhere on the board
Bal: Q2.6 (D), Q3.6 (D), Q4.6 (D), Q5.6 (D), Q6.6 (D), Q7.6 (D), Q8.6 (D), Q9.6 (D), Q10.6 (D), Q11.6 (D), Q12.6 (D), Q13.6 (D), Q14.6 (D), Q15.6 (D), Q16.6 (D), Q17.6 (D); also elsewhere on the board
Cell0: J20.2, Q33.6 (D)
Cell1: J20.1, Q17.4 (D), Q32.6 (D)
Cell2: J19.3, Q16.4 (D), Q31.6 (D)
Cell3: J19.2, Q15.4 (D), Q30.6 (D)
Cell4: J19.1, Q14.4 (D), Q29.6 (D)
Cell5: J18.3, Q13.4 (D), Q28.6 (D)
Cell6: J18.2, Q12.4 (D), Q27.6 (D)
Cell7: J18.1, Q11.4 (D), Q26.6 (D)
Cell8: J17.3, Q10.4 (D), Q25.6 (D)
Cell9: J17.2, Q9.4 (D), Q24.6 (D)
Cell10: J17.1, Q8.4 (D), Q23.6 (D)
Cell11: J16.3, Q7.4 (D), Q22.6 (D)
Cell12: J16.2, Q6.4 (D), Q21.6 (D)
Cell13: J16.1, Q5.4 (D), Q20.6 (D)
Cell14: J15.3, Q4.4 (D), Q19.6 (D)
Cell15: J15.2, Q3.4 (D), Q18.6 (D)
Cell16: J15.1, Q2.4 (D)
GND_float2: R44.2, R45.2, R46.2, R47.2, R48.2, R49.2, R50.2, R51.2, R52.2, R53.2, R54.2, R55.2, R56.2, R57.2, R58.2, R59.2, R76.2, R77.2, R78.2, R79.2, R80.2, R81.2, R82.2, R83.2, R84.2, R85.2, R86.2, R87.2, R88.2, R89.2, R90.2, R91.2, R202.1, U10.2, U10.4, U10.6, U10.8, U11.2, U11.4, U11.6, U11.8, U12.2, U12.4, U12.6, U12.8, U13.2, U13.4, U13.6, U13.8; also elsewhere on the board
Gate_HIGH_B1: Q17.1 (G), Q17.3 (G), R43.2, R59.1
Gate_HIGH_B2: Q16.1 (G), Q16.3 (G), R42.2, R51.1
Gate_HIGH_B3: Q15.1 (G), Q15.3 (G), R41.2, R58.1
Gate_HIGH_B4: Q14.1 (G), Q14.3 (G), R40.2, R50.1
Gate_HIGH_B5: Q13.1 (G), Q13.3 (G), R39.2, R57.1
Gate_HIGH_B6: Q12.1 (G), Q12.3 (G), R38.2, R49.1
Gate_HIGH_B7: Q11.1 (G), Q11.3 (G), R37.2, R56.1
Gate_HIGH_B8: Q10.1 (G), Q10.3 (G), R36.2, R48.1
Gate_HIGH_B9: Q9.1 (G), Q9.3 (G), R35.2, R55.1
Gate_HIGH_B10: Q8.1 (G), Q8.3 (G), R34.2, R47.1
Gate_HIGH_B11: Q7.1 (G), Q7.3 (G), R33.2, R54.1
Gate_HIGH_B12: Q6.1 (G), Q6.3 (G), R32.2, R46.1
Gate_HIGH_B13: Q5.1 (G), Q5.3 (G), R31.2, R53.1
Gate_HIGH_B14: Q4.1 (G), Q4.3 (G), R30.2, R45.1
Gate_HIGH_B15: Q3.1 (G), Q3.3 (G), R29.2, R52.1
Gate_HIGH_B16: Q2.1 (G), Q2.3 (G), R28.2, R44.1
Gate_LOW_B1: Q33.1 (G), Q33.3 (G), R75.2, R91.1
Gate_LOW_B2: Q32.1 (G), Q32.3 (G), R74.2, R90.1
Gate_LOW_B3: Q31.1 (G), Q31.3 (G), R73.2, R89.1
Gate_LOW_B4: Q30.1 (G), Q30.3 (G), R72.2, R88.1
Gate_LOW_B5: Q29.1 (G), Q29.3 (G), R71.2, R87.1
Gate_LOW_B6: Q28.1 (G), Q28.3 (G), R70.2, R86.1
Gate_LOW_B7: Q27.1 (G), Q27.3 (G), R69.2, R85.1
Gate_LOW_B8: Q26.1 (G), Q26.3 (G), R68.2, R84.1
Gate_LOW_B9: Q25.1 (G), Q25.3 (G), R67.2, R83.1
Gate_LOW_B10: Q24.1 (G), Q24.3 (G), R66.2, R82.1
Gate_LOW_B11: Q23.1 (G), Q23.3 (G), R65.2, R81.1
Gate_LOW_B12: Q22.1 (G), Q22.3 (G), R64.2, R80.1
Gate_LOW_B13: Q21.1 (G), Q21.3 (G), R63.2, R79.1
Gate_LOW_B14: Q20.1 (G), Q20.3 (G), R62.2, R78.1
Gate_LOW_B15: Q19.1 (G), Q19.3 (G), R61.2, R77.1
Gate_LOW_B16: Q18.1 (G), Q18.3 (G), R60.2, R76.1
unnamed: Q2.2 (S), Q2.5 (S)
unnamed: Q3.2 (S), Q3.5 (S)
unnamed: Q4.2 (S), Q4.5 (S)
unnamed: Q5.2 (S), Q5.5 (S)
unnamed: Q6.2 (S), Q6.5 (S)
unnamed: Q7.2 (S), Q7.5 (S)
unnamed: Q8.2 (S), Q8.5 (S)
unnamed: Q9.2 (S), Q9.5 (S)
unnamed: Q10.2 (S), Q10.5 (S)
unnamed: Q11.2 (S), Q11.5 (S)
unnamed: Q12.2 (S), Q12.5 (S)
unnamed: Q13.2 (S), Q13.5 (S)
unnamed: Q14.2 (S), Q14.5 (S)
unnamed: Q15.2 (S), Q15.5 (S)
unnamed: Q16.2 (S), Q16.5 (S)
unnamed: Q17.2 (S), Q17.5 (S)
unnamed: Q18.2 (S), Q18.5 (S)
unnamed: Q19.2 (S), Q19.5 (S)
unnamed: Q20.2 (S), Q20.5 (S)
unnamed: Q21.2 (S), Q21.5 (S)
unnamed: Q22.2 (S), Q22.5 (S)
unnamed: Q23.2 (S), Q23.5 (S)
unnamed: Q24.2 (S), Q24.5 (S)
unnamed: Q25.2 (S), Q25.5 (S)
unnamed: Q26.2 (S), Q26.5 (S)
unnamed: Q27.2 (S), Q27.5 (S)
unnamed: Q28.2 (S), Q28.5 (S)
unnamed: Q29.2 (S), Q29.5 (S)
unnamed: Q30.2 (S), Q30.5 (S)
unnamed: Q31.2 (S), Q31.5 (S)
unnamed: Q32.2 (S), Q32.5 (S)
unnamed: Q33.2 (S), Q33.5 (S)
unnamed: R12.2, U10.1
unnamed: R13.2, U10.3
unnamed: R14.2, U10.5
unnamed: R15.2, U10.7
unnamed: R16.2, U11.1
unnamed: R17.2, U11.3
unnamed: R18.2, U11.5
unnamed: R19.2, U11.7
unnamed: R20.2, U12.1
unnamed: R21.2, U12.3
unnamed: R22.2, U12.5
unnamed: R23.2, U12.7
unnamed: R24.2, U13.1
unnamed: R25.2, U13.3
unnamed: R26.2, U13.5
unnamed: R27.2, U13.7
unnamed: R28.1, U10.15
unnamed: R29.1, U10.13
unnamed: R30.1, U10.11
unnamed: R31.1, U10.9
unnamed: R32.1, U11.15
unnamed: R33.1, U11.13
unnamed: R34.1, U11.11
unnamed: R35.1, U11.9
unnamed: R36.1, U12.15
unnamed: R37.1, U12.13
unnamed: R38.1, U12.11
unnamed: R39.1, U12.9
unnamed: R40.1, U13.15
unnamed: R41.1, U13.13
unnamed: R42.1, U13.11
unnamed: R43.1, U13.9
V_Shunt_High: Q18.4 (D), Q19.4 (D), Q20.4 (D), Q21.4 (D), Q22.4 (D), Q23.4 (D), Q24.4 (D), Q25.4 (D), Q26.4 (D), Q27.4 (D), Q28.4 (D), Q29.4 (D), Q30.4 (D), Q31.4 (D), Q32.4 (D), Q33.4 (D), R92.1; also elsewhere on the board
V_Shunt_Low: R92.2, R202.2; also elsewhere on the board

Notes on the sheet:
Optokoppler Zum schalten der High-Side der Zellen. Da keine Hochfrequenzschaltung ist das Schalten über das +5V Potential des Portexpanders unproblematisch.
Shunt zur Strommessung 1 A entspricht einem Spannungsabfall von 0.1V
High-Side Mosfets
0 Ω Widerstand zur Trennung der Netze.
Low-Side Mosfets

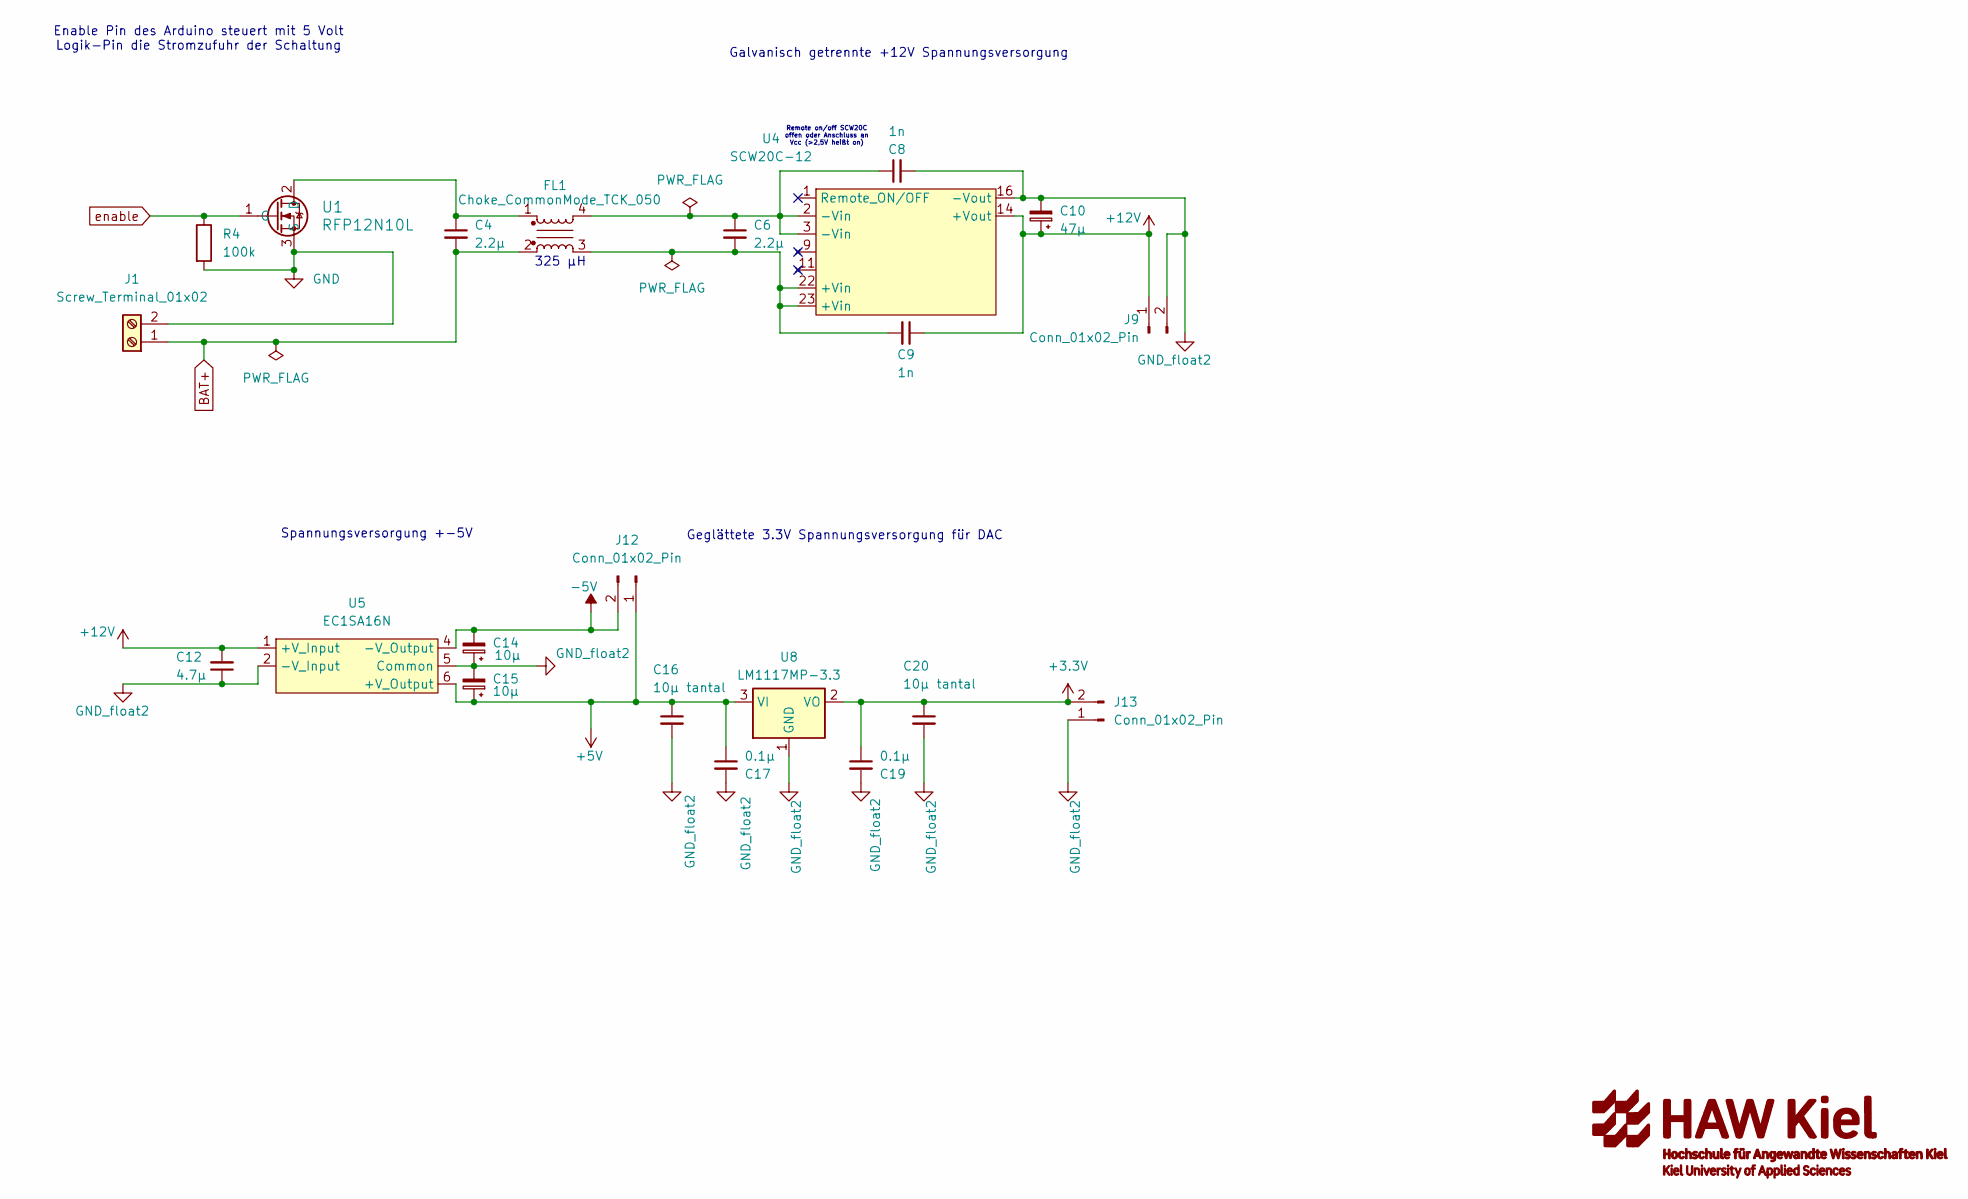
[picture p171: schematic Spannungsversorgung.kicad_sch, Active Balancing]

Parts:
C4, C6: 2.2µ; C_0805_2012Metric
C8, C9: 1n; C_0805_2012Metric
C10: 47µ; CP_Elec_5x5.3
C12: 4.7µ; C_0805_2012Metric
C14, C15: 10µ; CP_Elec_5x5.3
C16, C20: 10µ tantal; C_0805_2012Metric
C17, C19: 0.1µ; C_0805_2012Metric
FL1: Choke_CommonMode_TCK_050; common mode choke foot
J1: Screw_Terminal_01x02; 1-2-5mmTerminalBlock_MetzConnect_Type055_RT01502HDWU_1x02_P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
J9, J12, J13: Conn_01x02_Pin; PinHeader_1x02_P2.54mm_Vertical
R4: 100k; R_0805_2012Metric
U1: RFP12N10L; TO-220AB_ONS
U4: SCW20C-12
U5: EC1SA16N
U8: LM1117MP-3.3; SOT-223-3_TabPin2

Connections:
+3.3V: C19.1, C20.1, J13.2, U8.2 (VO); also elsewhere on the board
+5V: C15.1, C16.1, C17.1, J12.1, U5.6 (+V_Output), U8.3 (VI); also elsewhere on the board
+12V: C9.1, C10.1, C12.2, J9.1, U4.14 (+Vout), U5.1 (+V_Input); also elsewhere on the board
-5V: C14.2, J12.2, U5.4 (-V_Output); also elsewhere on the board
BAT+: C4.2, FL1.2, J1.1
GND: J1.2, R4.2, U1.3 (S); also elsewhere on the board
GND_float2: C8.2, C10.2, C12.1, C14.1, C15.2, C16.2, C17.2, C19.2, C20.2, J9.2, J13.1, U4.16 (-Vout), U5.2 (-V_Input), U5.5 (Common), U8.1 (GND); also elsewhere on the board
unnamed: C6.1, C8.1, FL1.4, U4.2 (-Vin), U4.3 (-Vin)
unnamed: C6.2, C9.2, FL1.3, U4.22 (+Vin), U4.23 (+Vin)
unnamed: C4.1, FL1.1, U1.2 (D)
enable: R4.1, U1.1 (G); also elsewhere on the board

Notes on the sheet:
Remote on/off SCW20C offen oder Anschluss an Vcc (>2,5V heißt on)
Enable Pin des Arduino steuert mit 5 Volt Logik-Pin die Stromzufuhr der Schaltung
Galvanisch getrennte +12V Spannungsversorgung
Geglättete 3.3V Spannungsversorgung für DAC
Spannungsversorgung +-5V
325 µH
