QuarkBaellchen5/active-balancing/KiCad/Aktive_Bal_Bericht - V8 - Doppelmosfet/Aktive_Bal.kicad_pcb

## KiCad design KiCad/Aktive_Bal_Bericht - V8 - Doppelmosfet/Aktive_Bal.kicad_pcb (continued)

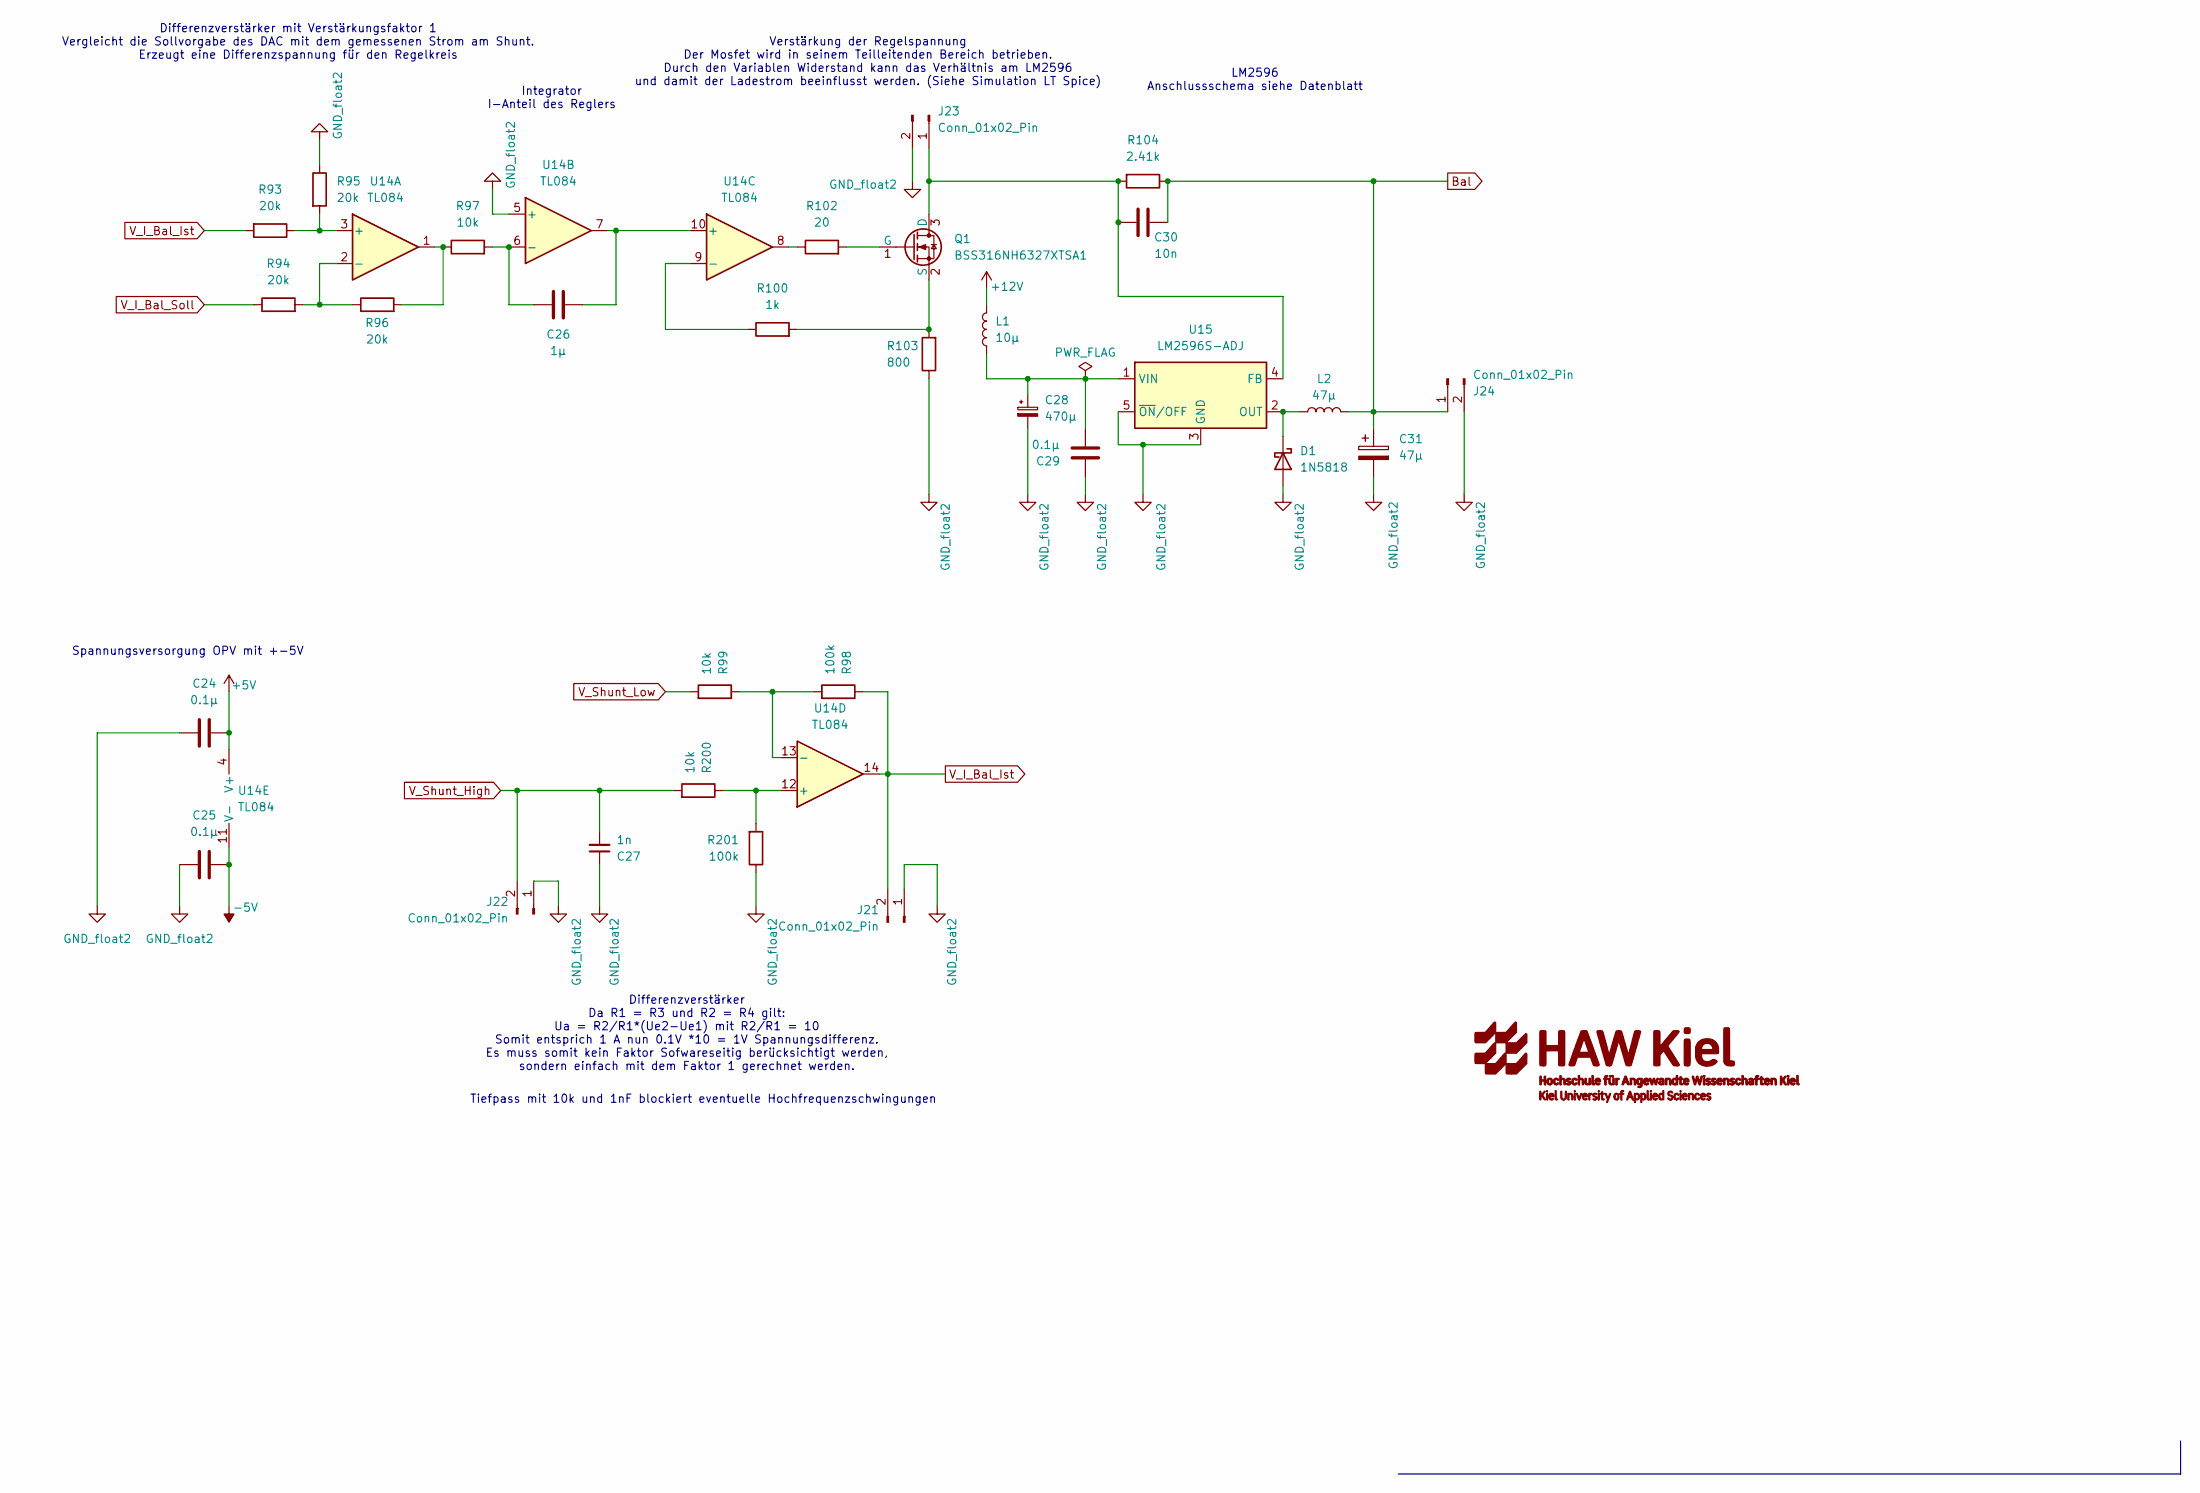
[picture p172: schematic controller.kicad_sch, Active Balancing]

Parts:
C24, C25, C29: 0.1µ; C_0805_2012Metric
C26: 1µ; C_0805_2012Metric
C27: 1n; C_0805_2012Metric
C28: 470µ; C_Elec_8x10.2
C30: 10n; C_0805_2012Metric
C31: 47µ; CP_Elec_5x5.3
D1: 1N5818; D_SMA
J21, J22, J23, J24: Conn_01x02_Pin; PinHeader_1x02_P2.54mm_Vertical
L1: 10µ; NRS6045
L2: 47µ; L_Bourns_SRR1260
Q1: BSS316NH6327XTSA1; SOT-23
R93, R94, R95, R96: 20k; R_0805_2012Metric
R97, R99, R200: 10k; R_0805_2012Metric
R98, R201: 100k; R_0805_2012Metric
R100: 1k; R_0805_2012Metric
R102: 20; R_0805_2012Metric
R103: 800; R_0805_2012Metric
R104: 2.41k; R_0805_2012Metric
U14: TL084; SOIC-14_3.9x8.7mm_P1.27mm
U15: LM2596S-ADJ; LM2596_5T

Connections:
+5V: C24.2, U14.4 (V+); also elsewhere on the board
+12V: L1.1; also elsewhere on the board
-5V: C25.2, U14.11 (V-); also elsewhere on the board
Bal: C30.2, C31.1, J24.1, L2.2, R104.1; also elsewhere on the board
GND_float2: C24.1, C25.1, C27.1, C28.2, C29.1, C31.2, D1.2 (A), J21.1, J22.1, J23.2, J24.2, R95.1, R103.1, R201.1, U14.5 (+), U15.3 (GND), U15.5 (~ON/OFF); also elsewhere on the board
unnamed: D1.1 (K), L2.1, U15.2 (OUT)
unnamed: C30.1, J23.1, Q1.3 (D), R104.2, U15.4 (FB)
unnamed: Q1.1 (G), R102.2
unnamed: Q1.2 (S), R100.2, R103.2
unnamed: R96.2, R97.1, U14.1
unnamed: R102.1, U14.8
unnamed: R93.1, R95.2, U14.3 (+)
unnamed: R94.2, R96.1, U14.2 (-)
unnamed: C26.1, R97.2, U14.6 (-)
unnamed: C26.2, U14.7, U14.10 (+)
unnamed: R100.1, U14.9 (-)
unnamed: R200.1, R201.2, U14.12 (+)
unnamed: R98.2, R99.1, U14.13 (-)
unnamed: C28.1, C29.2, L1.2, U15.1 (VIN)
V_I_Bal_Ist: J21.2, R93.2, R98.1, U14.14
V_I_Bal_Soll: R94.1; also elsewhere on the board
V_Shunt_High: C27.2, J22.2, R200.2; also elsewhere on the board
V_Shunt_Low: R99.2; also elsewhere on the board

Notes on the sheet:
Differenzverstärker Da R1 = R3 und R2 = R4 gilt: Ua = R2/R1*(Ue2-Ue1) mit R2/R1 = 10 Somit entsprich 1 A nun 0.1V *10 = 1V Spannungsdifferenz. Es muss somit kein Faktor Sofwareseitig berücksichtigt werden, sondern einfach mit dem Faktor 1 gerechnet werden.
LM2596 Anschlussschema siehe Datenblatt
Integrator I-Anteil des Reglers
Differenzverstärker mit Verstärkungsfaktor 1 Vergleicht die Sollvorgabe des DAC mit dem gemessenen Strom am Shunt. Erzeugt eine Differenzspannung für den Regelkreis
Verstärkung der Regelspannung Der Mosfet wird in seinem Teilleitenden Bereich betrieben. Durch den Variablen Widerstand kann das Verhältnis am LM2596 und damit der Ladestrom beeinflusst werden. (Siehe Simulation LT Spice)
Spannungsversorgung OPV mit +-5V
Tiefpass mit 10k und 1nF blockiert eventuelle Hochfrequenzschwingungen

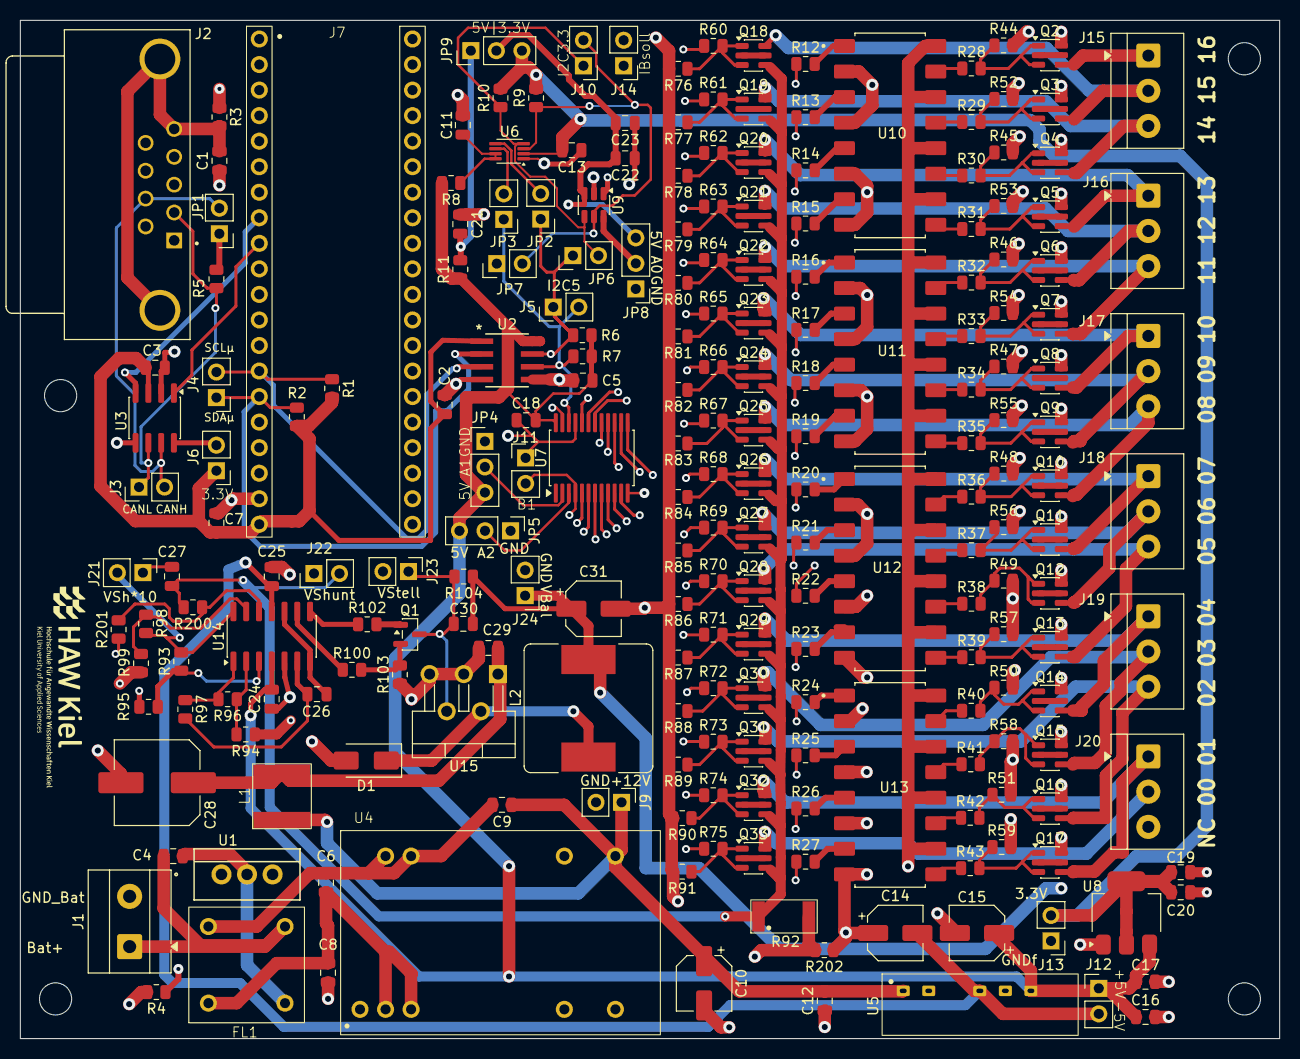
[picture p173: board Aktive_Bal.kicad_pcb from above]

Board: 4 copper layers, 125.2 x 101.3 mm, 225 parts (0 on the bottom side), 180 nets.
