QuarkBaellchen5/active-balancing/BM107/Versuch_7_Layouterestellung/BM107_V7_Layout/STM32_blue_pill.kicad_pcb

## KiCad design BM107/Versuch_7_Layouterestellung/BM107_V7_Layout/STM32_blue_pill.kicad_pcb (2026-06-11)

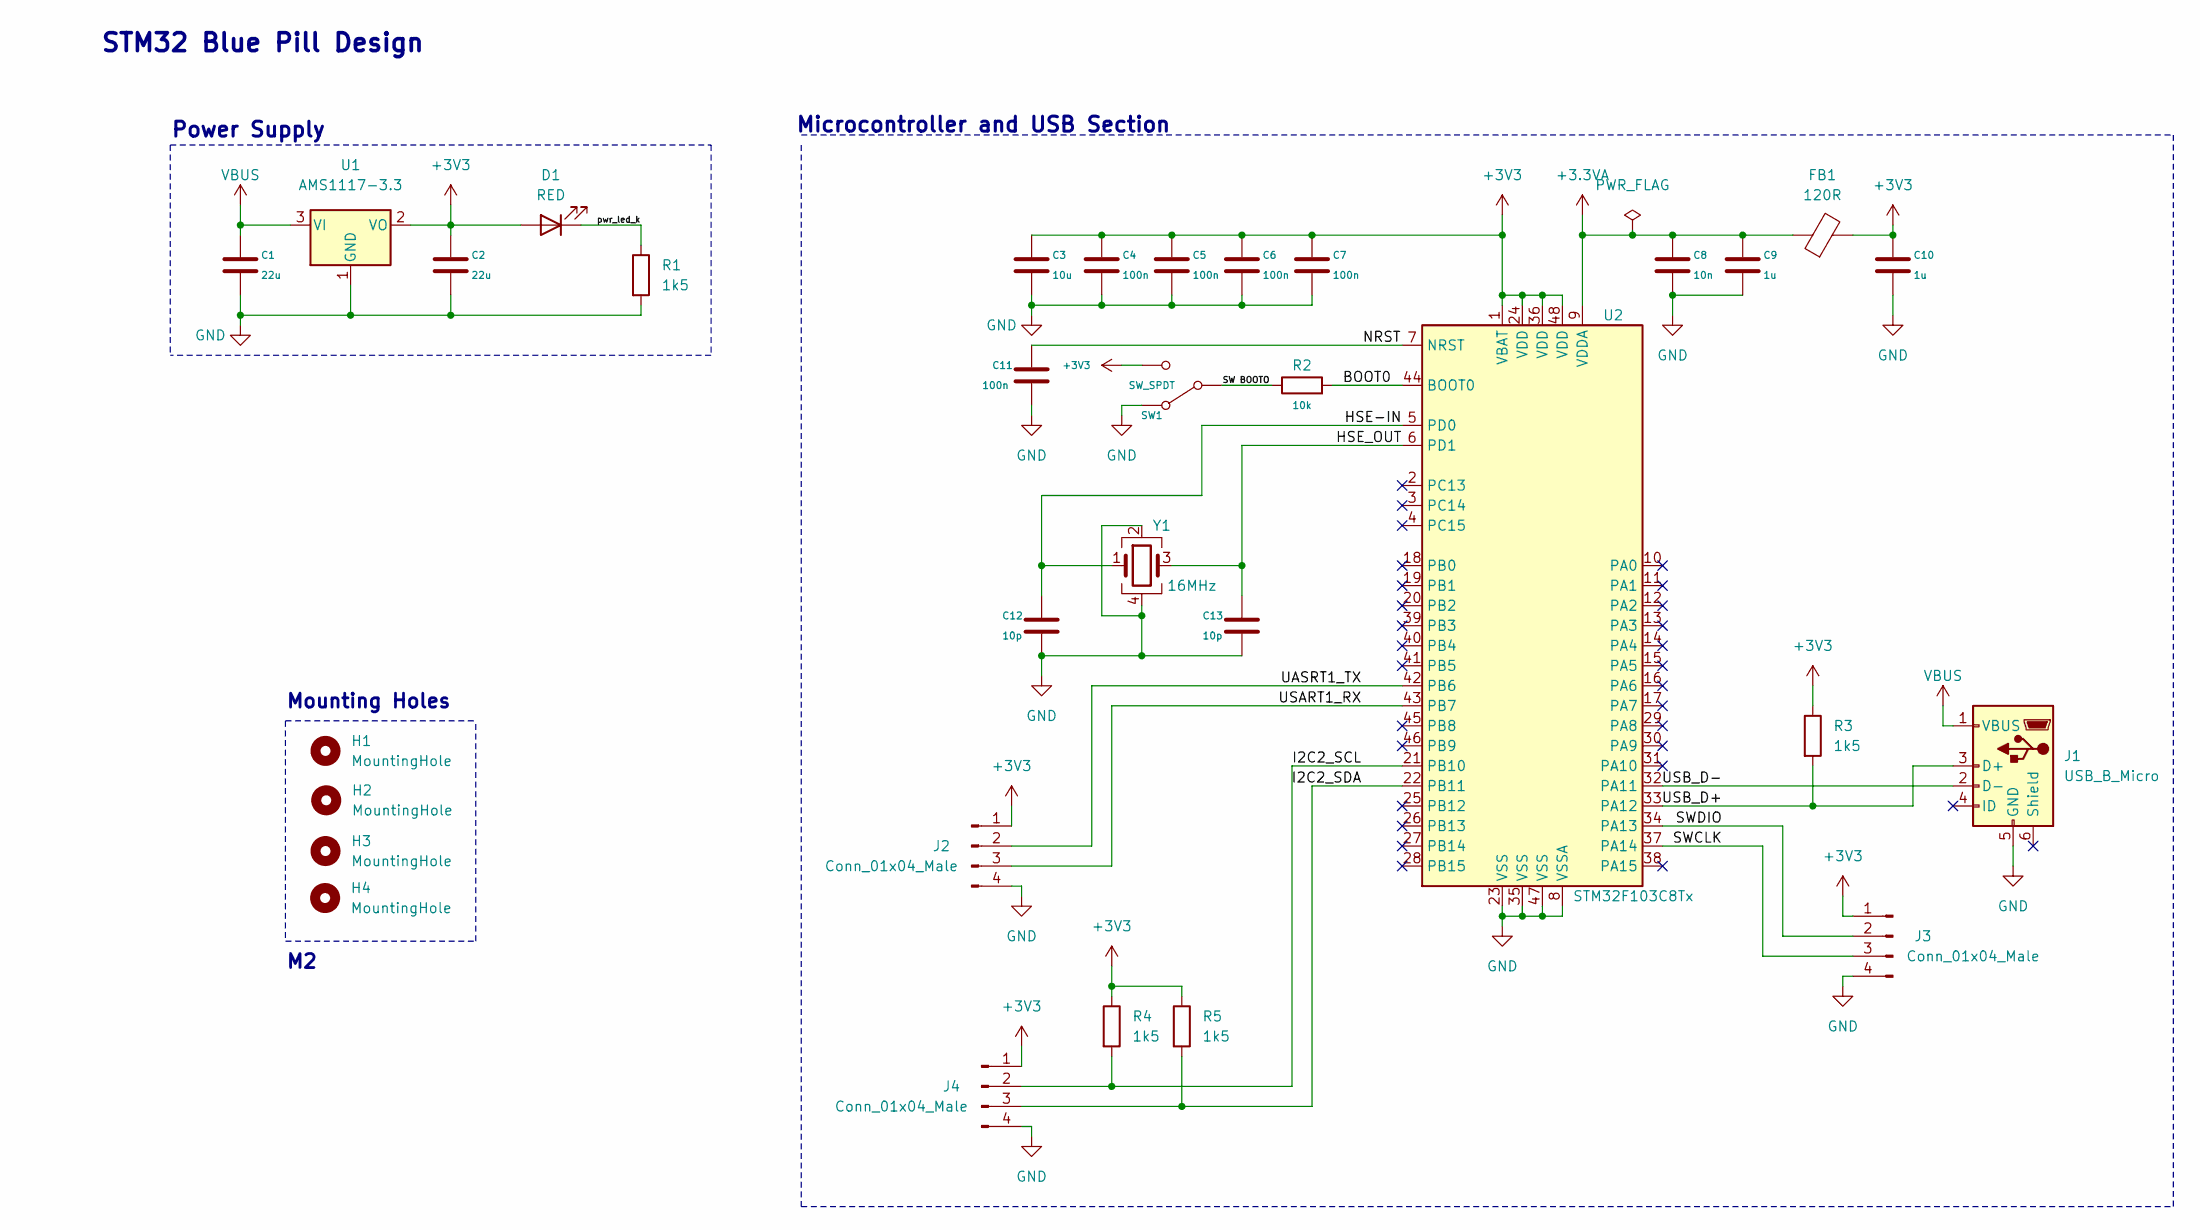
[picture p174: schematic STM32_blue_pill.kicad_sch, STM32 Blue pill]

Parts:
C1, C2: 22u; C_0805_2012Metric
C3: 10u; C_0603_1608Metric
C4, C5, C6, C7, C11: 100n; C_0402_1005Metric
C8: 10n; C_0402_1005Metric
C9, C10: 1u; C_0402_1005Metric
C12, C13: 10p; C_0402_1005Metric
D1: RED; LED_0402_1005Metric
FB1: 120R; L_0603_1608Metric
H1, H2, H3, H4: MountingHole; MountingHole_2.2mm_M2
J1: USB_B_Micro; USB_Micro-B_Wuerth_629105150521
J2, J3, J4: Conn_01x04_Male; PinHeader_1x04_P2.54mm_Vertical
R1, R3, R4, R5: 1k5; R_0402_1005Metric
R2: 10k; R_0402_1005Metric
SW1: SW_SPDT; SW_SPDT_PCM12
U1: AMS1117-3.3; SOT-223-3_TabPin2
U2: STM32F103C8Tx; LQFP-48_7x7mm_P0.5mm
Y1: 16MHz; Crystal_SMD_3225-4Pin_3.2x2.5mm

Connections:
+3.3VA: C8.1, C9.1, FB1.1, U2.9 (VDDA)
+3V3: C2.1, C3.1, C4.1, C5.1, C6.1, C7.1, C10.1, D1.2 (A), FB1.2, J2.1, J3.1, J4.1, R3.1, R4.1, R5.1, SW1.3 (C), U1.2 (VO), U2.1 (VBAT), U2.24 (VDD), U2.36 (VDD), U2.48 (VDD); also elsewhere on the board
/BOOT0: R2.2, U2.44 (BOOT0)
/HSE-IN: C12.1, U2.5 (PD0), Y1.1
/HSE_OUT: C13.1, U2.6 (PD1), Y1.3
/I2C2_SCL: J4.2, R4.2, U2.21 (PB10)
/I2C2_SDA: J4.3, R5.2, U2.22 (PB11)
/NRST: C11.1, U2.7 (NRST)
/SW BOOTO: R2.1, SW1.2 (B); also elsewhere on the board
/SWCLK: J3.3, U2.37 (PA14)
/SWDIO: J3.2, U2.34 (PA13)
/UASRT1_TX: J2.2, U2.42 (PB6)
/USART1_RX: J2.3, U2.43 (PB7)
/USB_D+: J1.3 (D+), R3.2, U2.33 (PA12)
/USB_D-: J1.2 (D-), U2.32 (PA11)
/pwr_led_k: D1.1 (K), R1.1
GND: C1.2, C2.2, C3.2, C4.2, C5.2, C6.2, C7.2, C8.2, C9.2, C10.2, C11.2, C12.2, C13.2, J1.5 (GND), J2.4, J3.4, J4.4, R1.2, SW1.1 (A), U1.1 (GND), U2.8 (VSSA), U2.23 (VSS), U2.35 (VSS), U2.47 (VSS), Y1.2, Y1.4; also elsewhere on the board
VBUS: C1.1, J1.1 (VBUS), U1.3 (VI)

Notes on the sheet:
STM32 Blue Pill Design
Mounting Holes
Power Supply
Microcontroller and USB Section

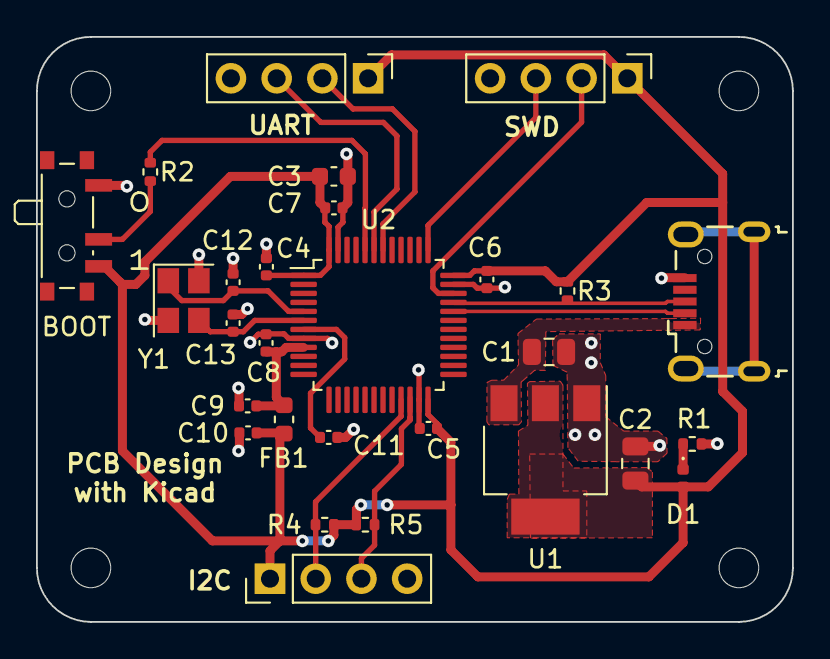
[picture p175: board STM32_blue_pill.kicad_pcb from above]

Board: 2 copper layers, 42.0 x 32.5 mm, 32 parts (0 on the bottom side), 18 nets.

Other parts of the board:
BOOT: SW_SPDT; SW_SPDT_PCM12

Their connections:
+3V3: BOOT.3 (C); also elsewhere on the board
/SW BOOTO: BOOT.2 (B); also elsewhere on the board
GND: BOOT.1 (A); also elsewhere on the board
