QuarkBaellchen5/active-balancing/BM107/Versuch_7_Layouterestellung/BM107_V7_Layout/BM107_V6_Layout.kicad_pcb

## KiCad design BM107/Versuch_7_Layouterestellung/BM107_V7_Layout/BM107_V6_Layout.kicad_pcb (2026-07-18)

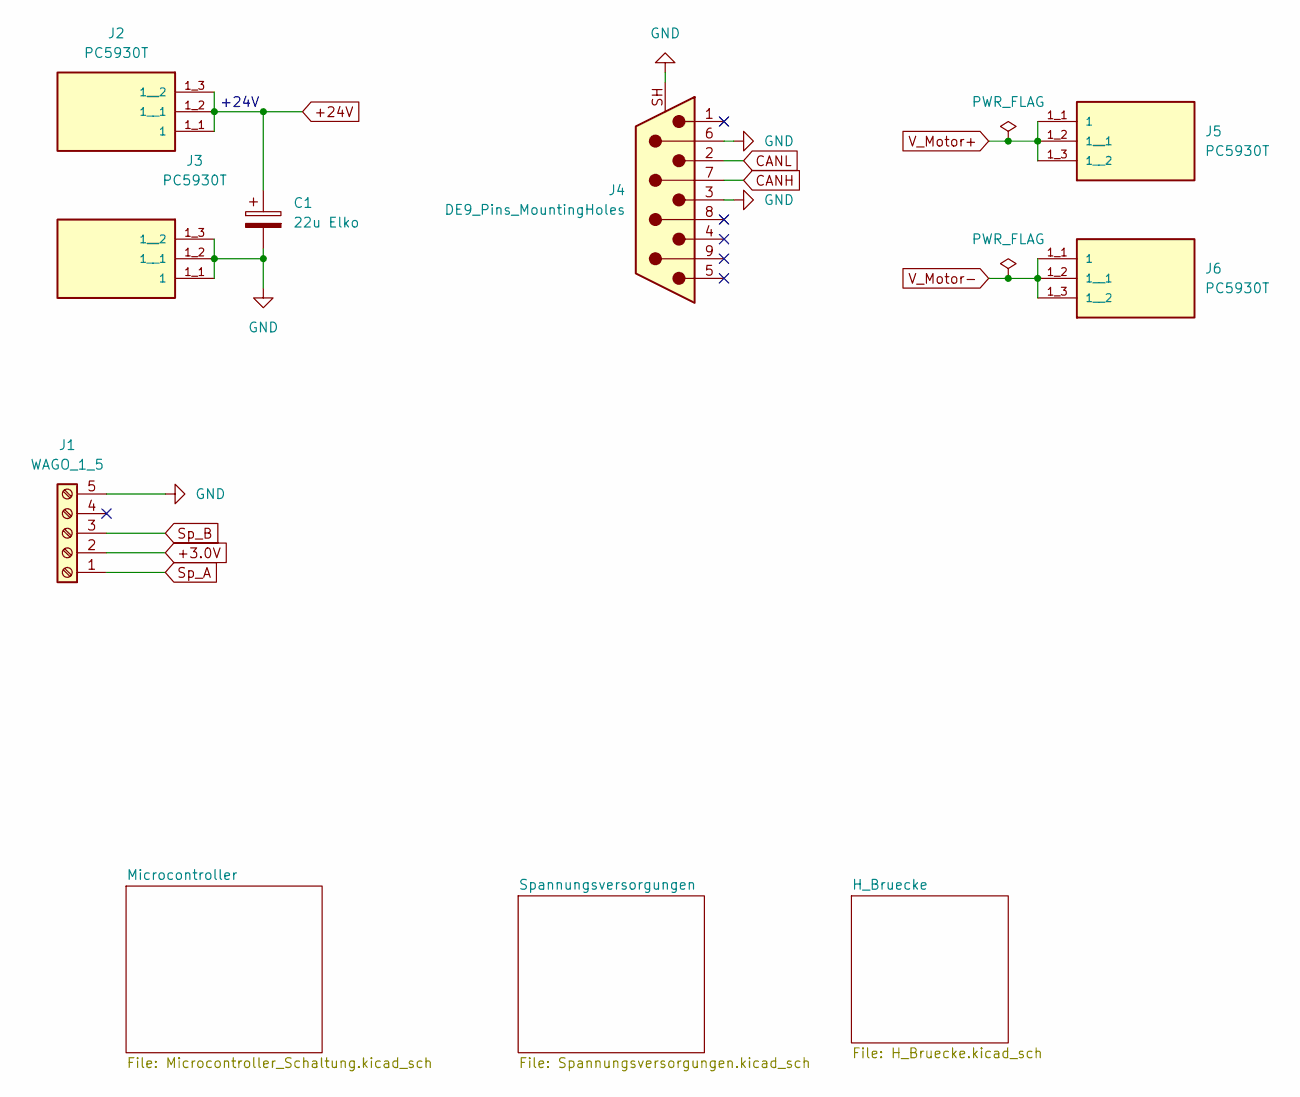
[picture p176: schematic BM107_V6_Layout.kicad_sch]

Parts:
C1: 22u Elko; CP_Elec_5x5.3
J1: WAGO_1_5; Wago_734-135_1x05_P3.50mm_Vertical
J2, J3, J5, J6: PC5930T; ANDERSONPOWER_PC5930T; PARTREV 4
J4: DE9_Pins_MountingHoles; D_SUB9_Stecker

Connections:
+3.0V: J1.2; also elsewhere on the board
+24V: C1.1, J2.1_1 (1), J2.1_2 (1__1), J2.1_3 (1__2); also elsewhere on the board
CANH: J4.7; also elsewhere on the board
CANL: J4.2; also elsewhere on the board
GND: C1.2, J1.5, J3.1_1 (1), J3.1_2 (1__1), J3.1_3 (1__2), J4.3, J4.6, J4.SH (PAD); also elsewhere on the board
Sp_A: J1.1; also elsewhere on the board
Sp_B: J1.3; also elsewhere on the board
V_Motor+: J5.1_1 (1), J5.1_2 (1__1), J5.1_3 (1__2); also elsewhere on the board
V_Motor-: J6.1_1 (1), J6.1_2 (1__1), J6.1_3 (1__2); also elsewhere on the board

Notes on the sheet:
+24V

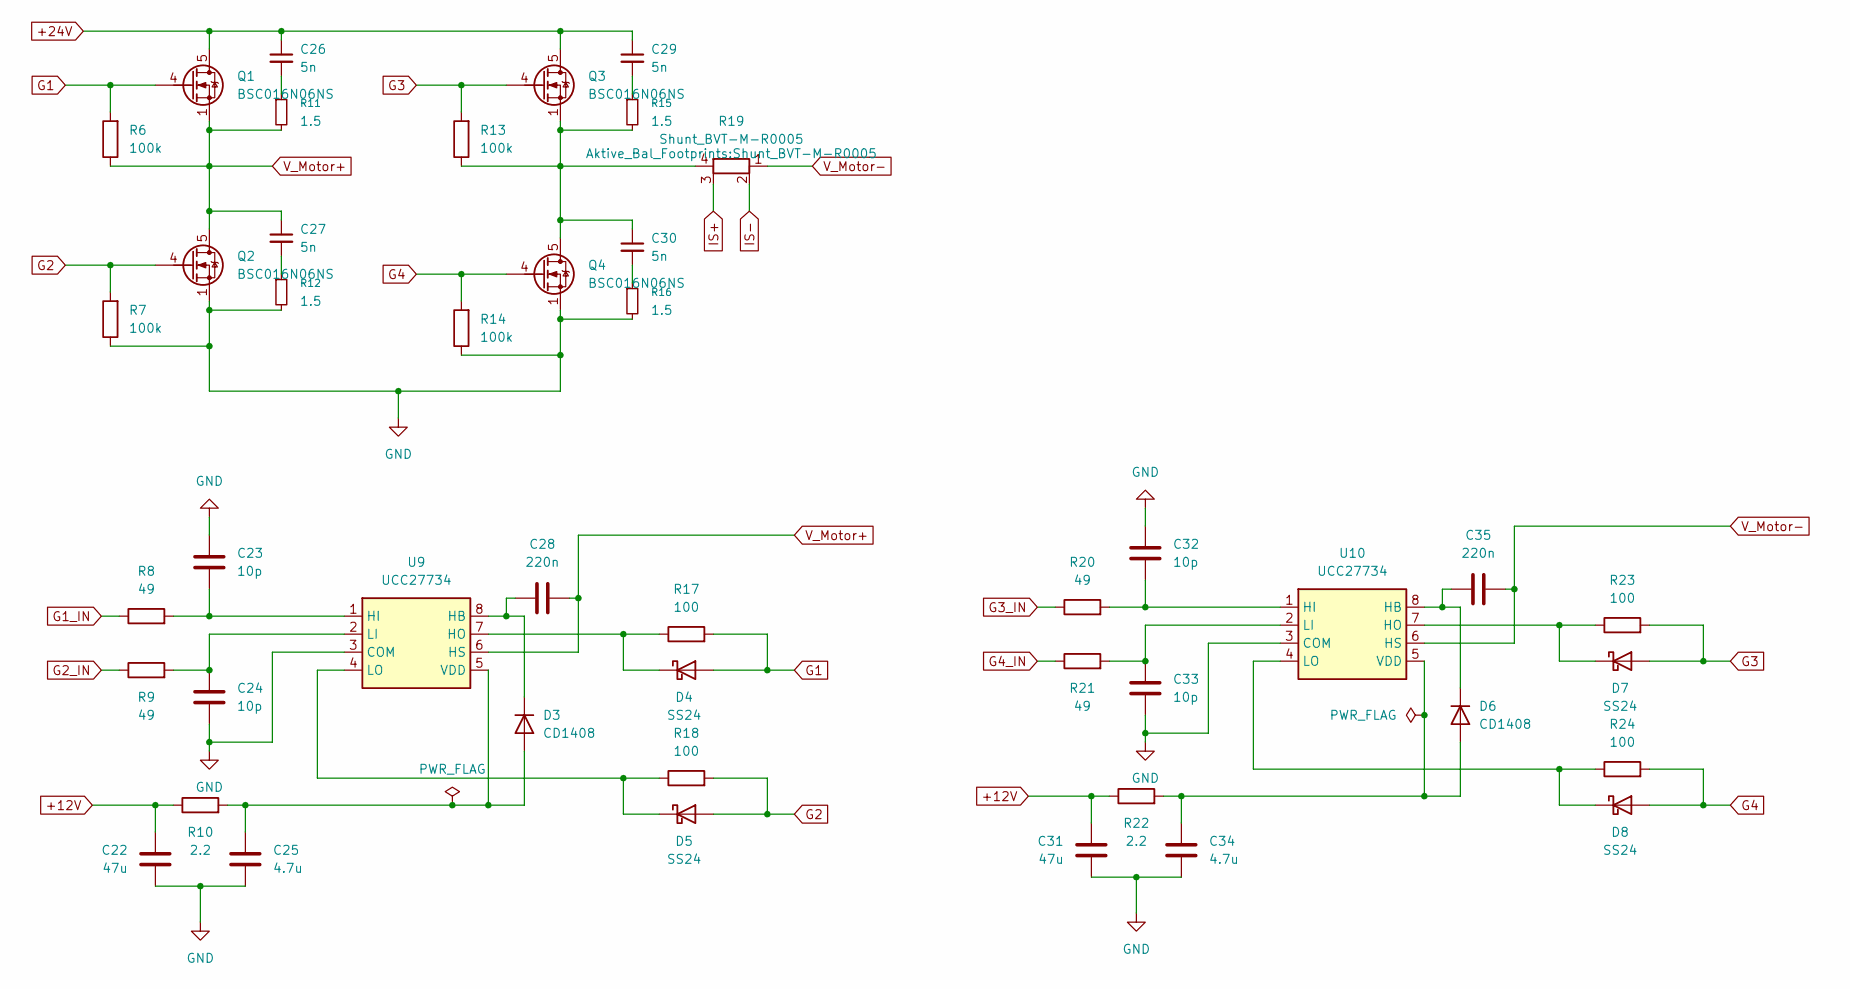
[picture p177: schematic H_Bruecke.kicad_sch]

Parts:
C22, C31: 47u; C_0805_2012Metric
C23, C24, C32, C33: 10p; C_0805_2012Metric
C25, C34: 4.7u; C_0805_2012Metric
C26, C27, C29, C30: 5n; C_0805_2012Metric
C28, C35: 220n; C_0805_2012Metric
D3, D6: CD1408; CD1408_Footprint
D4, D5, D7, D8: SS24; D_SMA
Q1, Q2, Q3, Q4: BSC016N06NS
R6, R7, R13, R14: 100k; R_0805_2012Metric
R8, R9, R20, R21: 49; R_0805_2012Metric
R10, R22: 2.2; R_0805_2012Metric
R11, R12, R15, R16: 1.5; R_0805_2012Metric
R17, R18, R23, R24: 100; R_0805_2012Metric
R19: Shunt_BVT-M-R0005
U9, U10: UCC27734; SOIC-8_3.9x4.9mm_P1.27mm_UCC27734

Connections:
+12V: C22.1, C31.1, R10.1, R22.1; also elsewhere on the board
+24V: C26.1, C29.1, Q1.5 (D), Q3.5 (D); also elsewhere on the board
G1: D4.2 (A), Q1.4 (G), R6.2, R17.2
G1_IN: R8.1; also elsewhere on the board
G2: D5.2 (A), Q2.4 (G), R7.2, R18.2
G2_IN: R9.1; also elsewhere on the board
G3: D7.2 (A), Q3.4 (G), R13.2, R23.2
G3_IN: R20.1; also elsewhere on the board
G4: D8.2 (A), Q4.4 (G), R14.2, R24.2
G4_IN: R21.1; also elsewhere on the board
GND: C22.2, C23.1, C24.2, C25.2, C31.2, C32.1, C33.2, C34.2, Q2.1 (S), Q2.2 (S), Q2.3 (S), Q4.1 (S), Q4.2 (S), Q4.3 (S), R7.1, R12.2, R14.1, R16.2, U9.3 (COM), U10.3 (COM); also elsewhere on the board
IS+: R19.3; also elsewhere on the board
IS-: R19.2; also elsewhere on the board
unnamed: C26.2, R11.1
unnamed: C27.2, R12.1
unnamed: C29.2, R15.1
unnamed: C30.2, R16.1
unnamed: C25.1, D3.2 (A), R10.2, U9.5 (VDD)
unnamed: C28.1, D3.1 (K), U9.8 (HB)
unnamed: D4.1 (K), R17.1, U9.7 (HO)
unnamed: D5.1 (K), R18.1, U9.4 (LO)
unnamed: C34.1, D6.2 (A), R22.2, U10.5 (VDD)
unnamed: C35.1, D6.1 (K), U10.8 (HB)
unnamed: D7.1 (K), R23.1, U10.7 (HO)
unnamed: D8.1 (K), R24.1, U10.4 (LO)
unnamed: C30.1, Q3.1 (S), Q3.2 (S), Q3.3 (S), Q4.5 (D), R13.1, R15.2, R19.4
unnamed: C23.2, R8.2, U9.1 (HI)
unnamed: C24.1, R9.2, U9.2 (LI)
unnamed: C32.2, R20.2, U10.1 (HI)
unnamed: C33.1, R21.2, U10.2 (LI)
V_Motor+: C27.1, C28.2, Q1.1 (S), Q1.2 (S), Q1.3 (S), Q2.5 (D), R6.1, R11.2, U9.6 (HS); also elsewhere on the board
V_Motor-: C35.2, R19.1, U10.6 (HS); also elsewhere on the board

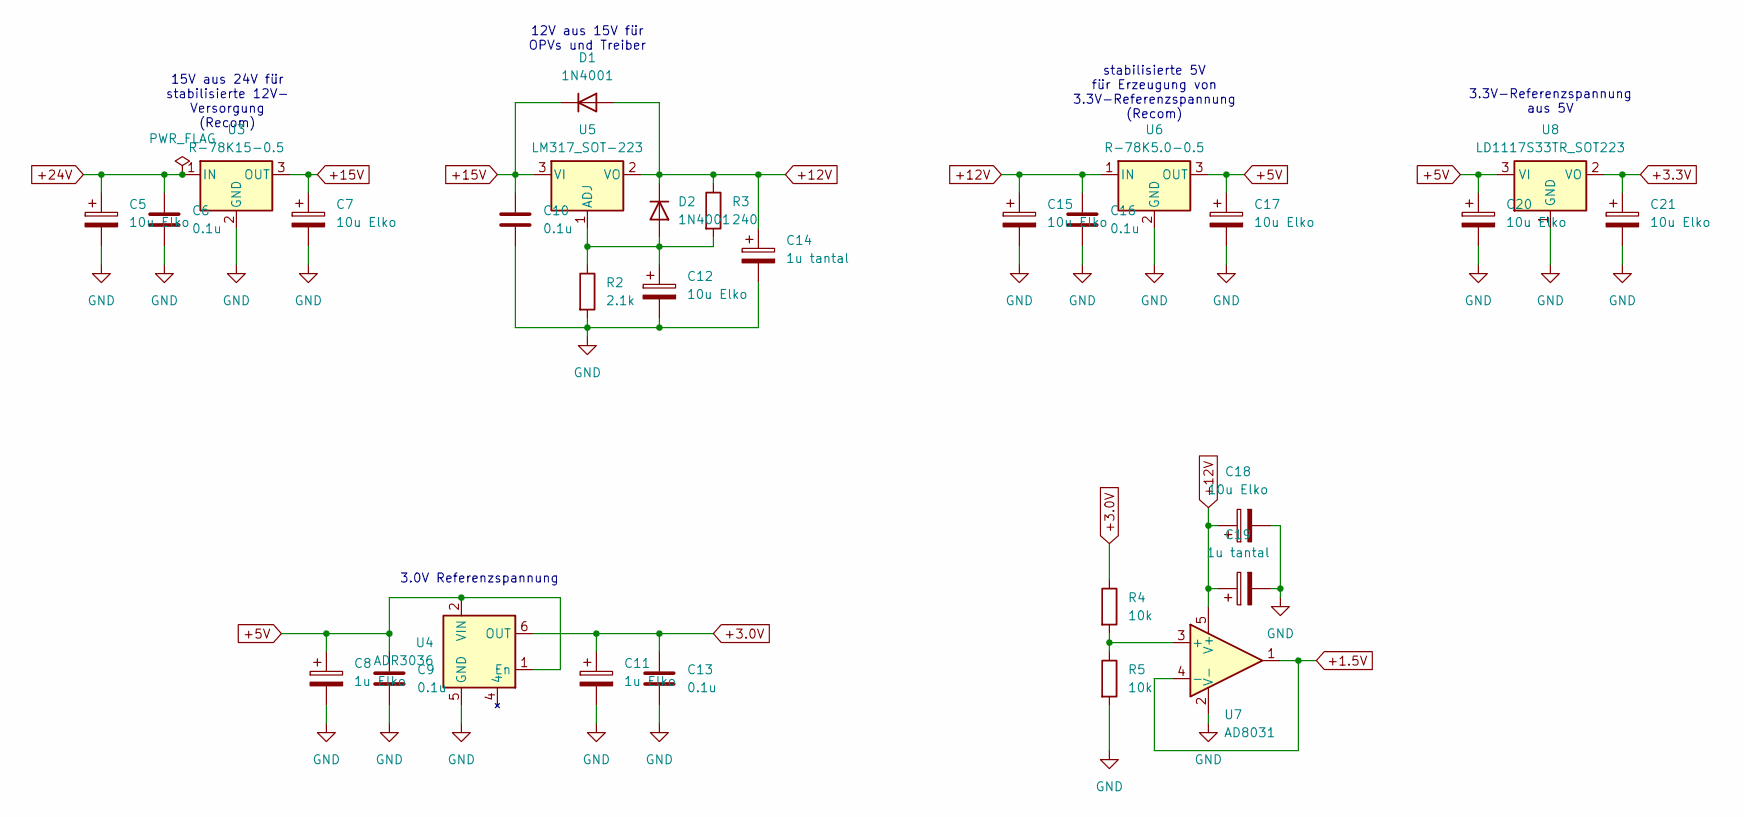
[picture p178: schematic Spannungsversorgungen.kicad_sch]

Parts:
C5, C7, C12, C15, C17, C18, C20, C21: 10u Elko; CP_Elec_5x5.3
C6, C9, C10, C13, C16: 0.1u; C_0805_2012Metric
C8, C11: 1u Elko; CP_Elec_5x5.3
C14, C19: 1u tantal; C_0805_2012Metric
D1, D2: 1N4001; D_DO-41_SOD81_P10.16mm_Horizontal
R2: 2.1k; R_0805_2012Metric
R3: 240; R_0805_2012Metric
R4, R5: 10k; R_0805_2012Metric
U3: R-78K15-0.5; Converter_DCDC_RECOM_R-78E-0.5_THT
U4: ADR3036; MSOP-8_3x3mm_P0.65mm
U5: LM317_SOT-223; SOT-223-3_TabPin2
U6: R-78K5.0-0.5; Converter_DCDC_RECOM_R-78E-0.5_THT
U7: AD8031; SOT-23-5
U8: LD1117S33TR_SOT223; SOT-223-3_TabPin2

Connections:
+1.5V: U7.1, U7.4 (-); also elsewhere on the board
+3.0V: C11.1, C13.1, R4.1, U4.6 (OUT); also elsewhere on the board
+3.3V: C21.1, U8.2 (VO); also elsewhere on the board
+5V: C8.1, C9.1, C17.1, C20.1, U4.1 (En), U4.2 (VIN), U6.3 (OUT), U8.3 (VI); also elsewhere on the board
+12V: C14.1, C15.1, C16.1, C18.1, C19.1, D1.2 (A), D2.1 (K), R3.1, U5.2 (VO), U6.1 (IN), U7.5 (V+); also elsewhere on the board
+15V: C7.1, C10.1, D1.1 (K), U3.3 (OUT), U5.3 (VI)
+24V: C5.1, C6.1, U3.1 (IN); also elsewhere on the board
GND: C5.2, C6.2, C7.2, C8.2, C9.2, C10.2, C11.2, C12.2, C13.2, C14.2, C15.2, C16.2, C17.2, C18.2, C19.2, C20.2, C21.2, R2.2, R5.2, U3.2 (GND), U4.5 (GND), U6.2 (GND), U7.2 (V-), U8.1 (GND); also elsewhere on the board
unnamed: C12.1, D2.2 (A), R2.1, R3.2, U5.1 (ADJ)
unnamed: R4.2, R5.1, U7.3 (+)

Notes on the sheet:
12V aus 15V für OPVs und Treiber
stabilisierte 5V für Erzeugung von 3.3V-Referenzspannung (Recom)
3.3V-Referenzspannung aus 5V
3.0V Referenzspannung
15V aus 24V für stabilisierte 12V- Versorgung (Recom)

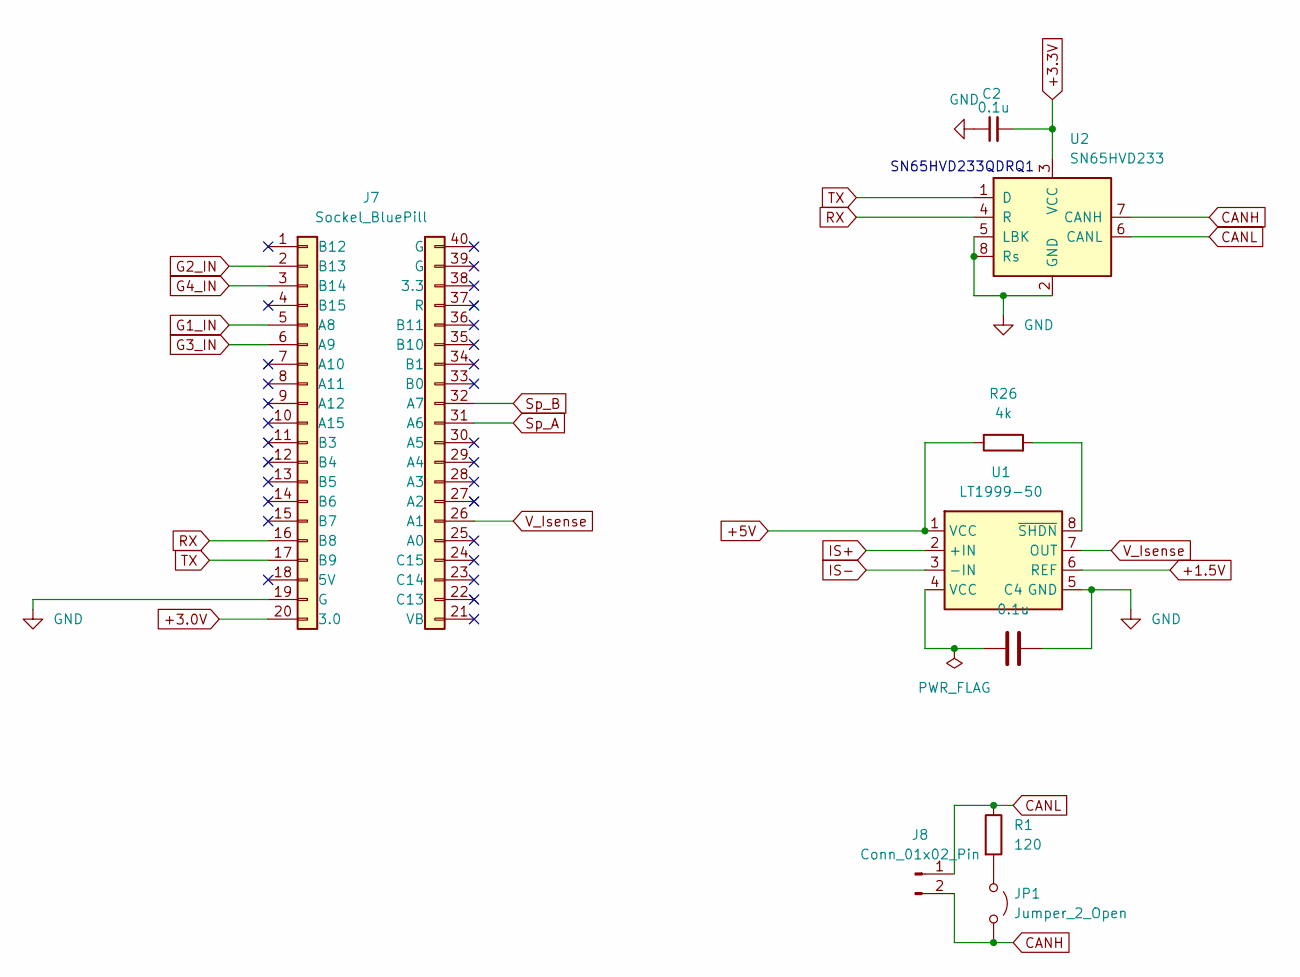
[picture p179: schematic Microcontroller_Schaltung.kicad_sch]

Parts:
C2, C4: 0.1u; C_0805_2012Metric
J7: Sockel_BluePill; SockelBluepill Dupont leisten
J8: Conn_01x02_Pin; PinHeader_1x02_P2.54mm_Vertical
JP1: Jumper_2_Open; SolderJumper-2_P1.3mm_Open_TrianglePad1.0x1.5mm
R1: 120; R_0805_2012Metric
R26: 4k; R_0805_2012Metric
U1: LT1999-50; MSOP-8_3x3mm_P0.65mm
U2: SN65HVD233; SOIC-8_3.9x4.9mm_P1.27mm

Connections:
+1.5V: U1.6 (REF); also elsewhere on the board
+3.0V: J7.20 (3.0); also elsewhere on the board
+3.3V: C2.2, U2.3 (VCC); also elsewhere on the board
+5V: R26.1, U1.1 (VCC); also elsewhere on the board
CANH: J8.2, JP1.2 (B), U2.7 (CANH); also elsewhere on the board
CANL: J8.1, R1.1, U2.6 (CANL); also elsewhere on the board
G1_IN: J7.5 (A8); also elsewhere on the board
G2_IN: J7.2 (B13); also elsewhere on the board
G3_IN: J7.6 (A9); also elsewhere on the board
G4_IN: J7.3 (B14); also elsewhere on the board
GND: C2.1, C4.2, J7.19 (G), U1.5 (GND), U2.2 (GND), U2.5 (LBK), U2.8 (Rs); also elsewhere on the board
IS+: U1.2 (+IN); also elsewhere on the board
IS-: U1.3 (-IN); also elsewhere on the board
unnamed: C4.1, U1.4 (VCC)
unnamed: JP1.1 (A), R1.2
unnamed: R26.2, U1.8 (~SHDN)
RX: J7.16 (B8), U2.4 (R)
Sp_A: J7.31 (A6); also elsewhere on the board
Sp_B: J7.32 (A7); also elsewhere on the board
TX: J7.17 (B9), U2.1 (D)
V_Isense: J7.26 (A1), U1.7 (OUT)

Notes on the sheet:
SN65HVD233QDRQ1

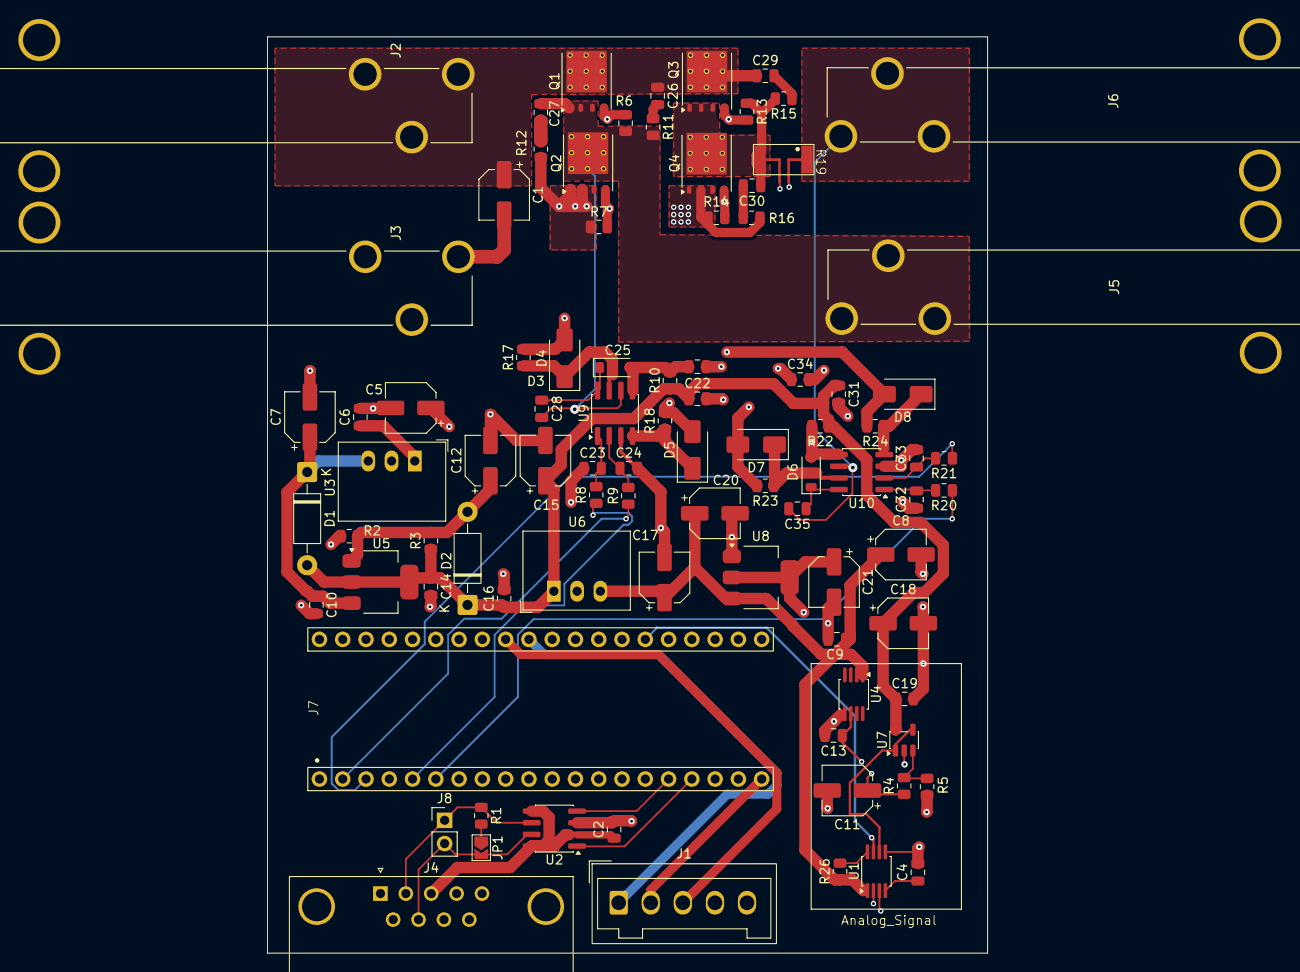
[picture p180: board BM107_V6_Layout.kicad_pcb from above]

Board: 4 copper layers, 78.6 x 100.0 mm, 90 parts (0 on the bottom side), 49 nets.
