QuarkBaellchen5/active-balancing/Aktive_Balancing/KiCAD/BMT.kicad_pcb

## KiCad design Aktive_Balancing/KiCAD/BMT.kicad_pcb (2026-04-06)

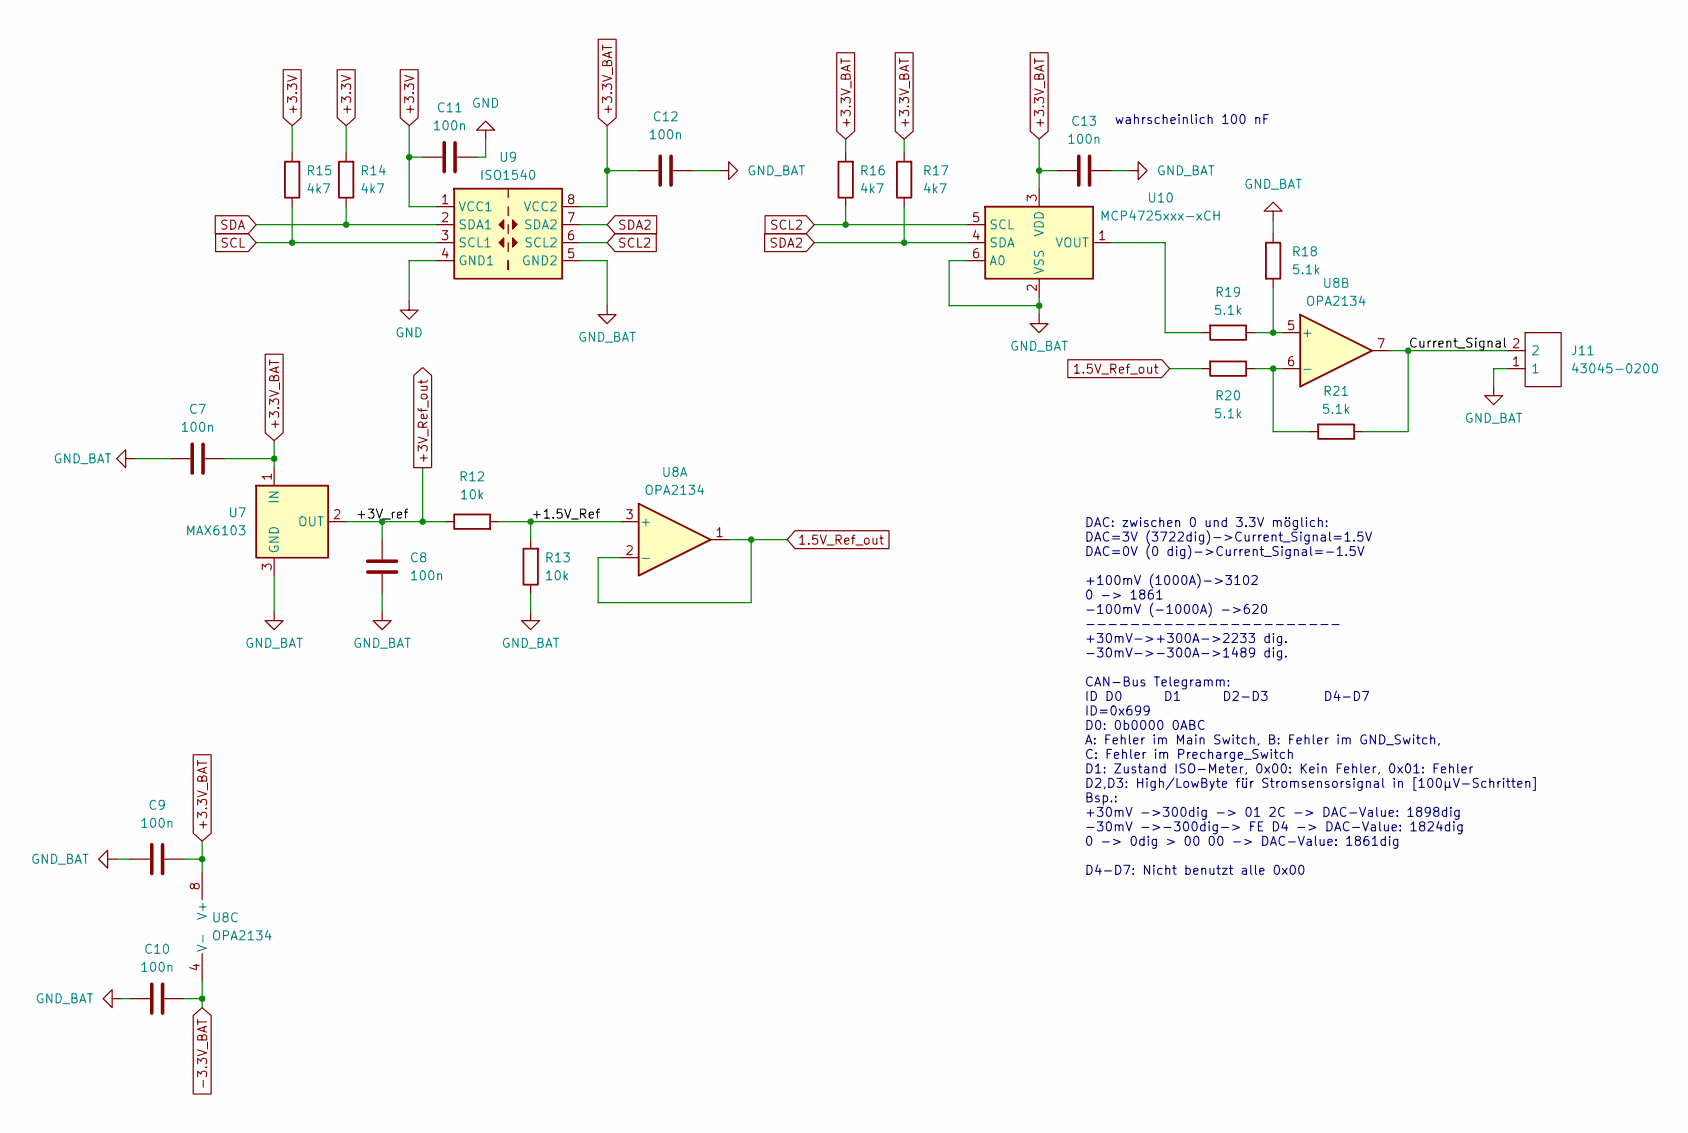
[picture p181: schematic Strom_Emulation.kicad_sch, BMT]

Parts:
C7, C8, C9, C10, C11, C12, C13: 100n; C_0603_1608Metric_Pad1.08x0.95mm_HandSolder
J11: 43045-0200; Manufacturer_Part_Number 43045-0200
R12, R13: 10k; R_0603_1608Metric
R14, R15, R16, R17: 4k7; R_0603_1608Metric
R18, R19, R20, R21: 5.1k; R_0603_1608Metric
U7: MAX6103; SOT-23
U8: OPA2134; SO-8_3.9x4.9mm_P1.27mm
U9: ISO1540; SOIC-8_3.9x4.9mm_P1.27mm; Mouser Part No 595-ISO1540DR
U10: MCP4725xxx-xCH; SOT-23-6; Mouser Part No 579-MCP4725A0TECH

Connections:
1.5V_Ref_out: R20.2, U8.1, U8.2 (-)
+3.3V: C11.1, R14.2, R15.2, U9.1 (VCC1); also elsewhere on the board
+3.3V_BAT: C7.2, C9.2, C12.1, C13.1, R16.2, R17.2, U7.1 (IN), U8.8 (V+), U9.8 (VCC2), U10.3 (VDD); also elsewhere on the board
+3V_Ref_out: C8.2, R12.1, U7.2 (OUT)
-3.3V_BAT: C10.2, U8.4 (V-); also elsewhere on the board
/Strom_Emulation/+1.5V_Ref: R12.2, R13.2, U8.3 (+)
/Strom_Emulation/Current_Signal: J11.2, R21.1, U8.7
GND: C11.2, U9.4 (GND1); also elsewhere on the board
GND_BAT: C7.1, C8.1, C9.1, C10.1, C12.2, C13.2, J11.1, R13.1, R18.1, U7.3 (GND), U9.5 (GND2), U10.2 (VSS), U10.6 (A0); also elsewhere on the board
unnamed: R18.2, R19.1, U8.5 (+)
unnamed: R20.1, R21.2, U8.6 (-)
unnamed: R19.2, U10.1 (VOUT)
SCL: R15.1, U9.3 (SCL1); also elsewhere on the board
SCL2: R16.1, U9.6 (SCL2), U10.5 (SCL)
SDA: R14.1, U9.2 (SDA1); also elsewhere on the board
SDA2: R17.1, U9.7 (SDA2), U10.4 (SDA)

Notes on the sheet:
wahrscheinlich 100 nF
DAC: zwischen 0 und 3.3V möglich: DAC=3V (3722dig)->Current_Signal=1.5V DAC=0V (0 dig)->Current_Signal=-1.5V +100mV (1000A)->3102 0 -> 1861 -100mV (-1000A) ->620 ----------------------- +30mV->+300A->2233 dig. -30mV->-300A->1489 dig. CAN-Bus Telegramm: ID D0 D1 D2-D3 D4-D7 ID=0x699 D0: 0b0000 0ABC 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

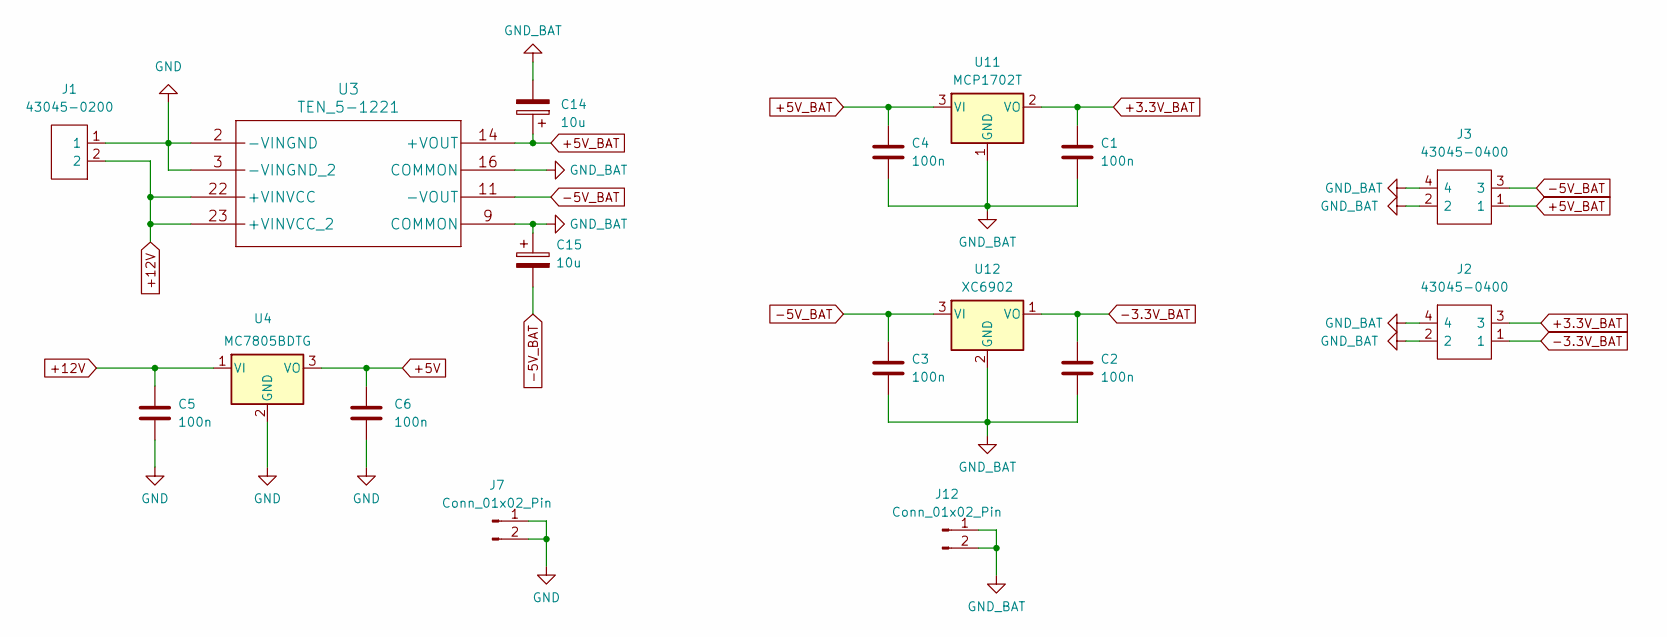
[picture p182: schematic Power_Supplies_sch.kicad_sch, BMT]

Parts:
C1, C2, C3, C4, C5, C6: 100n; C_0603_1608Metric_Pad1.08x0.95mm_HandSolder
C14, C15: 10u; CP_Elec_6.3x3.9
J1: 43045-0200; Manufacturer_Part_Number 43045-0200
J2, J3: 43045-0400; Manufacturer_Part_Number 43045-0400
J7, J12: Conn_01x02_Pin; PinHeader_1x02_P2.54mm_Vertical
U3: TEN_5-1221; TEN5_TRP
U4: MC7805BDTG; TO-252-3_TabPin4; Mouser Part No 863-MC7805CDTG
U11: MCP1702T; SOT-23; MANUFACTURER_PART_NUMBER MCP1702T-3302E/CB
U12: XC6902; SOT-23; MANUFACTURER_PART_NUMBER XC6902N331MR-G

Connections:
+3.3V_BAT: C1.1, J2.3, U11.2 (VO); also elsewhere on the board
+5V: C6.1, U4.3 (VO); also elsewhere on the board
+5V_BAT: C4.1, C14.1, J3.1, U3.14 (+VOUT), U11.3 (VI)
+12V: C5.1, J1.2, U3.22 (+VINVCC), U3.23 (+VINVCC_2), U4.1 (VI); also elsewhere on the board
-3.3V_BAT: C2.1, J2.1, U12.1 (VO); also elsewhere on the board
-5V_BAT: C3.1, C15.2, J3.3, U3.11 (-VOUT), U12.3 (VI)
GND: C5.2, C6.2, J1.1, J7.1, J7.2, U3.2 (-VINGND), U3.3 (-VINGND_2), U4.2 (GND); also elsewhere on the board
GND_BAT: C1.2, C2.2, C3.2, C4.2, C14.2, C15.1, J2.2, J2.4, J3.2, J3.4, J12.1, J12.2, U3.9 (COMMON), U3.16 (COMMON), U11.1 (GND), U12.2 (GND); also elsewhere on the board

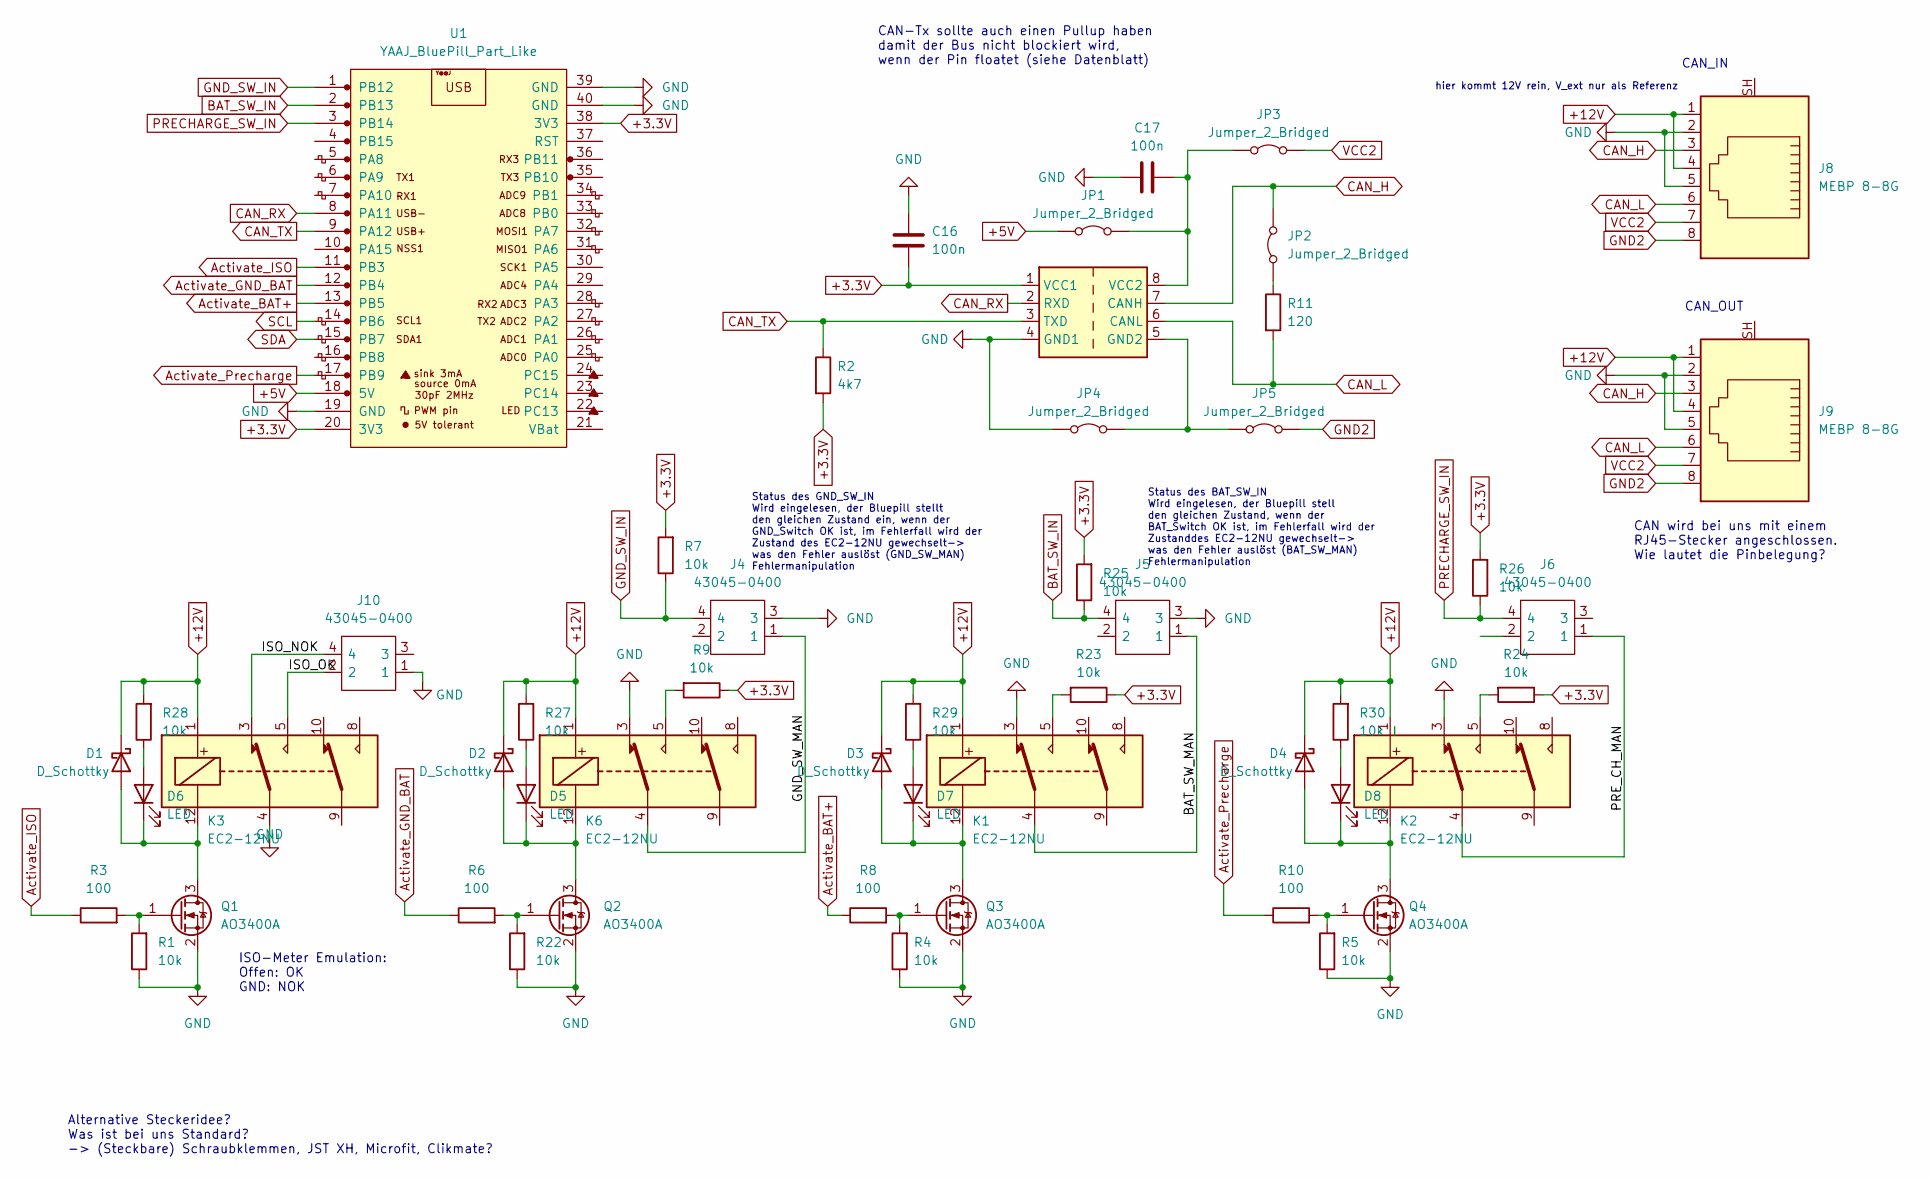
[picture p183: schematic BluePill_CAN_Relais_Status.kicad_sch, BMT]

Parts:
C16, C17: 100n; C_0603_1608Metric_Pad1.08x0.95mm_HandSolder
D1, D2, D3, D4: D_Schottky; D_SOD-323_HandSoldering; MANUFACTURER_PART_NUMBER 1N5819WS; LCSC Part Number C191023
D5, D6, D7, D8: LED; LED_0603_1608Metric_Pad1.05x0.95mm_HandSolder
J4, J5, J6, J10: 43045-0400; Manufacturer_Part_Number 43045-0400
J8, J9: MEBP 8-8G
JP1, JP2, JP3, JP4, JP5: Jumper_2_Bridged; PinHeader_1x02_P2.54mm_Vertical
K1, K2, K3, K6: EC2-12NU; Relay_DPDT_Kemet_EC2
Q1, Q2, Q3, Q4: AO3400A; SOT-23
R1, R4, R5, R7, R9, R22, R23, R24, R25, R26, R27, R28, R29, R30: 10k; R_0603_1608Metric
R2: 4k7; R_0603_1608Metric
R3, R6, R8, R10: 100; R_0603_1608Metric
R11: 120; R_0603_1608Metric
U1: YAAJ_BluePill_Part_Like; YAAJ_BluePill_1
U2: ISO1050DUB; SOP-8_6.62x9.15mm_P2.54mm

Connections:
+3.3V: C16.2, R2.2, R7.2, R9.1, R23.1, R24.1, R25.2, R26.2, U1.20 (3V3), U1.38 (3V3), U2.1 (VCC1); also elsewhere on the board
+5V: JP1.1 (A), U1.18 (5V); also elsewhere on the board
+12V: D1.1 (K), D2.1 (K), D3.1 (K), D4.1 (K), J8.1, J8.4, J9.1, J9.4, K1.1, K2.1, K3.1, K6.1, R27.2, R28.2, R29.2, R30.2; also elsewhere on the board
/BluePill_CAN_Relais_Status/BAT_SW_MAN: J5.1, K1.4
/BluePill_CAN_Relais_Status/GND_SW_MAN: J4.1, K6.4
/BluePill_CAN_Relais_Status/ISO_NOK: J10.4, K3.3
/BluePill_CAN_Relais_Status/ISO_OK: J10.2, K3.5
/BluePill_CAN_Relais_Status/PRE_CH_MAN: J6.1, K2.4
Activate_BAT+: R8.1, U1.13 (PB5)
Activate_GND_BAT: R6.1, U1.12 (PB4)
Activate_ISO: R3.1, U1.11 (PB3)
Activate_Precharge: R10.1, U1.17 (PB9)
BAT_SW_IN: J5.4, R25.1, U1.2 (PB13)
CAN_H: J8.3, J9.3, JP2.2 (B), U2.7 (CANH)
CAN_L: J8.6, J9.6, R11.2, U2.6 (CANL)
CAN_RX: U1.8 (PA11), U2.2 (RXD)
CAN_TX: R2.1, U1.9 (PA12), U2.3 (TXD)
GND: C16.1, C17.1, J4.3, J5.3, J8.2, J8.5, J9.2, J9.5, J10.1, JP4.1 (A), K1.3, K2.3, K3.4, K6.3, Q1.2 (S), Q2.2 (S), Q3.2 (S), Q4.2 (S), R1.1, R4.1, R5.1, R22.1, U1.19 (GND), U1.39 (GND), U1.40 (GND), U2.4 (GND1); also elsewhere on the board
GND2: J8.8, J9.8, JP5.2 (B)
GND_SW_IN: J4.4, R7.1, U1.1 (PB12)
unnamed: D1.2 (A), D6.1 (K), K3.12, Q1.3 (D)
unnamed: D2.2 (A), D5.1 (K), K6.12, Q2.3 (D)
unnamed: D3.2 (A), D7.1 (K), K1.12, Q3.3 (D)
unnamed: D4.2 (A), D8.1 (K), K2.12, Q4.3 (D)
unnamed: D5.2 (A), R27.1
unnamed: D6.2 (A), R28.1
unnamed: D7.2 (A), R29.1
unnamed: D8.2 (A), R30.1
unnamed: C17.2, JP1.2 (B), JP3.1 (A), U2.8 (VCC2)
unnamed: JP2.1 (A), R11.1
unnamed: JP4.2 (B), JP5.1 (A), U2.5 (GND2)
unnamed: K1.5, R23.2
unnamed: K2.5, R24.2
unnamed: K6.5, R9.2
unnamed: Q1.1 (G), R1.2, R3.2
unnamed: Q2.1 (G), R6.2, R22.2
unnamed: Q3.1 (G), R4.2, R8.2
unnamed: Q4.1 (G), R5.2, R10.2
PRECHARGE_SW_IN: J6.4, R26.1, U1.3 (PB14)
SCL: U1.14 (PB6); also elsewhere on the board
SDA: U1.15 (PB7); also elsewhere on the board
VCC2: J8.7, J9.7, JP3.2 (B)

Notes on the sheet:
Status des GND_SW_IN Wird eingelesen, der Bluepill stellt den gleichen Zustand ein, wenn der GND_Switch OK ist, im Fehlerfall wird der Zustand des EC2-12NU gewechselt-> was den Fehler auslöst (GND_SW_MAN) Fehlermanipulation
ISO-Meter Emulation: Offen: OK GND: NOK
CAN-Tx sollte auch einen Pullup haben damit der Bus nicht blockiert wird, wenn der Pin floatet (siehe Datenblatt)
Alternative Steckeridee? Was ist bei uns Standard? -> (Steckbare) Schraubklemmen, JST XH, Microfit, Clikmate?
CAN_OUT
CAN wird bei uns mit einem RJ45-Stecker angeschlossen. Wie lautet die Pinbelegung?
Status des BAT_SW_IN Wird eingelesen, der Bluepill stell den gleichen Zustand, wenn der BAT_Switch OK ist, im Fehlerfall wird der Zustanddes EC2-12NU gewechselt-> was den Fehler auslöst (BAT_SW_MAN) Fehlermanipulation
hier kommt 12V rein, V_ext nur als Referenz
CAN_IN

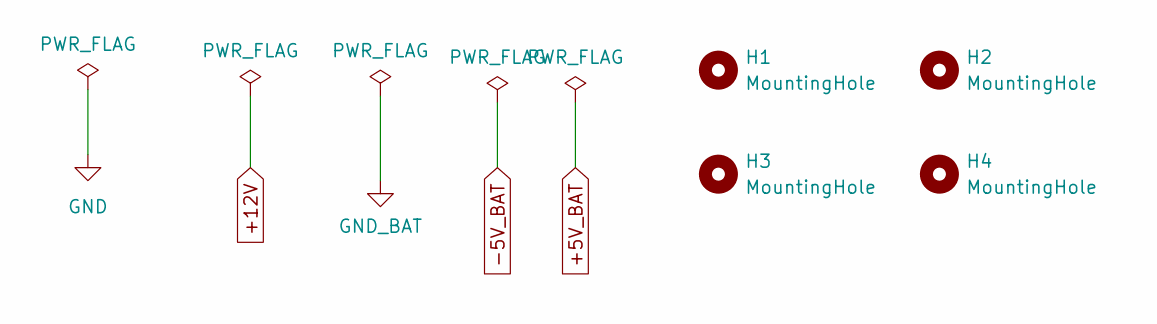
[picture p184: schematic Power_Flags.kicad_sch, BMT]

Parts:
H1, H2, H3, H4: MountingHole; MountingHole_3.2mm_M3_DIN965_Pad

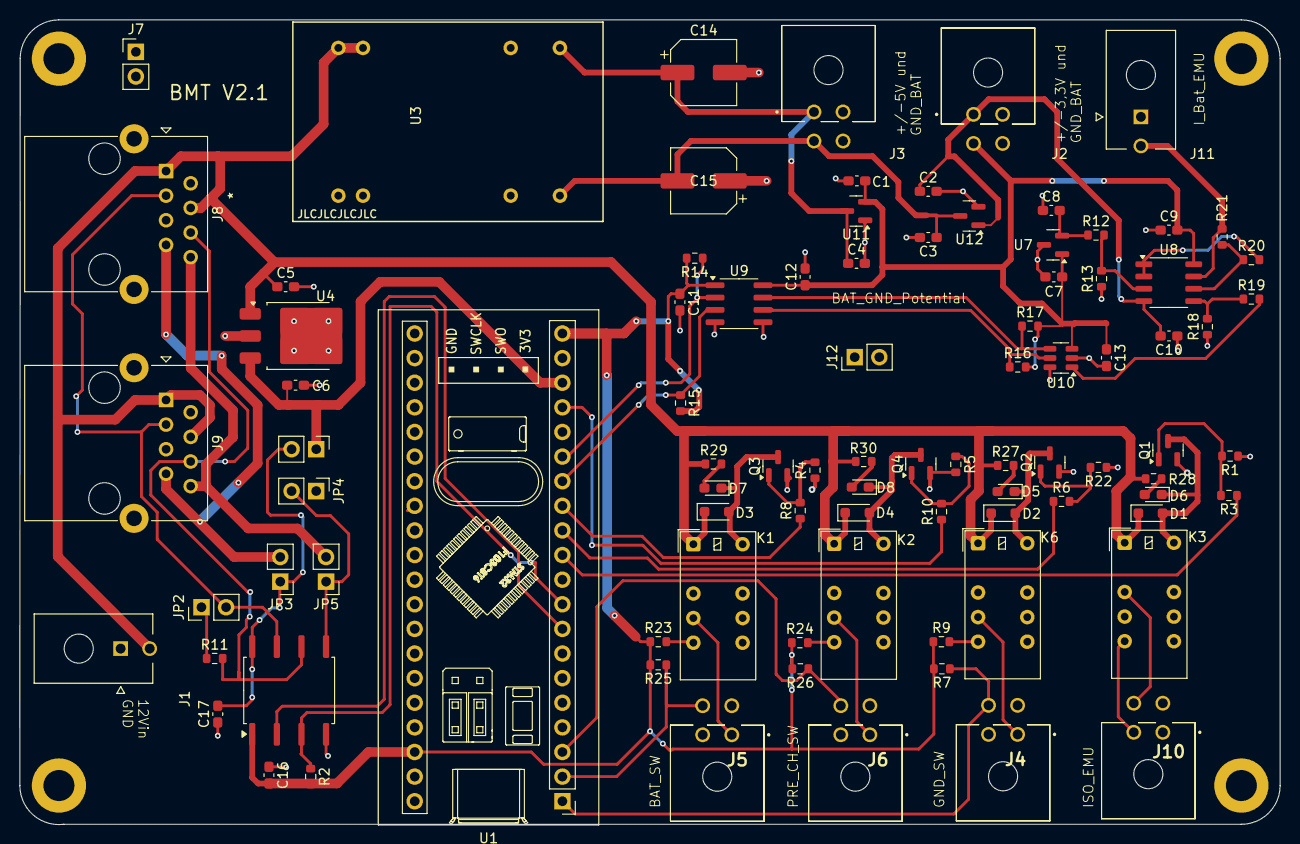
[picture p185: board BMT.kicad_pcb from above]

Board: 2 copper layers, 130.0 x 83.0 mm, 94 parts (0 on the bottom side), 56 nets.
