QuarkBaellchen5/active-balancing/Aktive_Balancing/STM_BMT/BMT_Project.zip_expanded/BMT/BMT.ioc

Mcu.UserName=STM32F103C8Tx
PA11.Signal=CAN_RX
PA12.Signal=CAN_TX
PA13.Signal=SYS_JTMS-SWDIO
PA14.Signal=SYS_JTCK-SWCLK
PB12.GPIO_Label=GND_SW_IN
PB12.Signal=GPIO_Input
PB13.GPIO_Label=BAT_SW_in
PB13.Signal=GPIO_Input
PB14.GPIO_Label=PreCh_SW_in
PB14.Signal=GPIO_Input
PB3.GPIO_Label=Activate_ISO
PB3.Signal=GPIO_Output
PB4.GPIO_Label=Activate_GND_BAT
PB4.Signal=GPIO_Output
PB5.GPIO_Label=Avtivate_Bat_Plus
PB5.Signal=GPIO_Output
PB6.Signal=I2C1_SCL
PB7.Signal=I2C1_SDA
PB9.GPIO_Label=Acivate_Precharche
PB9.Signal=GPIO_Output
PD0-OSC_IN.Signal=RCC_OSC_IN
PD1-OSC_OUT.Signal=RCC_OSC_OUT
