QuarkBaellchen5/active-balancing/(commit log)

2026-04-06 temp save
    [BMT.kicad_pcb, BMT.kicad_sch, BluePill_CAN_Relais_Status.kicad_sch, Power_Flags.kicad_sch, Power_Supplies_sch.kicad_sch, Strom_Emulation.kicad_sch, ten5_dual_3d_drawing.stp]
2026-04-06 Schalter gegen Mosfet
    versucht den schalter zu tauschen aber der strom wird dann nicht mehr geregelt
2026-04-08 Modell für Baustein VOM1271
    [J201_IV_Sweep.sch, PVI5050.sch, PVI5050N_DC.sch, PVI5050N_TRAN.sch, PVI5050N_sub.sch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]
2026-04-10 mosfet action
2026-04-10 KiCad Directory hinzugefügt
    [BMT.kicad_pcb, BMT.kicad_sch, BluePill_CAN_Relais_Status.kicad_sch, Power_Flags.kicad_sch, Power_Supplies_sch.kicad_sch, Strom_Emulation.kicad_sch, ten5_dual_3d_drawing.stp]
2026-04-19 Bauteilliste und erste Datasheets
    [Bauteile.xlsx]
2026-04-20 Simulation pptimiert
    Highside Lowside Mosfet
    rückkopplugn über OP
2026-04-20 kicad angefangen
    [Aktive_Bal.kicad_pcb, Aktive_Bal.kicad_sch]
2026-04-21 Mit I2C Koppler neu
    [Bauteile.xlsx]
2026-04-21 kicad änderungen
2026-04-21 kicad weiter
    [Aktive_Bal.kicad_sch]
2026-04-24 Neue Bestelliste
    [Bauteile.xlsx, Bestellliste_DigiKey_V1.xlsx, Bestellliste_DigiKey_V2.xlsx]
2026-04-25 Kicad klopf klopf klopf
    [ADUM1250ARZ-RL7_R_8_ADI.step, Aktive_Bal.kicad_sch, LM1117IMPX-3.3NOPB_DCY0004A.stp, LTV-847S.step]
2026-04-30 kicad widerstand
    [Aktive_Bal.kicad_sch]
2026-04-30 kicad gewurstel
    [LTV-847S.step]
2026-05-04 kicad klopf klopf
    [Aktive_Bal.kicad_sch]
2026-05-04 kicad weiter weiter
    [Aktive_Bal.kicad_sch]
2026-05-07 fehler im Kicad
    [Aktive_Bal.kicad_sch]
2026-05-12 kicad bla bla
    [Aktive_Bal.csv, Aktive_Bal.kicad_sch, KiCad Export.xlsx]
2026-05-13 Neue Bestellliste
    [Bestellliste_DigiKey_V4.xlsx]
2026-05-13 kicad export
    [Aktive_Bal.csv, Aktive_Bal.kicad_sch, KiCad Export v2.xlsx]
2026-05-17 Kicad Footprints
    [Aktive_Bal.kicad_sch]
2026-05-17 footprints zuggewiesen
    [Aktive_Bal.kicad_sch]
2026-05-19 Neue Datasheets und Leistungsberechnung
    [Leistungsaufnahme 5V Schaltung.xlsx]
2026-05-21 mosfet symbol
2026-05-21 Optokram und Widerstände
    [Bestellliste_DigiKey_V5.xlsx]
2026-05-21 kicad sub strukturen
    Den schaltplan in kleinere aufgeteilt
    [Aktive_Bal.kicad_sch, controller.kicad_sch, power_mosfet.kicad_sch]
2026-05-29 kicad bom
    [Aktive_Bal.csv, Aktive_Bal.kicad_sch, KiCad Export v4.xlsx, controller.kicad_sch]
2026-05-31 Bestelliste V6
    [Bestellliste_DigiKey_V6.xlsx]
2026-06-01 kondensator an den 3.3V µc
    den kondensator an der Stiftleiste vom mikrokontroller geändert zu einem Bulk kondensator
    [Aktive_Bal.kicad_sch]
2026-06-03 Neue Liste
    [Bestellliste_DigiKey_V6.xlsx, Bestellliste_DigiKey_V7.xlsx]
2026-06-07 layout
    Komponenten geordnet
    [Aktive_Bal.kicad_pcb, Aktive_Bal.kicad_sch]
2026-06-11 BM107 V6 Dateien
    Geht Gideon garnichts an!!!
    [BM107_V6_Layout.kicad_pcb, BM107_V6_Layout.kicad_sch, H_Bruecke.kicad_sch, Microcontroller_Schaltung.kicad_sch, Spannungsversorgungen.kicad_sch]
2026-06-11 Schaltung Review + Layout
    Schaltung Review + Layout
    [Aktive_Bal.kicad_pcb, Aktive_Bal.kicad_sch, controller.kicad_sch, power_mosfet.kicad_sch]
2026-06-11 geht gideon immer noch nichts an
    [PC5930T.step, STM32_blue_pill.kicad_pcb, STM32_blue_pill.kicad_sch]
2026-06-12 neuer stand
    [Aktive_Bal.kicad_pcb, Aktive_Bal.kicad_sch, power_mosfet.kicad_sch]
2026-06-12 Bisschen sortiert und so
    [Aktive_Bal.kicad_pcb, Aktive_Bal.kicad_sch]
2026-06-15 qwertzui
    qwertzu
    [Aktive_Bal.kicad_pcb]
2026-06-15 Regelkreis sortiert
    [Aktive_Bal.kicad_pcb, controller.kicad_sch]
2026-06-16 test
    test
    [Aktive_Bal.kicad_pcb]
2026-06-16 mein stand gestern abend
    [Aktive_Bal.kicad_pcb, Aktive_Bal.kicad_sch]
2026-06-16 Layout kompakter gemacht
    Ich habe die Sektion mit dem Mosfets gemacht. Weber hat es nicht anders gewollt...
    [Aktive_Bal.kicad_pcb, power_mosfet.kicad_sch]
2026-06-17 Microcontroller geroutet
    [Aktive_Bal.kicad_pcb]
2026-06-22 beschriftung der pins
    [Aktive_Bal.kicad_pcb]
2026-06-22 alles neu
    [Aktive_Bal.kicad_pcb, controller.kicad_sch, power_mosfet.kicad_sch]
2026-06-22 opto verschobnen und krams
    [Aktive_Bal.kicad_pcb]
2026-06-23 bm107 neu
    [BM107_V6_Layout.csv, BM107_V6_Layout.kicad_pcb, BM107_V6_Layout.kicad_sch, H_Bruecke.kicad_sch, Microcontroller_Schaltung.kicad_sch, Stückliste_mit_Kosten.xlsx]
2026-06-23 qwert
    qer
    [Aktive_Bal.kicad_pcb]
2026-06-23 Layout fürs erste fertig gemacht
    Erste vollständig geroutete Version; Silkscreens sind auch halbwegs gut
    [Aktive_Bal.kicad_pcb]
2026-06-23 quetschen
    brücken getauscht
    [Aktive_Bal.kicad_pcb]
2026-06-23 ASDF
    ASDF
    [Aktive_Bal.kicad_sch]
2026-06-24 bisschen abstände und so
    [Aktive_Bal.kicad_pcb, Bestellliste_Spannungsfeste Bauteile.xlsx]
2026-06-24 bm107 abgabe
    [BM107_V6_Layout.csv, BM107_V6_Layout.kicad_pcb, BM107_V6_Layout.kicad_sch, BOM.xlsx, Bluepill.kicad_sch, H_Bruecke.kicad_sch, Microcontroller_Schaltung.kicad_sch, STM32_blue_pill.kicad_pcb]
2026-06-24 Kleine Änderung canbus
    [Aktive_Bal.kicad_pcb]
2026-06-24 Kleine Änderung an BM107 V6 BOM
    Einzelpreis
    [BOM.xlsx]
2026-06-26 Vorläufige finale Version
    Diese Version soll in die Fertigung gehen.
    [Aktive_Bal-B_Cu.gbr, Aktive_Bal-B_Mask.gbr, Aktive_Bal-B_Paste.gbr, Aktive_Bal-B_Silkscreen.gbr, Aktive_Bal-Edge_Cuts.gbr, Aktive_Bal-F_Cu.gbr, Aktive_Bal-F_Mask.gbr, Aktive_Bal-F_Paste.gbr]
2026-07-02 bmschießmichtot
    [BM107_V6_Layout.kicad_pcb, BM107_V6_Layout.kicad_sch, H_Bruecke.kicad_sch, Microcontroller_Schaltung.kicad_sch, Spannungsversorgungen.kicad_sch, Stückliste_mit_Kosten.xlsx]
2026-07-05 bm107 geroutet
    [BM107_V6_Layout.kicad_pcb]
2026-07-18 bm107 v7 abgabe
    [BM107_V6_Layout.csv, BM107_V6_Layout.kicad_pcb, BM107_V6_Layout.kicad_sch, Bluepill.kicad_sch, H_Bruecke.kicad_sch, Microcontroller_Schaltung.kicad_sch, STM32_blue_pill.kicad_pcb, STM32_blue_pill.kicad_sch]
2026-07-29 Alles schöner und 3d
    [A-DF_09_A_KG-T4S.step, ADUM1250ARZ-RL7_R_8_ADI.step, A_DF_09_A_KG_T4S--3DModel-STEP-1.STEP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]
2026-07-31 Alles so schön neu
    [A-DF_09_A_KG-T4S.step, ADUM1250ARZ-RL7_R_8_ADI.step, A_DF_09_A_KG_T4S--3DModel-STEP-1.STEP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]
2026-08-01 Überprüfung von Schaltplan
    Überprüfung von Schaltplan
    [Aktive_Bal.kicad_sch, Spannungsversorgung.kicad_sch, controller.kicad_sch, power_mosfet.kicad_sch]
2026-08-15 Neuer Ordner "Software"
    Ich habe mal den aktuellen Stand der Software hochgeladen.
2026-08-18 sachen halt
    [A-DF_09_A_KG-T4S.step, ADUM1250ARZ-RL7_R_8_ADI.step, A_DF_09_A_KG_T4S--3DModel-STEP-1.STEP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]
2026-08-26 zeug bericht und soi
    [Regelkreis Messwerte.xlsx, Temperaturmessung Platine.xlsx]
2026-09-02 neuneu code und so
    [Aktive_Bal.kicad_pcb, Aktive_Bal.kicad_sch]
2026-09-06 PWR Mosfet
    PWR Mosfet wird nun angesteuert.
2026-09-09 neu mit mosfet
2026-09-09 hab gekocht
    [A-DF_09_A_KG-T4S.step, ADUM1250ARZ-RL7_R_8_ADI.step, A_DF_09_A_KG_T4S--3DModel-STEP-1.STEP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]
2026-09-12 mosfets verkabelt elkos getauscht
    [Aktive_Bal.kicad_pcb, Spannungsversorgung.kicad_sch, power_mosfet.kicad_sch]
2026-09-16 Anleitung für die Platine
    für die ganz Dummen
