QuarkBaellchen5/active-balancing/(notices)

Notices in the files:
Software/STM32_Aktive_Balancing/Core/Src/main.c:
Copyright (c) 2026 STMicroelectronics.
All rights reserved.
This software is licensed under terms that can be found in the LICENSE file
